stickkersz/greenhouse-iot-smart-farm/Hardware_Checklist.md

# 🔧 Hardware Checklist — BOM สมบูรณ์
**โปรเจกต์: IoT Smart Farm | อัปเดต: มิถุนายน 2569**

---

## สรุปสถานะ

| สถานะ | จำนวน |
|---|---|
| ✅ มีแล้ว / ซื้อมาแล้ว | 8 รายการ |
| 🛒 ต้องซื้อเพิ่ม | 11 รายการ |
| ⏳ รอของมาส่ง | 3 รายการ |

---

## ✅ มีแล้ว / ซื้อมาแล้ว

| # | อุปกรณ์ | จำนวน | สถานะ | หมายเหตุ |
|---|---|---|---|---|
| 1 | **ESP32 DevKit V1** | 1 | ✅ มีแล้ว | Dual-core, WiFi+BT, 30 pin |
| 2 | **Relay Module 4CH** (5V) | 1 | ✅ ซื้อแล้ว | ใน invoice QT0165876 |
| 3 | **DS18B20 Waterproof** | 1 | ✅ ซื้อแล้ว | วัดอุณหภูมิน้ำ |
| 4 | **XL4015 Step-Down 5A** | 1 | ✅ ซื้อแล้ว | 12V → 5V (ESP32 + Relay) |
| 5 | **Boost Converter 400W** | 1 | ✅ ซื้อแล้ว | 12V → 24V (ปั๊มน้ำ) |
| 6 | **ปั๊มน้ำ DC 24V Mini** | 1 | ⏳ รอส่ง | ทดสอบแรงดันก่อน — อาจต้องเปลี่ยน |
| 7 | **S-120-12 PSU** (12V 10A) | 1 | ✅ มีแล้ว | PSU หลัก (120W) |
| 8 | **Fan Module 5V** | 1 | ✅ ซื้อแล้ว | ระบายความร้อนในกล่อง IP65 — ต่อตรง XL4015 ไม่ผ่าน Relay |

---

## ⏳ รอของมาส่ง

| # | อุปกรณ์ | จำนวน | หมายเหตุ |
|---|---|---|---|
| 6 | **ปั๊มน้ำ DC 24V Mini** | 1 | ⚠️ ทดสอบแรงดันก่อน — ถ้าไม่ถึง 14 Bar ต้องเปลี่ยน |
| — | (รายการอื่นจาก invoice QT0165876) | — | รอส่ง |

---

## 🛒 ต้องซื้อเพิ่ม

### 🌡️ Sensor

| # | อุปกรณ์ | จำนวน | ราคาประมาณ | ซื้อที่ไหน | หมายเหตุ |
|---|---|---|---|---|---|
| 9 | **SHT40** (Temp + Humidity) | 1 | ~150–250฿ | Shopee / Lazada | แทน DHT22 — แม่นยำกว่า, I2C |
| 10 | **Capacitive Soil Moisture** | 1 | ~50–80฿ | Shopee | ไม่กัดกร่อน — ดีกว่าแบบ Resistive |

### 💧 ระบบน้ำ

| # | อุปกรณ์ | จำนวน | ราคาประมาณ | ซื้อที่ไหน | หมายเหตุ |
|---|---|---|---|---|---|
| 11 | **ถัง HDPE 100L** | 1 | ~300–500฿ | ร้านวัสดุภัณฑ์ / Lazada | เก็บน้ำ |
| 12 | **หัวฉีดหมอก** (รอยืนยันประเภท) | 18 | ~10–50฿/ชิ้น | Shopee | ⚠️ ขึ้นอยู่กับแรงดันปั๊ม |
| | — Option A: หัวฉีด 0.3mm (High Pressure) | 18 | ~30–50฿/ชิ้น | Shopee | ต้องการปั๊ม High Pressure ≥ 14 Bar |
| | — Option B: หัวฉีด Low Pressure | 18 | ~10–20฿/ชิ้น | Shopee | ใช้กับปั๊มมินิได้ (< 3 Bar) |
| 13 | **ท่อ PE 3/8"** | 20 เมตร | ~200–300฿ | ร้านวัสดุก่อสร้าง | ท่อหลักระบบน้ำ |
| 14 | **ข้อต่อท่อ PE** (T-joint, elbow, etc.) | ชุด | ~100–200฿ | ร้านวัสดุก่อสร้าง | ต่อสาขาหัวฉีด 3 แถว |
| 15 | **ปั๊มน้ำ High Pressure** (ถ้าเปลี่ยน) | 1 | ~1,000–3,000฿ | Shopee / Lazada | เฉพาะถ้าปั๊มมินิแรงดันไม่พอ |

### 💡 ไฟ LED

> ❌ **ยกเลิก** — ไม่ใช้ LED Grow Light ในโปรเจกต์นี้แล้ว

### 🌬️ พัดลม

| # | อุปกรณ์ | จำนวน | ราคาประมาณ | ซื้อที่ไหน | หมายเหตุ |
|---|---|---|---|---|---|
| 17 | **พัดลมชัตเตอร์แรงโน้มถ่วง 10"** AC 220V | 2 | ~500–800฿/ตัว | Shopee / ร้านไฟฟ้า | ระบายอากาศโรงเรือน — IN ขวา (Relay CH3), OUT ซ้าย (Relay CH2) |

### 🔌 ระบบไฟและกล่องควบคุม

| # | อุปกรณ์ | จำนวน | ราคาประมาณ | ซื้อที่ไหน | หมายเหตุ |
|---|---|---|---|---|---|
| 18 | **RCBO 16A** (กันดูดกันไฟกระชาก) | 1 | ~300–500฿ | ร้านไฟฟ้า | ป้องกัน PSU + พัดลม AC |
| 19 | **Control Box IP65** | 1 | ~200–400฿ | Shopee / ร้านไฟฟ้า | กล่องพลาสติกกันน้ำ ใส่ ESP32 + PSU |
| 20 | **PG16 Cable Gland** | 4 | ~20–40฿/ชิ้น | Shopee / ร้านไฟฟ้า | รูดายสายเข้ากล่อง IP65 |
| 21 | **ท่อ PVC 20mm** + ข้อต่อ | 5 เมตร | ~100฿ | ร้านวัสดุก่อสร้าง | เดินสายไฟ AC 220V นอกโรงเรือน |

---

## 💰 สรุปงบประมาณ

| หมวด | ราคาประมาณ |
|---|---|
| ซื้อแล้ว (invoice QT0165876) | 1,705฿ |
| S-120-12 PSU | ~600–800฿ |
| Sensor (SHT40 + Soil) | ~200–330฿ |
| ระบบน้ำ (ถัง + ท่อ + หัวฉีด + ข้อต่อ) | ~700–1,200฿ |
| LED 12V DC × 2 | ~600–1,200฿ |
| พัดลม × 2 | ~1,000–1,600฿ |
| ไฟและกล่องควบคุม | ~800–1,300฿ |
| ปั๊ม High Pressure (ถ้าต้องเปลี่ยน) | ~1,000–3,000฿ |
| **รวมทั้งหมด (ประมาณ)** | **~5,000–8,000฿** |

---

## ⚠️ จุดที่ต้องตัดสินใจก่อนซื้อ

### 1. ปั๊มน้ำ — ทดสอบแรงดันก่อน!
**เมื่อปั๊มมินิ 24V มาส่ง:**
- ต่อ Boost Converter → วัดแรงดันให้ได้ 24V → เปิดปั๊ม
- วัดแรงดันน้ำด้วย pressure gauge (ถ้ามี) หรือสังเกตการพ่นน้ำ
- ถ้าพ่นได้เป็นหมอกละเอียด → ใช้ได้ (Option B: Low Pressure nozzle)
- ถ้าพ่นเป็นสายน้ำ → แรงดันไม่พอ → ต้องซื้อปั๊ม High Pressure (Option A)

### 2. LED — ต้องยืนยันสเปกก่อนซื้อ
- ถามหัวหน้า/อาจารย์ว่าจะปลูกพืชอะไร
- พืชผักทั่วไป: Full Spectrum 3000K–6500K ก็พอ
- พืชดอก/ผล: ต้องการ Red:Blue = 3:1

### 3. หัวฉีด — ขึ้นอยู่กับปั๊ม
ซื้อหัวฉีดหลังจากทดสอบปั๊มแล้วเท่านั้น

---

## 📦 ของที่ต้องสั่งซื้อ (Priority Order)

```
ลำดับความสำคัญ:
1. SHT40               ← ทดสอบ firmware ได้เลย (ไม่ต้องรอปั๊ม)
2. Capacitive Soil      ← ทดสอบ ADC ได้เลย
3. ทดสอบปั๊มที่มี        ← วัดแรงดันก่อนตัดสินใจ
4. หัวฉีด + ท่อ PE       ← ซื้อหลังรู้แรงดันปั๊ม
5. LED 12V DC          ← ซื้อหลังยืนยันประเภทพืช
6. พัดลม 2 ตัว          ← ซื้อเมื่อพร้อมติดตั้ง
7. Control Box + RCBO  ← ซื้อพร้อมกับระยะติดตั้ง
```

---

*จัดทำโดย: Tonkla (IT Intern) | มิถุนายน 2569*
