stickkersz/greenhouse-iot-smart-farm/Greenhouse_Equipment_Layout_v2.md

# 🌿 Greenhouse Equipment Layout v2 (แก้ไขแล้ว)
**อัปเดต: June 2026 | หลังคาเอียง | 3-tier บันได | ปั๊ม 24V 14Bar | Grow Light | 2 พัดลม**

---

## 📐 โครงสร้างที่แก้ไขจาก Layout ที่ User วาด

| ส่วน | รายละเอียด (แก้ไขแล้ว) |
|---|---|
| หลังคา | **เอียง (Shed Roof)** ต่ำด้านหน้า → สูง 270cm ด้านหลัง |
| ประตู | ผนังหน้า (short wall 240cm, ด้านหลังคาต่ำ) |
| Bench | **3 tier ขวางความกว้าง 240cm** เรียงตามความยาว 460cm |
| Tier 1 | ต่ำสุด (~35cm) ใกล้ประตู |
| Tier 2 | กลาง (~65cm) |
| Tier 3 | สูงสุด (~100cm) ใกล้ผนังหลัง/หลังคาสูง |

---

## 💧 ระบบพ่นหมอก (ปรับปรุงแล้ว)

| พารามิเตอร์ | ค่าใหม่ |
|---|---|
| ปั๊ม | **24V DC Diaphragm, 14 Bar** |
| PSU ปั๊ม | Mean Well **S-100-24** (24V 4.5A = 108W) แยกออกจาก S-60-12 |
| หัวฉีด | **ทองเหลือง 0.3mm** (เปลี่ยนจาก 0.1mm) |
| จำนวนหัวฉีด | **6 หัว** (3 cross-bar × 2 หัวต่อ bar) |
| ท่อ cross-bar | 3 เส้นขวาง 240cm (เหนือ Tier 1, 2, 3 ตามลำดับ) |
| 2 หัวต่อ bar | ห่างผนัง 60cm และ 180cm (ครอบคลุม 240cm ด้วย radius ~90cm@14Bar) |
| ความสูงท่อ | ตามความลาดเอียงหลังคา: ~150cm (หน้า) → ~240cm (หลัง) |
| ท่อ PE ขนาด | 6mm OD |

### การเดินท่อ
- **Header pipe**: วิ่งตามผนังยาวด้านใดด้านหนึ่ง → T-connector → แยกเป็น 3 cross-bar
- **จุดเข้าท่อน้ำ**: ผนังหลัง (ด้านหลังคาสูง) มุมบน ระดับ 200cm → Grommet กันน้ำ
- **ถัง 100L**: วางนอกโรงเรือน ด้านหลัง-ตึก **ยกสูง 70cm** (platform คอนกรีต) → ลดแรงดันที่ปั๊มต้องสูบ

---

## 💡 Grow Light ระบบปลูกกลางคืน

| รายการ | รายละเอียด |
|---|---|
| LED Bar | 3 bar (1 bar ต่อ 1 tier) |
| ความยาวแต่ละ bar | **240cm** เต็มความกว้าง |
| ชนิด LED | **Full Spectrum 12V DC** (แนะนำ) หรือ 220V AC LED |
| กำลัง | ~30-50W ต่อ bar |
| ระยะจาก canopy | 30-50cm เหนือยอดต้นไม้ |
| ตำแหน่งยึด | Frame เหล็กระหว่าง tier + hook/สาย |
| ควบคุม | Relay CH4 + Timer module (เปิดอัตโนมัติตามเวลา) |
| ชั่วโมงแสง | 14-18 ชั่วโมง/วัน (ตั้งเวลาตามพืช) |

> ✅ **แนะนำ 12V DC LED**: ปลอดภัยกว่าในสภาพแวดล้อมชื้น ไม่มีไฟ AC ในโรงเรือน

---

## 🌀 พัดลม 2 ตัว

| | FAN 1 (Intake) | FAN 2 (Exhaust) |
|--|---|---|
| ตำแหน่ง | **ผนังหน้า** (กึ่งกลาง short wall) | **ผนังหลัง** (กึ่งกลาง short wall) |
| ระดับ | ~150cm (จำกัดด้วยหลังคาต่ำ) | ~220cm (หลังคาสูง 270cm) |
| ทิศทาง | **ดูดอากาศเข้า** | **ระบายอากาศออก** |
| ประเภท | Gravity Shutter AC 220V 10" | Gravity Shutter AC 220V 10" |
| Relay | CH3 | CH2 |

> อากาศไหล: เย็น/สดเข้าหน้า → ผ่าน tier 1→2→3 → ร้อน/ชื้นออกหลัง ✅

---

## ⚡ ระบบไฟฟ้า

### จุดเดินสายเข้า
- **Entry point**: ผนังหลัง (short wall ด้านหลังคาสูง) ระดับ 200-220cm
- เลือกตรงช่อง **frame เหล็ก** ที่มี **มุ้งกันแดด** (ไม่ใช่แผ่นพลาสติก)
- ใส่ **PG16 Cable Gland** หรือ **Liquid-Tight Connector** กันน้ำ

### เส้นทางสายจาก Control Box
```
ตึก → [ท่อ PVC 20mm] → RCBO 16A 30mA → Control Box IP65 (ผนังนอก-ตึก ระดับ 150cm)
                                                    │
                          ┌─────────────────────────┤
                          │                         │
                    S-60-12 (12V 5A)          S-100-24 (24V 4.5A)
                          │                         │
                   LM2596 (→5V)              Relay CH1 → ปั๊ม 24V (นอกโรง)
                          │
                    ESP32 + 4-Relay
                          │
              ┌───────────┼──────────────┐
              │           │              │
       CH2: FAN OUT  CH3: FAN IN   CH4: LED + DC 12V → เข้าโรงเรือน
       (220V conduit) (220V conduit) (DC 12V safe)
```

### สายภายในโรงเรือน
| สาย | ชนิด | วิ่งตาม |
|-----|---|---|
| DC 12V สำหรับ LED | 2 เส้น (2.5mm²) | rail เหล็กหลังคา → branch ลงแต่ละ tier |
| Signal SHT40 (I2C) | 4 เส้น (28AWG) | ยึดกับ frame ด้วย cable tie |
| Signal Soil Moisture | 3 เส้น | |
| DC 12V → Relay ESP32 | รวมในท่อ PVC 16mm | |

> ⚠️ **ไม่มี 220V AC ในโรงเรือนเลย** ถ้าใช้ LED 12V DC (แนะนำ)
> ⚠️ ถ้าต้องใช้ LED 220V → ให้ร้อยในท่อ rigid PVC ปิดสนิท ไม่สัมผัสน้ำ

---

## 📦 Control Box Contents (อัปเดต)

| อุปกรณ์ | สเปก | หน้าที่ |
|---|---|---|
| RCBO | 16A 30mA Panasonic | ตัดวงจรกรณีไฟรั่ว |
| S-60-12 | 12V 5A (60W) | ESP32, Relay, Sensor, LED(ถ้า 12V) |
| **S-100-24** | **24V 4.5A (100W)** | **ปั๊ม 24V 14Bar เท่านั้น** |
| LM2596 Buck | 12V→5V | จ่ายไฟ ESP32 |
| ESP32 | DevKit 38-pin | Main controller |
| 4-Relay Module | 5V trigger, 220V/10A | ควบคุมทั้งระบบ |
| Copper Ground Rod | ฝังดินด้านข้าง | กราวด์ระบบ |

---

## 🔌 Relay Mapping (อัปเดต)

| CH | ควบคุม | แรงดัน | เงื่อนไข Auto |
|----|---|---|---|
| CH1 | ปั๊ม 24V + Misting | 24V DC | T > 35°C หรือ RH < 60% |
| CH2 | FAN Exhaust (หลัง) | 220V AC | เปิดพร้อม CH1 |
| CH3 | FAN Intake (หน้า) | 220V AC | เปิดพร้อม CH1 หรือแยก |
| CH4 | LED Grow Lights × 3 | 12V DC | Timer (ตั้งเวลา) |

---

## 🏗️ เรื่องวัสดุโรงเรือน (มุ้ง + พลาสติก)

| ส่วน | วัสดุ | วิธีเดินสาย |
|---|---|---|
| ผนังล่าง | มุ้งกันแดด | ผ่านช่อง frame เหล็ก + PG Gland |
| ผนังบน | พลาสติกใส | ห้ามเจาะ → ผ่าน frame เหล็กรอยต่อ |
| หลังคา | พลาสติก + ตาข่าย | ยึดท่อ PE และสายกับ purlin ด้วย clamp |
| จุด entry | ผนังหลัง ระดับ 200cm | เลือก panel มุ้ง → ใส่ Liquid-Tight Connector |

---

## 📋 BOM เพิ่มเติม (อัปเดตจาก v1)

| รายการ | จำนวน | เปลี่ยนแปลง |
|---|---|---|
| **ปั๊ม 24V DC 14Bar** | 1 | ✅ เปลี่ยนจาก 12V |
| **Mean Well S-100-24** | 1 | ✅ เพิ่มใหม่ (24V PSU) |
| **หัวฉีด 0.3mm** | 6+2 สำรอง | ✅ เปลี่ยนจาก 0.1mm |
| **LED Grow Bar 240cm 12V** | 3 | ✅ เพิ่มใหม่ |
| **Timer Module** | 1 | ✅ เพิ่มใหม่ (สำหรับ LED) |
| **FAN 10" Gravity Shutter** | 2 | ✅ เพิ่มเป็น 2 ตัว |
| PG16 Cable Gland | 3 | สำหรับเดินสายผ่าน frame |
| Liquid-Tight Connector 3/4" | 2 | Entry point หลัก |
| ท่อ PE cross-bar 6mm | 3 × 240cm = 7.2m | ใหม่ (cross-bar) |
| ถัง 100L + platform | 1 set | ลดจาก 200L |

---

*อัปเดตโดย: Tonkla (IT Intern) | June 2026 | ข้อมูลจาก Layout ที่ User วาด + รูปถ่ายใหม่*
