stickkersz/greenhouse-iot-smart-farm/docs/Greenhouse_Equipment_Layout_v3.md

# 🌿 Greenhouse Equipment Layout v3 (Final)
**อัปเดต: June 2026 | ทิศทาง Tier และประตูถูกต้องแล้ว | Fan ผนัง 240cm | LED 12 ดวง | 18 หัวฉีด**

---

## 📐 โครงสร้างโรงเรือน

| ส่วน | รายละเอียด |
|---|---|
| ขนาด | **240cm (กว้าง/ลึก) × 460cm (ยาว) × 270cm (สูงสุด)** |
| หลังคา | **เอียง (Shed Roof)** — ต่ำด้านผนัง 240cm ฝั่งหนึ่ง (~170cm) → สูง 270cm อีกฝั่ง |
| ประตู | **ผนังยาว 460cm ตรงกึ่งกลาง** (กลาง 460cm = ห่างผนังสั้นแต่ละด้าน ~230cm) |
| Tier | **3 ชั้นบันได วิ่งตามแนว 460cm** เรียงซ้อนกันในทิศทาง 240cm |
| Tier 1 | ต่ำสุด (~35cm) — ใกล้ผนัง 460cm ด้านหน้า |
| Tier 2 | กลาง (~65cm) |
| Tier 3 | สูงสุด (~95cm) — ใกล้ผนัง 460cm ด้านหลัง (หลังคาสูง) |
| วัสดุปิด | มุ้งกันแดด + แผ่นพลาสติกใส (ห้ามเจาะพลาสติก) |

---

## 📊 Top View แผนผัง (ทิศทางถูกต้อง)

```
            ←————————— 460 cm (แนวยาว) —————————→

 ┌──────────────────────────────────────────────────────┐  ↑
 │ 💡💡💡💡 LED T3 (4×120cm) ╔══════════════════════╗ │  │
 │ [Tier 3 — สูง 95cm — วิ่งตลอด 460cm ============] │  │
 │                             ╚══════════════════════╝ │ 240
 │ 💡💡💡💡 LED T2 (4×120cm) ╔══════════════════════╗ │  cm
 │ [Tier 2 — กลาง 65cm — วิ่งตลอด 460cm ===========] │  │
 │                             ╚══════════════════════╝ │  │
 │ 💡💡💡💡 LED T1 (4×120cm) ╔══════════════════════╗ │  │
 │ [Tier 1 — ต่ำ 35cm — วิ่งตลอด 460cm ============] │  │
 │                [🚪 ประตูกลาง 460cm]                │  ↓
 └──────────────────────────────────────────────────────┘
 │                                                      │
FAN OUT                                              FAN IN
(ผนัง 240cm ซ้าย)               ลมไหล → → →    (ผนัง 240cm ขวา)
```

**ลมไหลตามแนว 460cm**: เข้าผนังสั้นขวา (Fan IN) → ผ่านทุก Tier → ออกผนังสั้นซ้าย (Fan OUT)

---

## 💧 ระบบพ่นหมอก (Misting System)

### การคำนวณหัวฉีด

| พารามิเตอร์ | ค่า |
|---|-----|
| หัวฉีด | ทองเหลือง **0.3mm** |
| ความดัน | **14 Bar** (จากปั๊ม 24V Diaphragm) |
| ระยะ spray radius จริง (รวม drift) | ~**60-80cm** |
| ระยะห่างหัวฉีดที่เหมาะสม | **65cm** (overlap ดี) |
| จำนวนหัวต่อ tier (460cm ÷ 65cm) | **≈ 6 หัว** |
| จำนวน tier | 3 |
| **รวมหัวฉีด** | **18 หัว** (+ 4 สำรอง = สั่งซื้อ 22 หัว) |

### การวางท่อ

| รายการ | รายละเอียด |
|---|---|
| **เส้นท่อหลัก (Header)** | วิ่งตามผนัง 240cm ฝั่งใดฝั่งหนึ่ง → T-connector แยก 3 เส้น |
| **ท่อมิสติ้ง** | 3 เส้น วิ่งตาม **แนว 460cm** เหนือแต่ละ Tier |
| **ท่อ Tier 1** | สูง ~100cm เหนือระดับ Tier (หลังคาต่ำ) |
| **ท่อ Tier 2** | สูง ~100cm เหนือระดับ Tier |
| **ท่อ Tier 3** | สูง ~100cm เหนือระดับ Tier (ใกล้หลังคาสูง) |
| ท่อ PE | 6mm OD |
| ระยะห่างหัวฉีด | ~65cm (6 หัวต่อเส้น ×3 เส้น = **18 หัว**) |
| จุดเชื่อมต่อ | Header → ผนัง 240cm → PG16 Gland → ท่อ PE จากปั๊ม |

```
ปั๊ม 24V → [ท่อ PE 6mm] → Grommet PG16 → Header วิ่งตาม 240cm
                                                    │
                               ┌────────────────────┤
                               │                    │
                    T1: ①②③④⑤⑥        T2: ①②③④⑤⑥
                    (460cm, 6 หัว)      (460cm, 6 หัว)
                               │
                    T3: ①②③④⑤⑥
                    (460cm, 6 หัว)
```

---

## 💡 Grow Light ระบบปลูกกลางคืน

### การคำนวณ LED

| พารามิเตอร์ | ค่า |
|---|-----|
| ความยาวสูงสุดต่อดวง | **120cm** |
| ความยาว Tier | 460cm |
| จำนวนดวงต่อ Tier | 460 ÷ 120 ≈ 3.8 → **4 ดวง** |
| 3 Tiers × 4 ดวง | **= 12 ดวงรวม** (+ 1 สำรอง = สั่งซื้อ 13 ดวง) |
| การวาง | 4 ดวง × 120cm = 480cm → เหลื่อมเล็กน้อย หรือเว้นช่องปลาย ~10cm |

| รายการ | รายละเอียด |
|---|---|
| LED Bar | **Full Spectrum 12V DC, 120cm** |
| กำลัง | ~30W/ดวง × 12 = **360W รวม** |
| PSU สำหรับ LED | **Mean Well LRS-350-12** (12V 29A = 350W) — แยกออกจาก S-60-12 |
| ระยะจาก canopy | 30-50cm เหนือยอดต้น |
| ยึด | Hook + สาย สเตนเลส แขวนกับ purlin หลังคา |
| ควบคุม | Relay CH4 + Timer Module (DC 12V) |
| เวลาเปิด | 14-18 ชั่วโมง/วัน |

> ✅ **12V DC ในโรงเรือน** = ปลอดภัยสูงสุด ไม่มี 220V AC ในโรงเรือน

---

## 🌀 พัดลม (Fan)

| | FAN IN (ดูดอากาศเข้า) | FAN OUT (ระบายออก) |
|--|---|---|
| **ตำแหน่ง** | **ผนังสั้น 240cm ด้านขวา** | **ผนังสั้น 240cm ด้านซ้าย** |
| ระดับติดตั้ง | กึ่งกลาง ~150cm | กึ่งกลาง ~150cm |
| ทิศทาง | ดูดอากาศสด/เย็นเข้า | ระบายอากาศร้อน/ชื้นออก |
| ประเภท | **Gravity Shutter 10" AC 220V** | **Gravity Shutter 10" AC 220V** |
| Relay | CH3 | CH2 |
| Conduit | ท่อ PVC ด้านนอกผนัง | ท่อ PVC ด้านนอกผนัง |

> อากาศไหล: เข้าผนังสั้นขวา → ผ่าน Tier 1→2→3 ตามแนว 460cm → ออกผนังสั้นซ้าย ✅

---

## ⚡ ระบบไฟฟ้า

### แผนผังรวม

```
220V จากตึก
     │
     ▼
[ท่อ PVC 20mm ติดผนังตึก]
     │
     ▼
RCBO 16A 30mA (Panasonic)
     │
     ▼
Control Box IP65 (ผนังนอกโรงเรือน ด้าน 460cm ระดับ 150cm)
     │
     ├── S-60-12 (12V 5A) → LM2596 (→5V) → ESP32 + 4-Relay Module
     │                                │
     │                    ┌───────────┼──────────────┐
     │                    │           │              │
     │              CH2: FAN OUT  CH3: FAN IN   CH4: Timer → LED 12V
     │              (220V/AC)     (220V/AC)     (12V DC → PG16 → โรงเรือน)
     │
     └── LRS-350-12 (12V 29A) → CH4 Relay → LED 12 ดวง (360W)
     │
     └── S-100-24 (24V 4.5A) → CH1 Relay → ปั๊ม 24V 14 Bar (นอกโรงเรือน)
     │
     └── กราวด์ → แท่งทองแดง 60cm ฝังดิน
```

### จุดผ่านผนัง (PG16 Liquid-Tight Gland)

| จุด | สาย | ผ่านผนังใด |
|-----|-----|---|
| จุด 1 | DC 12V → LED, Sensor | ผนัง 460cm (เลือกช่อง frame มุ้งกันแดด) |
| จุด 2 | ท่อน้ำ PE จากปั๊ม | ผนัง 460cm หรือ 240cm (ใกล้ header) |
| จุด 3 | 220V → FAN IN | ผนัง 240cm ด้านขวา (จากด้านนอก) |
| จุด 4 | 220V → FAN OUT | ผนัง 240cm ด้านซ้าย (จากด้านนอก) |

> ⚠️ **ห้ามเจาะแผ่นพลาสติกใส** — เลือกจุดที่เป็นมุ้งกันแดด หรือผ่านรอยต่อ frame เหล็กเสมอ

### สายภายในโรงเรือน

| สาย | ชนิด | เส้นทาง |
|-----|---|---|
| DC 12V → LED | 2.5mm² | จาก PG16 Gland → Rail เหล็กหลังคา → branch แต่ละ Tier |
| SHT35 (I2C) | 28AWG 4 เส้น | ยึดกับ frame ด้วย cable tie |
| DS18B20 (1-Wire) | 22AWG | จากกล่องควบคุม → ถังน้ำด้านนอก |
| Soil Moisture (Analog) | 3 เส้น | ปักใน Tier ที่เลือก |

---

## 🔌 Relay Mapping

| CH | ควบคุม | แรงดัน | เงื่อนไข Auto |
|----|---|---|---|
| CH1 | ปั๊ม 24V + มิสติ้ง 18 หัว | 24V DC | T > 35°C หรือ RH < 60% |
| CH2 | FAN OUT (ผนัง 240cm ซ้าย) | 220V AC | เปิดพร้อม CH1 |
| CH3 | FAN IN (ผนัง 240cm ขวา) | 220V AC | เปิดพร้อม CH1 หรือแยกควบคุม |
| CH4 | LED Grow Lights 12 ดวง | 12V DC | Timer (ตั้งเวลา 14-18hr) |

---

## 🪣 ถัง + ปั๊ม (ด้านนอกโรงเรือน)

| รายการ | รายละเอียด |
|---|---|
| ถัง | **100L** วางนอกโรงเรือน มุมด้านหลัง ใกล้ผนัง 460cm |
| ยกสูง | **70cm** (platform คอนกรีต/เหล็ก) |
| ลูกลอย | 1/2" — เติมน้ำอัตโนมัติ |
| Filter | Suction Filter สแตนเลส ด้านดูดปั๊ม |
| ปั๊ม | **24V DC Diaphragm 14 Bar** — วางใกล้ถัง ด้านนอก |
| PSU ปั๊ม | **Mean Well S-100-24** (24V 4.5A) |
| ท่อจ่าย | PE 6mm จากปั๊ม → PG16 Gland → Header ในโรงเรือน |

---

## 📦 Control Box Contents

| อุปกรณ์ | สเปก | หน้าที่ |
|---|---|---|
| RCBO | 16A 30mA Panasonic | ตัดวงจรกรณีไฟรั่ว |
| S-60-12 | 12V 5A (60W) | ESP32, Relay, Sensor |
| **S-100-24** | **24V 4.5A (100W)** | ปั๊ม 24V 14Bar โดยเฉพาะ |
| **LRS-350-12** | **12V 29A (350W)** | LED Grow Light 12 ดวง |
| LM2596 Buck | 12V → 5V | จ่ายไฟ ESP32 |
| ESP32 | DevKit 38-pin | Main controller |
| 4-Relay Module | 5V trigger, 10A | CH1-4 |
| Timer Module | DC 12V | ตั้งเวลา LED แยกจาก relay |
| Copper Ground Rod | 60cm | กราวด์ระบบ |

---

## 📋 BOM รวม (v3 Final)

| # | รายการ | สเปก | จำนวน | สถานะ |
|---|---|---|---|---|
| 1 | ESP32 | DevKit 38-pin | 1 | มีแล้ว |
| 2 | 4-Relay Module | 5V trigger | 1 | มีแล้ว |
| 3 | S-60-12 PSU | 12V 5A | 1 | มีแล้ว |
| 4 | **S-100-24 PSU** | 24V 4.5A | 1 | ซื้อใหม่ |
| 5 | **LRS-350-12 PSU** | 12V 29A 350W | 1 | ซื้อใหม่ (LED) |
| 6 | LM2596 Buck | 12V→5V | 1 | ซื้อใหม่ |
| 7 | RCBO | 16A 30mA Panasonic | 1 | ซื้อใหม่ |
| 8 | **ปั๊ม 24V DC Diaphragm** | 14 Bar | 1 | ซื้อใหม่ |
| 9 | **หัวฉีด 0.3mm ทองเหลือง** | — | 22 (18+4 สำรอง) | ซื้อใหม่ |
| 10 | ท่อ PE | 6mm OD | 20m | ซื้อใหม่ |
| 11 | T-connector PE 6mm | — | 8 | ซื้อใหม่ |
| 12 | End cap PE 6mm | — | 4 | ซื้อใหม่ |
| 13 | ถัง 100L | + ลูกลอย 1/2" | 1 | มีแล้ว (บริษัท) |
| 14 | Filter สแตนเลส | ด้านดูด | 1 | ซื้อใหม่ |
| 15 | **LED Grow Bar 120cm 12V DC** | Full Spectrum | 13 (12+1 สำรอง) | ซื้อใหม่ |
| 16 | Timer Module | DC 12V | 1 | ซื้อใหม่ |
| 17 | **Fan 10" Gravity Shutter** | AC 220V | 2 | ซื้อใหม่ |
| 18 | SHT35 | I2C | 1 | ซื้อใหม่ |
| 19 | DS18B20 | Waterproof IP68 | 1 | ซื้อใหม่ |
| 20 | Capacitive Soil Moisture | 3.3V/5V | 1 | มีแล้ว |
| 21 | กล่อง IP65 | ≥250×300mm | 1 | ซื้อใหม่ |
| 22 | PG16 Liquid-Tight Gland | — | 4 | ซื้อใหม่ |
| 23 | แท่งกราวด์ทองแดง | 60cm | 1 | ซื้อใหม่ |
| 24 | ท่อ PVC 20mm + fitting | — | 3m | ซื้อใหม่ |
| 25 | Terminal Block + สาย | — | 1 set | ซื้อใหม่ |
| 26 | Hook + สาย สเตนเลส | — | 15 set | ซื้อใหม่ (แขวน LED) |

---

## ⚠️ สิ่งที่ยังต้องยืนยัน

1. **ขนาดประตูจริง** — ยังไม่ทราบ ให้วัดก่อนสั่ง Frame
2. **สเปกปั๊ม 24V 14 Bar** — ตรวจ Flow Rate ≥3 LPM (รองรับ 18 หัวพร้อมกัน)
3. **ระยะ 220V จากตึก** → Control Box — วัดก่อนสั่งท่อ PVC
4. **ผนัง 240cm ด้านไหนชิดตึง** → ให้ Fan OUT อยู่ด้านที่มีช่องระบายลมได้ดีกว่า
5. **LED กำลังไฟ** — ถ้าใช้ดวงละ 30W × 12 = 360W → LRS-350-12 พอดี ถ้าเกิน 30W/ดวง → อัปเป็น LRS-500-12

---

## ✅ ลำดับการติดตั้ง

1. **วาง Control Box** ผนังนอก 460cm → ต่อท่อ PVC 20mm จากตู้ไฟตึก
2. **ติด RCBO + PSU 3 ตัว** ในกล่อง → ทดสอบแรงดัน
3. **ร้อยสาย DC 12V** ผ่าน PG16 Gland → เข้าโรงเรือน → ไปตาม rail หลังคา
4. **ติด LED Bar** ทั้ง 12 ดวง แขวนเหนือแต่ละ Tier → ต่อสาย 12V
5. **เดินท่อ PE** Header ตาม 240cm → T แยก 3 เส้น × 460cm → ใส่หัวฉีด 6 หัว/เส้น
6. **วางถัง + ปั๊ม** นอกโรงเรือน มุมหลัง → ต่อท่อ PE ผ่าน PG16
7. **ติด Fan** ผนัง 240cm ซ้าย-ขวา → เดินท่อ PVC 220V ด้านนอก
8. **ติดเซนเซอร์** SHT35 (ระดับ 120cm กลางโรง), DS18B20 (ในถัง), Soil Moisture
9. **Wiring ESP32 + Relay** ใน Control Box → Upload Firmware
10. **ทดสอบ** ทีละ Channel → ตรวจหัวฉีด, LED, Fan, เซนเซอร์

---

*อัปเดตโดย: Nattakit Prasertsak (IT Intern) | June 2026 | v3 Final — แก้ไขทิศทาง Tier, Fan ผนัง 240cm, LED 12 ดวง, 18 หัวฉีด*
