stickkersz/greenhouse-iot-smart-farm/pinout.docx

# สรุป Pinout การต่อสายทั้งหมด

Firmware v1.4.0 | ESP32 DevKit V1 30-pin + Expansion Board HW-777 | 1 กรกฎาคม 2569

## 1. ESP32 GPIO → Sensor / Component Connections

GPIO Pin | อุปกรณ์ (Component) | Pin ที่ต่อ | หมายเหตุ
GPIO 4 | DS18B20 Waterproof | DATA | ต้องมี External Pull-up 5.1kΩ ระหว่าง VCC–DATA ที่ฝั่ง ESP32 (ไม่ใช่ฝั่ง sensor)
GPIO 32 | DHT22 | DATA (Pin 2) | Pin 1=VCC, Pin 2=DATA, Pin 3=NC (ไม่ต่อ), Pin 4=GND — ใช้จริง 3 สาย
GPIO 33 | Buzzer Module (Active) | I/O | ลำดับ Pin ซ้าย→ขวา: GND – I/O – VCC
GPIO 34 | Capacitive Soil Moisture | Signal (S) | ADC1 Input-Only — ห้ามต่อ Output หรือ Pull-up ภายใน
GPIO 21 | LCD I2C 16x2 | SDA | I2C Default ESP32 — Address 0x27 — ต้องการไฟ 5V (ไม่ใช่ 3.3V)
GPIO 22 | LCD I2C 16x2 | SCL | I2C Default ESP32 — ต่อร่วมกับ SDA (รวม 4 สาย: VCC, GND, SDA, SCL)
GPIO 26 | Relay Module CH1 | IN1 | CH1 = ช่องสำรอง — manual/schedule เท่านั้น (ไม่มี auto mode)
GPIO 27 | Relay Module CH2 | IN2 | CH2 = ไม่ได้ใช้ — ซ่อนใน Dashboard ค้าง OFF ตลอดเวลา
GPIO 14 | Relay Module CH3 | IN3 | CH3 = พัดลม 220V AC — auto: เปิดเมื่ออุณหภูมิ ≥ 35°C
GPIO 25 | Relay Module CH4 | IN4 | CH4 = ปั๊มน้ำ 24V DC — auto: เปิดเมื่อ Humidity < 60% (max 5 นาที/ครั้ง)

⚠️ GPIO12 ห้ามใช้กับ Relay เพราะเป็น Strapping Pin (ทำให้ boot fail) | GPIO34 เป็น ADC1 Input-Only

## 2. Relay Module 4CH — Output Wiring

Relay Channel | โหลด (Load) | Terminal ที่ต่อ | เงื่อนไข / หมายเหตุ | Mode
CH1 GPIO 26 | สำรอง (ยังไม่กำหนด) | NO → COM | สั่งงานผ่าน Dashboard (manual/schedule) เท่านั้น ยังไม่มีโหลดต่ออยู่ | manual
CH2 GPIO 27 | — | — | ซ่อนใน Dashboard — ค้าง OFF เสมอ ไม่มีโหลดต่ออยู่ | —
CH3 GPIO 14 | พัดลม 220V AC ×2 | NO → COM → L | ช่างไฟเดินสาย AC — Neutral ต่อตรงโดยไม่ผ่าน Relay | auto
CH4 GPIO 25 | ปั๊มน้ำ 24V DC | NO → COM | Boost Converter OUT− ต่อตรงขั้ว − ปั๊ม (Common GND — ไม่ผ่าน Relay) | auto

⚠️ Active-LOW: ส่ง LOW=เปิด(ON), ส่ง HIGH=ปิด(OFF) | ใช้ขา NO (Normally Open) เสมอ, ห้ามใช้ NC

## 3. Power Distribution

จาก (From) | ไป (To) | Terminal / สาย | ขนาดสาย | หมายเหตุ
220V AC Line | S-120-12 PSU (12V/10A) | L, N, PE | 1.5 mm² | L=Phase สีน้ำตาล, N=Neutral สีน้ำเงิน, PE=Earth สีเหลือง-เขียว
S-120-12 (+V=12V, −V) | XL4015 Step-Down (IN+, IN−) | IN+, IN− | 1.0 mm² | Input 12V → Output 5V ปรับ Trimpot ให้ได้ 5.0V ก่อนต่อ ESP32
XL4015 Step-Down (OUT+=5V) | ESP32 Expansion Board HW-777 | OUT+→5V, OUT−→GND | 0.5–1.0 mm² | จ่ายไฟ ESP32, Relay IN, Buzzer, Fan 5V, LCD VCC (ทุก logic)
S-120-12 (+V=12V, −V) | Boost Converter (IN+, IN−) | IN+, IN− | 1.5 mm² | Input 12V → Output 24V สำหรับปั๊มน้ำ
Boost Converter (OUT+, OUT−) | Relay CH4 (COM) | OUT+ → COM | 1.5 mm² | ปรับ Trimpot Boost ให้ได้ 24V ก่อนต่อ Relay
Relay CH4 (NO) | ปั๊มน้ำ DC 24V (ขั้ว +) | สายแดง | 1.5 mm² | ไฟ 24V ผ่าน Relay → ขั้ว + ปั๊ม
Boost Converter (OUT−) | ปั๊มน้ำ DC 24V (ขั้ว −) | สายดำ | 1.5 mm² | GND ต่อตรง ไม่ผ่าน Relay — Common GND ทั้งระบบ

⚠️ Common GND — ทุก component ต้องต่อ GND ร่วมกัน | ปิดไฟก่อนต่อ/ถอดสาย Boost Converter และปั๊มน้ำเสมอ

## 4. Pinout อุปกรณ์แต่ละตัว

4a. DHT22 — วัดอุณหภูมิ + ความชื้นอากาศ (GPIO 32)

Pin (ซ้ายไปขวา) | ชื่อสัญญาณ | ต่อกับ
Pin 1 | VCC | 3.3V หรือ 5V (Expansion Board 5V rail)
Pin 2 | DATA | GPIO 32
Pin 3 | NC | ไม่ต่อ (No Connect) — ข้ามไป
Pin 4 | GND | GND (Common Ground)

4b. DS18B20 Waterproof — วัดอุณหภูมิน้ำ (GPIO 4) — จับ Flat Side หันหาตัวเอง

ตำแหน่ง (Flat Side หันหาตัวเอง) | ชื่อสัญญาณ | ต่อกับ
ซ้าย (Left) | GND | GND (Common Ground)
กลาง (Middle) | DATA | GPIO 4 + Pull-up 5.1kΩ ต่อ VCC ที่ฝั่ง ESP32
ขวา (Right) | VCC | 3.3V หรือ 5V

⚠️ ใส่ผิดด้านจะอ่านค่า -127°C | Pull-up 5.1kΩ ต้องอยู่ฝั่ง ESP32 | สายยาว 5m ใช้ PVC Conduit กันน้ำ

Active-LOW Relay: LOW=เปิด HIGH=ปิด | ห้ามใช้ GPIO12 กับ Relay (Strapping Pin) | LCD I2C ต้องการไฟ 5V ไม่ใช่ 3.3V หน้า

Greenhouse IoT Smart Farm — Pinout & Wiring Summary บริษัทประวิทย์กรุ๊ป ปุ๋ยไวกิ้ง จำกัด | ESP32 Firmware v1.4.0 | Tonkla (KMUTT)
