stickkersz/greenhouse-iot-smart-farm/docs/reports/รายงานฉบับสมบูรณ์ - Greenhouse IoT Smart Farm.docx

🌿

รายงานฉบับสมบูรณ์

(Final Project Report)

โครงการพัฒนาระบบควบคุมสภาพแวดล้อมโรงเรือนอัตโนมัติ

Greenhouse IoT Smart Farm

ระบบควบคุมพัดลม + ปั๊มพ่นหมอกอัตโนมัติด้วย ESP32 + Firebase พร้อม Web Dashboard

จัดทำโดย

นายณัฐกิตติ์ (Tonkla)

นักศึกษาฝึกงานแผนก IT · ชั้นปีที่ 2 สาขาวิทยาการคอมพิวเตอร์ (Computer Science)

มหาวิทยาลัยเทคโนโลยีพระจอมเกล้าธนบุรี (KMUTT)

สถานประกอบการฝึกงาน: บริษัท ปุ๋ยไวกิ้ง จำกัด

ระยะเวลาฝึกงาน: มิถุนายน – กรกฎาคม 2569

วันที่จัดทำรายงาน: สิงหาคม 2569

# สารบัญ

1. บทสรุปผู้บริหาร

2. ที่มาและความสำคัญของโครงการ

3. วัตถุประสงค์และขอบเขตการดำเนินงาน

4. ภาพรวมระบบที่พัฒนา

5. สถาปัตยกรรมระบบ

6. ฮาร์ดแวร์ที่ติดตั้งจริง

7. ซอฟต์แวร์ที่พัฒนา

8. ระยะเวลาดำเนินงานและเหตุการณ์สำคัญ

9. ผลการทดสอบระบบ

10. ปัญหาที่พบระหว่างดำเนินงานและแนวทางแก้ไข

11. งบประมาณ

12. สิ่งที่ส่งมอบ (Deliverables)

13. ข้อจำกัดและงานที่ยังไม่แล้วเสร็จ

14. ข้อเสนอแนะสำหรับการพัฒนาต่อ

15. บทสรุป

16. ภาคผนวก

# 1. บทสรุปผู้บริหาร

บริษัท ปุ๋ยไวกิ้ง จำกัด มอบหมายให้นักศึกษาฝึกงานแผนก IT พัฒนาระบบควบคุมสภาพแวดล้อมอัตโนมัติสำหรับโรงเรือนปลูกผัก ขนาด 240×460×270 ซม. เพื่อรักษาอุณหภูมิและความชื้นให้อยู่ในช่วงที่เหมาะสม รองรับงานวิจัยด้านการเกษตรที่ต้องควบคุมสภาพแวดล้อมย่อย (Microclimate) ให้แม่นยำ

ขอบเขตงานเดิมที่วางแผนไว้คือระบบควบคุมแบบออฟไลน์ (ตู้คอนโทรลอุณหภูมิ + USB Data Logger) แต่ระหว่างดำเนินงานทีมได้ปรับแนวทางมาใช้บอร์ด ESP32 ร่วมกับ Firebase Realtime Database และพัฒนา Web Dashboard ขึ้นเอง เพื่อให้พนักงานหลายคนสามารถติดตามและสั่งงานระบบได้พร้อมกันแบบเรียลไทม์ผ่านเบราว์เซอร์ ทั้งบนคอมพิวเตอร์และมือถือ ซึ่งเป็นการขยายขอบเขตจากแผนเดิมอย่างมีนัยสำคัญ

ผลการดำเนินงาน ณ สิ้นสุดการฝึกงาน ระบบสามารถควบคุมพัดลมและปั๊มพ่นหมอกให้ทำงานอัตโนมัติตามอุณหภูมิ/ความชื้นได้จริง ทำงานได้แม้ไม่มีอินเทอร์เน็ต (offline-first control) มีระบบความปลอดภัยป้องกันปั๊มทำงานต่อเนื่องเกินกำหนด มี Dashboard ที่ใช้งานได้จริงสำหรับพนักงานทั่วไป พร้อมชุดทดสอบอัตโนมัติ (unit test) สำหรับ logic การควบคุมและกฎความปลอดภัยของฐานข้อมูล และมีเอกสารประกอบครบชุด (คู่มือการใช้งาน, ผังพิน, บันทึกปัญหา-วิธีแก้)

ไฮไลต์สำคัญ

ระบบควบคุมทำงานอัตโนมัติได้จริงในสภาพแวดล้อมโรงเรือนจริง ไม่ใช่แค่ต้นแบบทดลอง

ผ่านการทดสอบเชิงวิศวกรรม (A/B test) เพื่อพิสูจน์ต้นตอปัญหาความไม่เสถียรว่าเป็น hardware ไม่ใช่ firmware

มีชุด automated test 3 ชุด (logic / rules / cross-layer sync) ซึ่งเกินมาตรฐานทั่วไปของโปรเจกต์ระดับนักศึกษาฝึกงาน

เอกสารประกอบครบถ้วน พร้อมส่งต่อให้ทีมงานที่ไม่มีพื้นฐาน IT ใช้งานต่อได้

# 2. ที่มาและความสำคัญของโครงการ

บริษัท ปุ๋ยไวกิ้ง จำกัด มีโรงเรือนปลูกผักสลัดขนาดเล็ก (~11 ตร.ม.) ที่ใช้สนับสนุนงานวิจัยด้านปุ๋ย ซึ่งจำเป็นต้องควบคุมอุณหภูมิและความชื้นภายในโรงเรือนให้อยู่ในช่วงที่เหมาะสม เพื่อลดความเครียดจากความร้อน (Heat Stress) ของพืช และป้องกันภาวะผิดปกติทางสรีรวิทยา เช่น อาการใบไหม้ (Tip burn) ที่จะทำให้ผลการวิจัยคลาดเคลื่อน

แนวคิดเริ่มต้นของโครงการคือการติดตั้งระบบพ่นหมอกอัตโนมัติ (Automated Misting System) ที่สั่งงานด้วยเซนเซอร์วัดอุณหภูมิ/ความชื้น ทำงานคู่กับพัดลมระบายอากาศ เพื่อรักษาอุณหภูมิไม่ให้เกิน 35°C โดยไม่ให้ความชื้นสัมพัทธ์สูงจนขัดขวางกลไกการคายน้ำของพืช แผนเดิมเสนอให้ใช้ตู้คอนโทรลอุณหภูมิแบบดิจิทัล (เช่น STC-3028) ร่วมกับ USB Data Logger แบบออฟไลน์ล้วน เพื่อความเสถียรสูงสุดโดยไม่พึ่งพา WiFi

ขอบเขตงานที่มอบหมายให้นักศึกษาฝึกงานแผนก IT แบ่งเป็น 3 ระยะตามแผนเดิม ได้แก่ (1) Hardware Engineering & Safety — ประกอบตู้คอนโทรลและวางระบบไฟฟ้าปลอดภัย (2) Offline Data Logging System — บันทึกข้อมูลสภาพแวดล้อม และ (3) Data Pipeline & Cleansing — จัดการข้อมูลดิบให้พร้อมวิเคราะห์ทางสถิติ โดยมีเป้าหมายให้ทีมวิจัยด้านการเกษตรนำข้อมูลไปใช้ต่อได้ทันที

# 3. วัตถุประสงค์และขอบเขตการดำเนินงาน

## วัตถุประสงค์

- ออกแบบและติดตั้งระบบควบคุมอุณหภูมิ/ความชื้นในโรงเรือนแบบอัตโนมัติ ที่มีความปลอดภัยทางไฟฟ้าสูง
- พัฒนาระบบบันทึกและแสดงผลข้อมูลสภาพแวดล้อม (Microclimate) แบบต่อเนื่อง เพื่อสนับสนุนงานวิจัย
- สร้างช่องทางให้ทีมงานที่ไม่มีพื้นฐาน IT สามารถติดตามและปรับตั้งค่าระบบได้ด้วยตนเอง
- จัดทำเอกสารประกอบให้ครบถ้วน เพื่อให้ทีมงานดูแลต่อได้ในระยะยาว

## ขอบเขตงานจริงเทียบกับแผนเดิม

หัวข้อ | แผนเดิม (ข้อเสนอเริ่มต้น) | สิ่งที่พัฒนาจริง
ตัวควบคุม | ตู้คอนโทรลอุณหภูมิดิจิทัล (STC-3028) แบบ standalone | ESP32 + Firebware — ควบคุมอัตโนมัติในตัวบอร์ด (offline-first) พร้อมเชื่อม Firebase เมื่อมีเน็ต
การบันทึกข้อมูล | USB Data Logger แบบออฟไลน์ล้วน ดึงข้อมูลด้วยมือ | บันทึกขึ้น Firebase อัตโนมัติทุก 30 วิ + สรุปรายชั่วโมง ดูย้อนหลังผ่านกราฟบนเว็บได้ทันที
การสั่งงาน/ติดตาม | อ่านค่าที่หน้าจอตู้คอนโทรลเท่านั้น | Web Dashboard หลายผู้ใช้พร้อมกัน, สลับ Auto/Manual/Schedule, ตั้งค่าจากเว็บ
การแจ้งเตือน | ไม่มีในแผนเดิม | Buzzer หน้างาน + แจ้งเตือนบน Dashboard + ประวัติการแจ้งเตือน
การทดสอบซอฟต์แวร์ | ไม่ได้ระบุ | ชุด unit test อัตโนมัติ 3 ชุด (logic / Firebase rules / cross-layer constant sync)

เหตุผลของการปรับแนวทาง

ระหว่างดำเนินงานทีมเห็นว่าการมี Dashboard แบบเรียลไทม์ที่พนักงานหลายคนเข้าถึงพร้อมกันได้ ตอบโจทย์การใช้งานจริงของทีมงานมากกว่าตู้คอนโทรลแบบอ่านค่าหน้าจอเดียว โดยยังคงหลักการ offline-first ไว้ — ระบบควบคุมหลักทำงานอยู่ในตัว ESP32 เอง ไม่พึ่งพา WiFi/Firebase ในการตัดสินใจ จึงได้ทั้งความเสถียรของแผนเดิมและความสะดวกของระบบออนไลน์

# 4. ภาพรวมระบบที่พัฒนา

รายการ | รายละเอียด
ขนาดโรงเรือน | 240 (กว้าง) × 460 (ยาว) × 270 (สูงสุด) ซม. หลังคาเอียง พื้นที่ ~11 ตร.ม.
โครงสร้างปลูก | 3 ชั้น (Tier) วิ่งตามแนวยาว พร้อมไฟ LED ปลูกพืชประจำแต่ละชั้น
ระบบพ่นหมอก | หัวฉีดทองเหลือง 0.3 มม. รวม 18 หัว (6 หัว × 3 ชั้น) ระยะห่าง ~65 ซม./หัว
อุปกรณ์ควบคุมหลัก | พัดลมดูดอากาศ 220V AC (evaporative cooling) และปั๊มน้ำพ่นหมอก 24V DC
สมองกลควบคุม | ESP32 DevKit V1 บน Expansion Board HW-777
ช่องทางสั่งงาน/ติดตาม | Web Dashboard (Firebase Hosting) — เข้าได้ทุกที่ที่มีอินเทอร์เน็ต

# 5. สถาปัตยกรรมระบบ

ระบบแบ่งเป็น 3 ชั้น (layer) ที่ deploy แยกจากกันได้อิสระ ทำให้แก้ไข/อัปเดตแต่ละส่วนโดยไม่กระทบส่วนอื่นทั้งหมด:

ชั้น (Layer) | แหล่งโค้ด | วิธี deploy | ทำงานบน
Firmware | smartfarm_firmware/ | arduino-cli upload (flash เข้าบอร์ด) | ESP32
Rules (ความปลอดภัยข้อมูล) | database.rules.json | firebase deploy --only database | Firebase Cloud
Dashboard | dashboard/ | firebase deploy --only hosting | เบราว์เซอร์ ผ่าน Firebase Hosting

หลักการออกแบบ: Offline-first

บอร์ด ESP32 อ่านค่าเซนเซอร์และตัดสินใจเปิด/ปิดพัดลม-ปั๊มด้วยตัวเองจากค่าที่เก็บใน RAM/NVS ของบอร์ด — WiFi/Firebase ดับไปก็ไม่กระทบการควบคุมสภาพแวดล้อมในโรงเรือน

อินเทอร์เน็ต/Firebase ใช้สำหรับ ส่งข้อมูลให้ดูผ่านเว็บ (ทุก 30 วิ) และ รับคำสั่ง/ค่าที่ตั้งใหม่จากพนักงาน (polling ทุก 1.5 วิ) เท่านั้น

การสื่อสารระหว่าง ESP32 กับ Firebase ใช้วิธี polling ด้วย getJSON() แทนการเปิด Stream ค้างไว้ เพราะเสถียรกว่าในสภาพแวดล้อมที่ WiFi สัญญาณไม่แรง (สัญญาณจากโครงเหล็กของโรงเรือนช่วยลดทอนสัญญาณ WiFi ได้พอสมควร)

# 6. ฮาร์ดแวร์ที่ติดตั้งจริง

## อุปกรณ์หลัก

อุปกรณ์ | สถานะ | หมายเหตุ
ESP32 DevKit V1 (30-pin) + Expansion Board HW-777 | ✅ ใช้งาน | WiFi 2.4GHz เท่านั้น
เซนเซอร์อุณหภูมิ/ความชื้นอากาศ (I2C) | ✅ ใช้งาน | อ่านค่าทุก 30 วิ ใช้ขับการควบคุมอัตโนมัติทั้งหมด
DS18B20 (วัดอุณหภูมิน้ำ, waterproof) | ✅ ใช้งาน | ใช้เพื่อแจ้งเตือนเท่านั้น ไม่ควบคุมรีเลย์โดยตรง
LCD I2C 16×2 | ✅ ใช้งาน | แสดงผล 3 หน้าจอสลับทุก 5 วิ ต้องใช้ไฟ 5V
Buzzer Module (Active) | ✅ ใช้งาน | Active-LOW แจ้งเตือนหน้างาน
Relay 4 ช่อง (5V) | ✅ ใช้งาน | Active-LOW ใช้งานจริง 2 ช่อง (พัดลม/ปั๊ม) + สำรอง 1 ช่อง
พัดลมดูดอากาศ 220V AC | ✅ ต่อจริงแล้ว | ควบคุมอัตโนมัติตามอุณหภูมิ/ความชื้น
ปั๊มน้ำไดอะแฟรม 24V DC | ✅ ต่อจริงแล้ว | ควบคุมอัตโนมัติตามความชื้น มีระบบตัดความปลอดภัย
ชุดจ่ายไฟ (PSU 12V + Step-down 5V + Boost 24V) | ✅ ใช้งาน | แยกวงจร AC/DC ชัดเจน

## ระบบจ่ายไฟ

220V AC → S-120-12 PSU (12V/10A) แยกจ่ายไฟ 2 ทาง: (1) ผ่าน XL4015 Step-down เป็น 5V เลี้ยง ESP32 + Relay + LCD + Buzzer และ (2) ผ่าน Boost Converter เป็น 24V เลี้ยงปั๊มน้ำโดยเฉพาะ — แยกวงจรไฟกำลัง (ปั๊ม/พัดลม) ออกจากวงจรสัญญาณ (เซนเซอร์) อย่างชัดเจนตามหลักความปลอดภัย

## กฎความปลอดภัยฮาร์ดแวร์ที่ยึดถือตลอดโครงการ

- ห้ามใช้ GPIO12 กับ Relay (strapping pin ทำให้ ESP32 boot fail)
- LCD I2C ต้องใช้ไฟ 5V ไม่ใช่ 3.3V
- Relay เป็น Active-LOW เสมอ (LOW = เปิด, HIGH = ปิด) ใช้ขา NO เท่านั้น
- ปิดไฟก่อนต่อ/ถอดสาย Boost Converter และปั๊มน้ำทุกครั้ง (เคย short จนอุปกรณ์พังมาแล้ว)

# 7. ซอฟต์แวร์ที่พัฒนา

## 7.1 Firmware (ESP32)

แกนการตัดสินใจ (auto control logic) แยกออกมาเป็นฟังก์ชันล้วน (pure function) ต่างหากจากส่วนที่คุย I/O กับฮาร์ดแวร์ เพื่อให้เขียนชุดทดสอบอัตโนมัติได้โดยไม่ต้องใช้บอร์ดจริง ใช้หลักการ hysteresis latch 4 ตัว (ร้อน / แห้ง / ปั๊มช่วยร้อน / ระบายความชื้น) แทนการเทียบค่าตรงๆ เพื่อป้องกันรีเลย์กระพริบถี่บริเวณค่าขอบเกณฑ์

- Auto control: เปิด/ปิดพัดลม-ปั๊มตามอุณหภูมิและความชื้น พร้อม hysteresis กันกระพริบ
- Pump/Fan safety timer: จำกัดเวลาทำงานต่อเนื่องสูงสุด + บังคับพักหลังตัด ป้องกันปั๊มไหม้/น้ำท่วม
- Self-heal เซนเซอร์: หากอ่านค่าผิดพลาดต่อเนื่อง จะลองเริ่มต้นเซนเซอร์ใหม่โดยไม่ restart บอร์ด
- Failsafe: หากเซนเซอร์อากาศอ่านค่าไม่ได้ ระบบปิดการทำงานอัตโนมัติทั้งหมดเพื่อความปลอดภัย แทนที่จะเดาค่าเก่า
- บันทึกข้อมูลขึ้น Firebase ทุก 30 วิ + สรุปค่าเฉลี่ย/สูงสุด/ต่ำสุดรายชั่วโมง
- รองรับหลายเครือข่าย WiFi พร้อมระบบ reconnect และวินิจฉัยสาเหตุการหลุด/รีสตาร์ท

## 7.2 Firebase (ฐานข้อมูล + สิทธิ์การเข้าถึง)

ใช้ Firebase Realtime Database (ภูมิภาค asia-southeast1) แบ่งสิทธิ์อ่าน/เขียนชัดเจนระหว่าง ESP32 (auth แบบ anonymous — เขียนได้เฉพาะค่าที่วัดได้) และผู้ใช้ dashboard (auth แบบ email — เขียนค่าตั้งค่า/สั่งงานได้) พร้อมกฎ validation ที่ปฏิเสธ field ที่ไม่รู้จักอัตโนมัติ ป้องกันข้อมูลผิดรูปแบบหลุดเข้าระบบ

## 7.3 Web Dashboard

หน้าเว็บเดี่ยว (single-file) ใช้งานได้ทั้งคอมพิวเตอร์และมือถือ (PWA) แบ่งเป็น 4 แท็บ:

แท็บ | ฟีเจอร์หลัก
📊 Sensors | ค่าปัจจุบัน, สถานะระบบ, WiFi/Buzzer/เวลาอัปเดตล่าสุด, สาเหตุรีสตาร์ทล่าสุด
🔌 Control | โหมด Auto/Manual รวม+รายช่อง, ตั้งเวลาเปิด-ปิดล่วงหน้า (Schedule)
📈 Chart | กราฟย้อนหลัง 24 ชม./7 วัน/30 วัน + Export CSV
⚙️ Settings | Quick Preset ตามฤดูกาล, ตั้งเกณฑ์อุณหภูมิ/ความชื้นละเอียด, ประวัติการสั่งงาน (Action Log)

- ระบบแจ้งเตือน (กระดิ่ง) พร้อม Push Notification และประวัติย้อนหลัง
- Action Log บันทึกทุกคำสั่งพร้อมชื่อผู้ใช้และเวลา — ตรวจสอบย้อนหลังได้
- รองรับหลายบัญชีผู้ใช้พร้อมกันแบบเรียลไทม์ (ทุกคนเห็นการเปลี่ยนแปลงพร้อมกัน)

## 7.4 คุณภาพซอฟต์แวร์และการทดสอบอัตโนมัติ

นอกเหนือจากการทดสอบบนฮาร์ดแวร์จริง โปรเจกต์นี้มีชุดทดสอบอัตโนมัติ (automated test) 3 ชุด ที่รันได้โดยไม่ต้องมีบอร์ดจริงหรือ Firebase Console เปิดอยู่:

ชุดทดสอบ | ตรวจสอบอะไร
test:logic | ทดสอบ auto control logic ด้วย g++ — ครอบคลุมเงื่อนไข crossing/hysteresis, กรณีเซนเซอร์เสีย, ตัวจับเวลาความปลอดภัยของปั๊ม/พัดลม
test:rules | ทดสอบกฎความปลอดภัยของฐานข้อมูล Firebase ผ่าน emulator — ทุกเส้นทาง accept/reject
test:sync | ตรวจว่าค่าคงที่สำคัญ (เช่น ค่าป้องกันพัดลม-ปั๊มขัดแย้งกัน) ตรงกันทั้ง 3 ชั้นของระบบ กันไม่ให้ปรับค่าที่หนึ่งแล้วอีกที่ลืมปรับตาม

# 8. ระยะเวลาดำเนินงานและเหตุการณ์สำคัญ

ช่วงเวลา | เหตุการณ์สำคัญ
มิ.ย. 2569 | เริ่มฝึกงาน วางแผนโครงการ ออกแบบระบบเบื้องต้น เริ่มพัฒนา Firmware และ Dashboard เวอร์ชันแรก
19 มิ.ย. 2569 | Deploy Dashboard ขึ้น Firebase Hosting ครั้งแรก
23 มิ.ย. 2569 | ปรับปรุง UX บนมือถือ, เพิ่ม Dynamic Alert Threshold, ปรับปรุงหน้า Settings
1 ก.ค. 2569 | ต่อปั๊มน้ำ (CH4) และพัดลม 220V (CH3) เข้าระบบจริง ทำงานได้ตามที่ออกแบบ
2–3 ก.ค. 2569 | เพิ่ม Auto Control v2 (hysteresis คู่กับน้ำ) พบปัญหาระบบไม่เสถียร ทำ A/B test เปรียบเทียบเวอร์ชันที่มี/ไม่มี recovery layer — สรุปว่าต้นเหตุเป็น hardware noise ไม่ใช่โค้ด
7 ก.ค. 2569 | ตัดสินใจค่าความปลอดภัยปั๊มสุดท้าย (10 นาทีทำงานต่อเนื่อง/พัก 5 นาที) เพิ่มเอกสาร TEAM_ONBOARDING และ DAILY_OPERATIONS_CHECKLIST สำหรับทีมงานทั่วไป
8 ก.ค. 2569 | แก้ปัญหาจอ LCD ไม่ติด (จอเสีย เปลี่ยนจอใหม่) และพิสูจน์ด้วยการทดลองเทียบสดว่าระยะห่างจากกลุ่ม Relay คือปัจจัยหลักที่ทำให้เซนเซอร์อ่านค่าผิดพลาด
11 ก.ค. 2569 | เปลี่ยนเซนเซอร์วัดอุณหภูมิ/ความชื้นอากาศเป็นแบบ I2C ที่มีการตรวจสอบข้อมูลในตัว เพื่อทนทานต่อสัญญาณรบกวนจากมอเตอร์ปั๊มมากขึ้น
24 ก.ค. 2569 | ปิดช่องโหว่ที่พัดลมไล่ความชื้นทำงานขัดกับปั๊มพ่นหมอกในบางช่วงความชื้น ปรับพัดลมให้พักคู่กับปั๊มเพื่อความปลอดภัยของอุปกรณ์
30–31 ก.ค. 2569 | แก้ปัญหา WiFi หลุดไม่กลับคืน และปัญหาบอร์ดรีสตาร์ทซ้ำที่แฝงมากับการรอซิงค์เวลา — เวอร์ชันล่าสุด v2.9.2 เสถียร
1–2 ส.ค. 2569 | จัดทำเอกสารส่งมอบ: คู่มือการใช้งานสำหรับพนักงานทั่วไป และรายงานฉบับสมบูรณ์นี้

# 9. ผลการทดสอบระบบ

สรุปผลการทดสอบใช้งานจริงหน้างานที่บริษัท (ครอบคลุมทั้งฟังก์ชันหลักของ Dashboard และการเชื่อมต่อกับฮาร์ดแวร์):

รายการทดสอบ | ผล | หมายเหตุ
ESP32 เชื่อมต่อ WiFi | ✅ ผ่าน | เชื่อมต่ออัตโนมัติได้หลายเครือข่าย (WiFiMulti)
ข้อมูลเซนเซอร์อัปเดตเรียลไทม์ | ✅ ผ่าน | อุณหภูมิ/ความชื้นอากาศ, อุณหภูมิน้ำ ทุก 30 วิ
สั่งเปิด/ปิดรีเลย์โหมด Manual | ✅ ผ่าน | ทดสอบครบทุกช่อง ได้ยินเสียง relay สลับสถานะ
บันทึกประวัติการสั่งงาน | ✅ ผ่าน | บันทึกชื่อผู้ใช้และเวลาทุกครั้ง
กราฟย้อนหลัง 24 ชม. | ✅ ผ่าน | แสดงข้อมูลครบทุกชั่วโมง
ระบบแจ้งเตือนและ threshold ปรับได้ | ✅ ผ่าน | ปรับค่าแล้วแจ้งเตือนขึ้นทันที
Preset ตามฤดูกาล | ✅ ผ่าน | ฤดูร้อน/ปกติ/ฝน/กำหนดเอง
Export CSV | ✅ ผ่าน | เปิดใน Excel encoding ถูกต้อง
ใช้งานบนมือถือ | ✅ ผ่าน | ทดสอบบนหน้าจอขนาดเล็ก แสดงผลถูกต้อง
พัดลม/ปั๊มทำงานจริงตามเงื่อนไขอัตโนมัติ | ✅ ผ่าน | ยืนยันหน้างานว่าเปิด-ปิดตรงตามเกณฑ์ที่ตั้ง

# 10. ปัญหาที่พบระหว่างดำเนินงานและแนวทางแก้ไข

โครงการนี้ผ่านการแก้ปัญหาเชิงวิศวกรรมจำนวนมาก ทั้งด้านฮาร์ดแวร์ ไฟฟ้า และซอฟต์แวร์ ตารางด้านล่างสรุปปัญหาหลักที่มีนัยสำคัญต่อการเรียนรู้ของโครงการ:

ปัญหา | สาเหตุที่แท้จริง | วิธีแก้ไข
DS18B20 อ่านค่า -127°C | ต่อสายผิดด้าน | ยึดตามมาตรฐาน flat side หันหาตัวเอง: ซ้าย=GND กลาง=DATA ขวา=VCC
บอร์ด boot fail “invalid header” | ใช้ GPIO12 ซึ่งเป็น strapping pin กับ Relay | ย้าย Relay ปั๊มน้ำจาก GPIO12 → GPIO25
จอ LCD ไม่ติดเลย แม้สแกน I2C ไม่เจออุปกรณ์ | จอ LCD ตัวเดิมเสีย (hardware defect) ไม่ใช่ปัญหาสาย/โค้ดตามที่สงสัยแต่แรก | เปลี่ยนจอใหม่ ต่อสายเดิมทุกเส้น ทำงานได้ทันที
เซนเซอร์อากาศอ่านค่าไม่ได้เป็นระยะ ตอนปั๊ม/พัดลมสวิตช์ทำงาน | สัญญาณรบกวน (noise) จากมอเตอร์ปั๊มรบกวนสาย/ชิปเซนเซอร์ที่อยู่ใกล้กลุ่ม Relay — ยืนยันด้วยการทดลองเทียบสด DS18B20 (ไกล relay) กับเซนเซอร์อากาศ (ใกล้ relay) | เปลี่ยนเซนเซอร์เป็นแบบ I2C ที่มีการตรวจสอบข้อมูล (CRC) ในตัว และวางแผนย้ายตำแหน่งให้ไกลกลุ่ม Relay เหมือน DS18B20
ระบบไม่เสถียร ค้าง/รีสตาร์ทบ่อยหลังเพิ่มระบบ auto-recovery | สมมติฐานเบื้องต้นคือบั๊กซอฟต์แวร์ แต่ A/B test เปรียบเทียบเวอร์ชันซับซ้อน (มี recovery) กับเวอร์ชันเรียบง่าย (ไม่มี) ได้ผลลัพธ์เหมือนกันทุกประการ | สรุปว่าเป็นปัญหาไฟฟ้า/hardware ไม่ใช่โค้ด — ถอดระบบ recovery layer ที่ไม่จำเป็นออก ลดความซับซ้อน และวางแผนแก้ที่ต้นตอ (คาปาซิเตอร์ + RC snubber ที่ปั๊ม)
WiFi หลุดบ่อยและไม่กลับมาเชื่อมต่อเอง | พบบั๊กที่ทับซ้อนกัน 4 จุดในเส้นทาง reconnect (modem sleep, ตัวจัดการ WiFi 2 ตัวแย่งกันทำงาน, timeout สั้นเกินไป, การไล่ AP ข้ามรอบเปล่า) | แก้ทีละจุดจนครบ พร้อมเพิ่ม diagnostic (จำนวนครั้ง/สาเหตุที่หลุด) ให้เห็นบน Dashboard
บอร์ดรีสตาร์ทซ้ำเป็นระยะ เข้าใจผิดว่าเป็นปัญหา WiFi | โค้ดรอซิงค์เวลา (NTP) ใช้ค่า timeout แบบบล็อกนานเกินไป ทำให้ watchdog ของระบบสั่งรีเซ็ตบอร์ด | เปลี่ยนไปใช้ฟังก์ชันอ่านเวลาที่ไม่บล็อก จำกัดเวลารอสูงสุดชัดเจน
Dashboard แสดงข้อมูลค้างแม้บอร์ดทำงานปกติ | การส่งข้อมูลขึ้น Firebase ยิงคำสั่งเขียนทีละฟิลด์ (สูงสุด 24 ครั้งต่อรอบ) ทำให้รอบการส่งใช้เวลานานกว่าที่กำหนด | รวมการเขียนข้อมูลเป็นคำสั่งเดียวต่อรอบ ลดจำนวนการเชื่อมต่อเครือข่ายที่ไม่จำเป็น
พัดลม 5V ระบายความร้อนกล่องไม่หมุน | ตำแหน่ง jumper บน Expansion Board ไม่ถูกต้อง | ปรับ jumper ให้ถูกตำแหน่ง

บทเรียนสำคัญจากโครงการ

ปัญหา “นิ่มๆ” ที่ดูเหมือนบั๊กซอฟต์แวร์ (ค้าง, รีสตาร์ท, เซนเซอร์อ่านผิด) จำนวนมากมีต้นตอเป็นปัญหาไฟฟ้า/hardware — การพิสูจน์ด้วย A/B test เปรียบเทียบเวอร์ชันโค้ดต่างกันเป็นวิธีที่ตัดตัวแปรซอฟต์แวร์ออกได้ชัดเจนกว่าการเดา

ระยะห่างระหว่างสายสัญญาณ (เซนเซอร์) กับสายไฟกำลัง (ปั๊ม/มอเตอร์) มีผลต่อความเสถียรมากกว่าคุณภาพจุดต่อหรือโปรโตคอลสื่อสารที่ใช้

การเพิ่มความซับซ้อน (เช่น auto-recovery layer) เพื่อแก้ปัญหาความไม่เสถียร ไม่ได้ช่วยเสมอไปหากไม่ได้แก้ที่ต้นตอจริง — บางครั้งการลดความซับซ้อนกลับช่วยวินิจฉัยปัญหาได้ง่ายกว่า

# 11. งบประมาณ

งบประมาณเบื้องต้นตามแผนเดิม (ระบบ standalone แบบไม่ใช้ WiFi) ประเมินไว้ที่ประมาณ 4,450 บาท ครอบคลุมระบบน้ำ/พ่นหมอก ระบบควบคุมอุณหภูมิ ระบบระบายอากาศ และระบบไฟฟ้า/ความปลอดภัย อย่างไรก็ตาม เมื่อเปลี่ยนมาใช้แนวทาง ESP32 + Firebase รายการอุปกรณ์จริงที่จัดซื้อจึงแตกต่างจากแผนเดิม โดยมีใบเสนอราคาที่บันทึกไว้ในเอกสารโครงการดังนี้:

รายการ | จำนวน | ราคาต่อหน่วย (บาท) | รวม (บาท)
บอร์ด Relay 4 ช่อง 5V (isolation, 250V/10A) | 1 | 85.00 | 85.00
Boost Converter DC-DC 400W (8.5-50V → 10-60V) | 1 | 290.00 | 290.00
XL4015 Step-down 5A พร้อมโวลต์มิเตอร์ | 1 | 135.00 | 135.00
DS18B20 Waterproof Temperature Sensor | 1 | 85.00 | 85.00
ปั๊มน้ำมินิ 24V DC | 1 | 1,500.00 | 1,500.00
Fan Module 5V (ระบายความร้อนกล่อง) | 2 | 65.00 | 130.00
ESP32 DevKit V1 | 1 | 200.00 | 200.00
SHT35 | 1 | 350.00 | 350.00
LCD I2C 16×2 | 1 | 120.50 | 120.50
Expansion Board HW-777 | 1 | 50.00 | 50.00
Buzzer Module | 1 | 10.00 | 10.00
PSU S-120-12 (12V 10A) | 1 | 440.00 | 440.00
หัวพ่นหมอก + สายยาง | 1 | 1,000.00 | 1,000.00
กล่องกันน้ำ IP65 | 3 | 350.00 | 1,050.00
พัดลมระบายอากาศ 220V AC (CH3) | 2 | 2,250.00 | 4,500.00
Boost Converter DC-DC 150W (10-32V→12-35V, 6A) | 1 | 75.00 | 75.00
XL4005 Step Up/Down DC-DC (5-36V→1.2-32V, 5A) | 1 | 180.00 | 180.00
สาย Jumper | 1 | 300.00 | 300.00

รวมค่าใช้จ่ายอุปกรณ์ทั้งหมด (อ้างอิงใบเสนอราคาเลขที่ QT0165876 ลงวันที่ 15 มิถุนายน 2569 สำหรับบางรายการ ร่วมกับรายการที่จัดซื้อเพิ่มระหว่างดำเนินงาน): 10,500.50 บาท

หมายเหตุเรื่องงบประมาณ

ตัวเลขนี้ครอบคลุมอุปกรณ์หลักที่ใช้งานจริงทั้งหมด รวมรายการที่ไม่มีใบเสนอราคาเป็นทางการ (ประเมินจากราคาตลาดทั่วไป ณ ช่วงเวลาที่จัดซื้อ) ยังไม่รวมค่าแรงเดินสายไฟซึ่งไม่มีการบันทึกราคาแยกไว้

แผนงบประมาณเบื้องต้น (แนวทาง standalone) ที่เคยประเมินไว้ประมาณ 4,450 บาท ไม่ได้ถูกใช้ตามแผนทั้งหมด เนื่องจากเปลี่ยนแนวทางมาใช้ ESP32 + Firebase ระหว่างดำเนินงาน

# 12. สิ่งที่ส่งมอบ (Deliverables)

สิ่งที่ส่งมอบ | รายละเอียด
Firmware (v2.9.2) | smartfarm_firmware.ino + auto_control_logic.h + config.h.example — พร้อม changelog เต็มรูปแบบในไฟล์
Web Dashboard | dashboard/index.html — deploy ผ่าน Firebase Hosting เข้าถึงได้จาก URL สาธารณะ
ฐานข้อมูลและกฎความปลอดภัย | database.rules.json พร้อมชุดทดสอบ (tests/database.rules.test.js)
ชุดทดสอบอัตโนมัติ | tests/auto_control_logic.test.cpp และสคริปต์ตรวจ cross-layer sync
คู่มือการใช้งานระบบ (สำหรับพนักงานทั่วไป) | เอกสาร Word แยกต่างหาก ครอบคลุมการใช้ Dashboard ทุกฟังก์ชัน
เอกสารเทคนิคประกอบ | PROJECT_MEMORY.md, pinout_v2.md, Firebase_Database_Structure.md, DAILY_OPERATIONS_CHECKLIST.md, TEAM_ONBOARDING.md
รายงานฉบับสมบูรณ์นี้ | สรุปภาพรวมโครงการทั้งหมดสำหรับส่งมอบบริษัท

# 13. ข้อจำกัดและงานที่ยังไม่แล้วเสร็จ

- การแก้ปัญหาสัญญาณรบกวนจากมอเตอร์ปั๊มที่ต้นตอ (ติดตั้งคาปาซิเตอร์คร่อมขั้วมอเตอร์ + RC snubber ที่ Relay ปั๊ม) ยังไม่ได้ดำเนินการ — ปัจจุบันแก้ไขด้วยการเปลี่ยนเซนเซอร์เป็นแบบทนสัญญาณรบกวนได้ดีขึ้นเป็นมาตรการชั่วคราว
- ระบบยังไม่มีเซนเซอร์วัดระดับน้ำในถังพักอัตโนมัติ ต้องตรวจด้วยตาเป็นประจำ
- ยังไม่รองรับการควบคุมหลายโซน (multiple zones) ในกรณีขยายโรงเรือนเพิ่ม
- ยังไม่มีระบบสรุปรายงานอัตโนมัติแบบรายสัปดาห์/รายเดือน (PDF)
- ระบบบัญชีผู้ใช้ยังไม่มีการแบ่งระดับสิทธิ์ (role) — ทุกบัญชีมีสิทธิ์เท่ากันหมด ซึ่งเหมาะกับทีมงานขนาดเล็กปัจจุบัน แต่ควรทบทวนหากทีมขยายใหญ่ขึ้น
- ระบบตั้งใจไม่มี auto-restart/failsafe อัตโนมัติเมื่อเซ็นเซอร์ค้างนานผิดปกติ (พิสูจน์แล้วว่าการเพิ่มระบบดังกล่าวไม่ช่วยแก้ปัญหาที่ต้นตอเป็น hardware) — ผู้ใช้ต้อง power cycle ตู้คอนโทรลเองหากพบระบบค้างนานผิดปกติ

# 14. ข้อเสนอแนะสำหรับการพัฒนาต่อ

1. ดำเนินการแก้ไข noise ของมอเตอร์ปั๊มที่ต้นตอ (คาปาซิเตอร์ + RC snubber + แยกสายไฟกำลัง/สัญญาณให้ห่างที่สุด) เพื่อลดความเสี่ยงเซนเซอร์อ่านค่าผิดพลาดในระยะยาว
2. พิจารณาเพิ่มเซนเซอร์วัดระดับน้ำอัตโนมัติในถังพัก เพื่อลดภาระการตรวจด้วยตา และป้องกันปั๊มทำงานตอนไม่มีน้ำ
3. หากขยายโรงเรือนหรือเพิ่มจุดปลูกใหม่ ควรออกแบบให้ระบบรองรับหลายโซนควบคุมอิสระจากกัน
4. เพิ่มระบบสรุปรายงานอัตโนมัติ (รายสัปดาห์/รายเดือน) ส่งเป็น PDF หรือสรุปทาง Dashboard เพื่อลดภาระการดึงข้อมูลด้วยมือ
5. ทบทวนระบบสิทธิ์ผู้ใช้หากจำนวนพนักงานที่เข้าถึง Dashboard เพิ่มขึ้นในอนาคต
6. สำรองข้อมูล git repository และตรวจสอบปริมาณการใช้งาน Firebase free tier เป็นระยะ เพื่อป้องกันระบบหยุดทำงานเมื่อเกินโควตา

# 15. บทสรุป

โครงการ Greenhouse IoT Smart Farm เริ่มต้นจากโจทย์การควบคุมสภาพแวดล้อมโรงเรือนแบบง่ายเพื่อสนับสนุนงานวิจัยด้านปุ๋ย และพัฒนาต่อยอดกลายเป็นระบบ IoT ที่สมบูรณ์ ครอบคลุมทั้งฮาร์ดแวร์ควบคุม, ระบบคลาวด์, และเว็บแอปพลิเคชันที่ใช้งานได้จริงโดยทีมงานที่ไม่มีพื้นฐานด้าน IT ตลอดระยะเวลาฝึกงาน ผู้จัดทำได้ฝึกฝนทักษะครบวงจรตั้งแต่การออกแบบวงจรไฟฟ้า การเขียนโปรแกรมฝังตัว (embedded programming) การออกแบบฐานข้อมูลและกฎความปลอดภัย การพัฒนาเว็บแอปพลิเคชัน ไปจนถึงการวินิจฉัยปัญหาเชิงวิศวกรรมด้วยกระบวนการทดสอบอย่างเป็นระบบ (A/B testing)

ระบบที่ส่งมอบสามารถทำงานได้จริงในสภาพแวดล้อมโรงเรือนจริง ผ่านการทดสอบใช้งานหน้างานครบทุกฟังก์ชันหลัก และมีเอกสารประกอบพร้อมส่งต่อให้ทีมงานดูแลต่อในระยะยาว แม้จะยังมีงานบางส่วนที่ค้างอยู่ (โดยเฉพาะการแก้ปัญหาสัญญาณรบกวนที่ต้นตอทางฮาร์ดแวร์) แต่ระบบในสถานะปัจจุบันสามารถใช้งานได้อย่างปลอดภัยและมีมาตรการรองรับความผิดพลาดที่เหมาะสมกับขนาดของโรงเรือนและทีมงาน

# 16. ภาคผนวก

## ก. ผังพิน GPIO (ESP32 DevKit V1)

GPIO | อุปกรณ์ | หน้าที่
GPIO2 | Status LED (บนบอร์ด) | ไฟแสดงสถานะ
GPIO4 | DS18B20 | วัดอุณหภูมิน้ำ (ต้องมี pull-up 4.7kΩ)
GPIO14 | Relay CH3 | พัดลม 220V AC — auto ตามอุณหภูมิ/ความชื้น
GPIO21 / GPIO22 | I2C (SDA/SCL) ร่วม LCD + เซนเซอร์อากาศ | จอแสดงผล + วัดอุณหภูมิ/ความชื้นอากาศ
GPIO25 | Relay CH4 | ปั๊มน้ำ 24V DC — auto ตามความชื้น (ย้ายจาก GPIO12 เดิม)
GPIO26 | Relay CH1 | สำรอง — สั่งเอง/ตั้งเวลาเท่านั้น
GPIO27 | Relay CH2 | ไม่ได้ใช้งาน
GPIO33 | Buzzer | แจ้งเตือนหน้างาน (active-LOW)
GPIO12 | ห้ามใช้ | Strapping pin — ทำให้ boot fail หากต่อ Relay

## ข. โครงสร้างฐานข้อมูล Firebase (สรุปย่อ)

smartfarm/sensors — ค่าที่วัดได้ (ESP32 → Dashboard) · smartfarm/control — โหมด/threshold/ตารางเวลา (Dashboard → ESP32) · smartfarm/status — สถานะระบบและ boot diagnostics · smartfarm/alerts, alert_history — การแจ้งเตือน · smartfarm/action_log — ประวัติการสั่งงาน · logs/YYYY-MM-DD/HH — ข้อมูลสรุปรายชั่วโมง (อยู่นอก smartfarm/)

## ค. เอกสารอ้างอิงในโปรเจกต์

- PROJECT_MEMORY.md — บันทึกเทคนิคละเอียด (source of truth สถานะปัจจุบัน)
- pinout_v2.md — ผังการต่อสายทั้งหมด
- Firebase_Database_Structure.md — สัญญาข้อมูลเต็มรูปแบบ
- DAILY_OPERATIONS_CHECKLIST.md / TEAM_ONBOARDING.md — คู่มือสำหรับทีมงานที่ไม่มีพื้นฐาน IT
- README.md — ภาพรวมทางเทคนิคและ changelog แบบเต็ม

## ง. การเข้าถึงระบบ

รายการ | ที่อยู่
Web Dashboard | https://greenhouse-iot-smart-farm.web.app
Source code (private repository) | จัดเก็บบน GitHub — ติดต่อ Tonkla สำหรับสิทธิ์เข้าถึง

รายงานฉบับนี้จัดทำโดย Tonkla (นักศึกษาฝึกงานแผนก IT) · บริษัท ปุ๋ยไวกิ้ง จำกัด · สิงหาคม 2569
