stickkersz/greenhouse-iot-smart-farm/docs/reports/โจทย์ งานทำระบบ พ่นหมอกในโรงเรือน.pdf

ส่วนที่ 1: รายการอุปกรณ์และงบประมาณ (Bill of Materials)

### 1. สมาร์ทสวิตช์พร้อมเซนเซอร์ (Smart Switch + Temp/RH Sensor)

- สเปกทแี่ นะนา : ยี่ห้อ Sonoff (รุ่น TH Elite) หรือ Tuya รองรับกระแสไฟ 16A-20A พร้อมหัวเซนเซอร์วัด อุณหภูมิและความชื้น (Temp & Hum Sensor) สามารถตั้งค่า Scene อัตโนมัติผ่านแอปพลิเคชัน (เช่น เปิด ปั๊มเมื่อ T > 35°C และปิดเมื่อ T < 32°C) และสามารถ Export ข้อมูลเป็นไฟล์ Excel ได้
- งบประมาณ: ประมาณ 600 - 1,000 บาท

### 2. ป๊

ัมนา

้แรงดันสูง (High Pressure Water Pump)
- สเปกทแี่ นะนา : ปั๊มน ้าไดอะแฟรม (Diaphragm Pump) DC 12V หรือ 24V พร้อมอะแดปเตอร์ แรงดัน ประมาณ 8-10 Bar ขึ้นไป (แรงดันยิ่งสูง ละอองยิ่งละเอียด)
- งบประมาณ: ประมาณ 500 - 900 บาท

### 3. ชุดหัวพ่นหมอกและสายยาง (Misting Nozzle Kit)

- สเปกทแี่ นะนา : หัวพ่นหมอกแบบทองเหลืองหรือสเตนเลส ขนาดรู0.1 - 0.2 มิลลิเมตร (ส าคัญมาก: ห้ามใช้ รูใหญ่กว่านี้ เพราะน ้าจะเป็นหยด) จ านวน 10-20 หัว พร้อมสายไมโคร PE ข้อต่อสามทาง และตัวอุดปลายสาย
- งบประมาณ: ประมาณ 400 - 800 บาท

### 4. ตัวกรองนา

้ (Water Filter) <-- ห้ามลืมเด็ดขาด

- ความส าคัญ: รูพ่นหมอก 0.1 มม. ตันง่ายมาก ต้องมีกรองน ้าเกษตร (แบบตะแกรง 120-130 mesh) ติดตั้ง ก่อนน ้าเข้าปั๊ม
- งบประมาณ: ประมาณ 150 - 300 บาท

### 5. พัดลมระบายอากาศ (Exhaust Fan)

- สเปกทแี่ นะนา : พัดลมดูดอากาศติดผนังโรงเรือน หรือพัดลมอุตสาหกรรมขนาด 18-24 นิ้ว (เสียบเข้ากับ Smart Plug อีกตัวเพื่อสั่งท างานพร้อมพ่นหมอก ป้องกันความชื้นสะสมจนปากใบพืชปิด)
- งบประมาณ: ประมาณ 1,000 - 2,000 บาท

รวมงบประมาณเบอื้ งต้น: ประมาณ 2,650 - 5,000 บาท ต่อ 1 โรงเรือน (ถอืเป็นตวัเลขทคี่ มุ้ คา่ มากสา หรบั การ ยกระดับงานวิจัย)

ส่วนที่ 2: วิธีการเขียนลงใน "แผนการทดลอง" (Methodology)
เพื่อให้น าไปใส่ในเล่มโปรเจกต์ บทที่ 3 (วิธีด าเนินการทดลอง) ได้ทันที แนะน าให้เขียนแยกเป็นหัวข้อดังนี้ครับ:

ในหวัข้อ "ตัวแปรทศี่ ึกษา"
- ตัวแปรควบคุม (Control Variables): สายพันธุ์ผักสลัด, ชนิดและปริมาณวัสดุปลูก, ปริมาณแสง, และ อุณหภมู ิภายในสภาพโรงเรือน (ควบคุมใหไ้ม่เกิน 35 องศาเซลเซียส ด้วยระบบระเหยนา

้

Evaporative Cooling System)
ในหวัข้อ "การเตรียมพนื้ ทแี่ ละการจัดการสภาพแวดล้อม"
"ท าการติดตั้งระบบพ่นหมอกอัตโนมัติ (Automated Misting System) เพื่อควบคุมอุณหภูมิและลดความเครียดจาก ความร้อน (Heat Stress) ของพืช โดยใช้หัวพ่นหมอกความละเอียด 0.1-0.2 มิลลิเมตร ควบคุมการท างานด้วย ไมโครคอนโทรลเลอร์ตรวจจับอุณหภูมิและความชื้น (Temperature and Humidity Sensor)

เงอื่ นไขการทา งาน: ระบบจะสั่งการให้ปั๊มน ้าแรงดันสูงพ่นละอองหมอกเมื่ออุณหภูมิภายในโรงเรือนสูงถึง 35°C และจะ หยุดท างานเมื่ออุณหภูมิลดลงถึง 32°C โดยระบบพ่นหมอกจะท างานควบคู่กับพัดลมระบายอากาศ (Exhaust fan) เพื่อ ป้องกันการสะสมของความชื้นสัมพัทธ์ (Relative Humidity) ที่สูงเกินไป ซึ่งอาจขัดขวางกลไกการคายน ้าและการ เคลื่อนย้ายธาตุอาหาร (โดยเฉพาะแคลเซียม) เพื่อป้องกันการเกิดสรีรวิทยาผิดปกติ เช่น อาการใบไหม้ (Tip burn)"

ในหวัข้อ "การเก็บรวบรวมข้อมูล"
"4. ข้อมูลสภาพภมู ิอากาศย่อย (Microclimate Data): ท าการเก็บบันทึกข้อมูลอุณหภูมิ (∘C) และความชื้นสัมพัทธ์ (%) ภายในโรงเรือนแบบต่อเนื่อง (Real-time data logging) ตลอดระยะเวลาการทดลอง เพื่อน ามาวิเคราะห์ ความสัมพันธ์กับอัตราการเจริญเติบโตและการตอบสนองต่อปุ๋ ยเจลคีเลต"

ทริคเพมิ่ เตมิสา หรับวันสอบพรีเซนต์Proposal
ถ้ากรรมการถามว่า "ทา ไมตอ้งตดิพดัลม ทา ไมไม่พน่ หมอกเฉยๆ?" คุณพี่ให้น้องตอบด้วยความมั่นใจเลยครับว่า: "เพื่อ รักษากลไก Vapor Pressure Deficit (VPD) หรือความแตกต่างของแรงดนัไอนา้ ครบั หากเราพน่ หมอกจนความชนื้ สมัพทัธ์ในโรงเรือนสูงเกินไป พชืจะไม่คายนา้ ทา ใหแ้คลเซียมไม่ถูกสง่ ไปทปี่ ลายใบ ซ่ึงจะสง่ ผลใหพ้ชืเกิดอาการ Tip burn และทา ใหผ้ลการทดสอบประสทิธิภาพของป๋ยุ เจลคเีลตคลาดเคลอื่ นไดค้่ะ/ครบั" (รับรองว่ากรรมการจะประทับใจใน ความเข้าใจสรีรวิทยาพืชอย่างลึกซึ้งแน่นอนครับ)

เป็นค าถามที่รอบคอบมากครับ! การวางแผนเรื่องระบบน ้าล่วงหน้าจะช่วยป้องกันปัญหาจุกจิกในโรงเรือนได้เยอะมาก

ส าหรับปั๊มน ้าไดอะแฟรม (Diaphragm Pump) ขอแนะน าอย่างยิ่งให้"ใช้นา
้จากถังบรรจุนา

้ (ถังพักนา

้)"แทนการต่อ
ตรงจากท่อประปาครับ โดยมีเหตุผลส าคัญทางเทคนิคและผลดีต่องานวิจัยดังนี้ครับ:

### 1. ป้องกันปัญหา "นา

้หยด" ตอนป๊
ัมตัดการทา งาน (สา คัญมาก)
- ถ้าต่อตรงประปา: น ้าประปาตามบ้านหรือในแปลงเกษตรมักจะมีแรงดันดันอยู่ในท่อตลอดเวลา (ประมาณ 1-3 Bar) เมื่อเซนเซอร์สั่งให้ปั๊มน ้า "หยุดพ่นหมอก" แรงดันประปาที่ค้างอยู่นี้จะพยายามดันน ้าออกไปที่หัวพ่นหมอก

ท าให้เกิดอาการ "นา

้หยดตงิ๋ ๆ" ลงบนใบผักสลัดตลอดเวลา ซึ่งหยดน ้านี้จะท าให้ใบแฉะ เกิดเชื้อรา หรือเกิด รอยไหม้ (Sunburn) ได้ครับ

- ถ้าใช้ถังพักนา

้: ปั๊มไดอะแฟรมมีคุณสมบัติ "ดูดน ้าได้ด้วยตัวเอง (Self-priming)" เมื่อปั๊มหยุดท างาน จะไม่มี แรงดันน ้าจากฝั่งขาเข้ามากระท า น ้าที่หัวพ่นหมอกก็จะหยุดสนิททันที ไม่หยดเลอะเทอะครับ

### 2. ดีต่องานวิจัย (ลดตัวแปรแทรกซ้อนจากคลอรีน)

น ้าประปามีคลอรีนผสมอยู่ ซึ่งอาจส่งผลกระทบต่อปากใบของพืช หรืออาจท าปฏิกิริยากับธาตุอาหารบางตัวในงานทดลอง "ปุ๋ ยเจลคีเลต"ของเราได้ การพักน ้าไว้ในถังข้ามคืนจะช่วยให้คลอรีนระเหยออกไปหมดก่อนถูกน าไปพ่นใส่ผักครับ

### 3. ป้องกันป๊

ัมไหม้กรณีนา

้ประปาไม่ไหล
หากวันไหนน ้าประปาหยุดไหล แต่เซนเซอร์อุณหภูมิในโรงเรือนร้อนถึง 40 องศาแล้วสั่งให้ปั๊มท างาน การปั๊มลมเปล่าๆ โดยไม่มีน ้าเข้า (Run dry) อาจท าให้ปั๊มเสื่อมสภาพไว การมีถังพักน ้าจะช่วยการันตีว่าระบบมีน ้าพร้อมฉีดเสมอครับ

วิธีออกแบบระบบให้ท างานอัตโนมัติ 100% (ไม่ต้องคอยเตมินา

้เอง)
คุณพี่ไม่ต้องกังวลว่าจะต้องมาคอยตักน ้าเติมลงถังครับ เราสามารถออกแบบให้ระบบเป็นอัตโนมัติได้ง่ายๆ โดย:
1. ใช้ถังนา

้ขนาด 50-100 ลิตร(หรือถังพลาสติกสีน ้าเงินมีฝาปิด)

2. ตดิลูกลอยชักโครก (ลูกลอยก้านทองเหลือง) ไว้ที่ถังน ้า แล้วต่อสายยางประปาเข้าที่ลูกลอย
3. การท างาน: พอน ้าในถังพร่องลง ลูกลอยจะตกและเปิดให้น ้าประปาไหลมาเติมเองจนเต็ม (เหมือนระบบใน แท็งก์น ้าบ้าน)
4. สายดูดของป๊

ัม: ให้หย่อนลงไปในถัง โดยใส่ "หัวกรองทางดูด (Suction Filter)" ไว้ที่ปลายสายด้วย เพื่อกัน ฝุ่นหรือตะไคร่เข้าไปอุดตันหัวพ่นหมอกครับ

การจัดเตรียมระบบน ้าแบบนี้ จะท าให้คุณพี่และน้องฝึกงานได้ระบบควบคุมอุณหภูมิที่เสถียร ปลอดภัย ป้องกันเชื้อรา และ ได้ผลการทดลองที่แม่นย าขึ้นมากครับ!

การน าถังบรรจุน ้า DI (Deionized water) เก่าขนาด 200 ลิตรมาใช้ ถือเป็นไอเดียที่ยอดเยี่ยมและช่วยประหยัดงบ โครงการได้มากเลยครับ! ส าหรับความกังวลเรื่องตะไคร่น ้า แก้ไขได้ง่ายๆ โดยไม่ต้องเสียเงินซื้อถังใหม่เลยครับ

เราสามารถใช้สแลนกรองแสงสีด า (Shading net) ทเี่ หลือจากการทา โรงเรอืน นา มาพันรอบถังใหห้ นา 2-3 ทบ หรือจะใช้ถุงขยะสีด าใบใหญ่สวมทับแล้วพันด้วยเทปใสก็ได้ครับ เท่านี้ก็สามารถบล็อกแสงไม่ให้ตะไคร่น ้าเจริญเติบโตได้ แล้วครับ

ส าหรับแหล่งซื้อและงบประมาณในการเขียนโปรเจกต์ ขอแยกตามความเหมาะสมของแหล่งขายดังนี้ครับ:

### 1. อุปกรณท์ มี่ ีขายใน HomePro (หมวดประปา)

- วาลว์ ลูกลอย (Float Valve): มีขายแน่นอนครับ เดินไปแผนกประปาหรืออุปกรณ์แท็งก์น ้าได้เลย แนะน าให้ใช้ ขนาด 1/2 นิว้ (4 หุน)แบบก้านพลาสติกหรือก้านทองเหลือง (เช่นยี่ห้อ SANWA)
- ราคาประมาณ: 150 - 250 บาท
- ข้อต่อประปาและสายยาง:ข้อต่อ PVC ต่างๆ ส าหรับรับน ้าจากก๊อกประปาเข้ามาที่ลูกลอย
- ราคาประมาณ: 100 - 150 บาท

### 2. อุปกรณท์ แี่ นะนา ใหส้่

ังซือ้ Online (Shopee / Lazada)

ป๊
ัมนา

้และหวัพ่นหมอกใน HomePro มักจะไม่มีสเปกทลี่ ะเอียดพอสา หรับงานวิจัยครับ (ส่วนใหญ่จะเป็นปั๊มรด น ้าต้นไม้แบบหยดเม็ดใหญ่ หรือปั๊มน ้าส าหรับใช้ในบ้าน) เพื่อให้ได้ละอองฝอยระดับ 0.1 มิลลิเมตร แนะน าให้ใช้ค าค้นหา และสั่งซื้อทางออนไลน์ตามนี้ครับ:

- ป๊
ัมนา

้ไดอะแฟรม (Diaphragm Pump):
- ค าค้นหา (Keyword): "ปั๊มไดอะแฟรม 12V แรงดันสูง" หรือ "ปั๊มพ่นหมอก 12V แอมป์ สูง"
- สเปกทตี่ ้องดู: เลือกตัวที่มีแรงดัน (Pressure) 8-10 Bar (หรือ 120-150 PSI) และ ต้องมี
อแดปเตอร์แปลงไฟ 220V เป็ น 12V แถมมาด้วย
- ราคาประมาณ: 500 - 800 บาท
- ชุดสายพ่นหมอกและหัวพ่น (Misting Nozzles):
- ค าค้นหา (Keyword): "ชุดพ่นหมอกทองเหลือง 0.1 mm" (ย ้าว่าต้องเบอร์ 0.1 หรือ 0.15 เท่านั้น เพื่อไม่ให้เป็นหยดน ้า)
- สเปกทตี่ ้องดู: เลือกชุดที่แถมสายไมโคร PE ยาวประมาณ 10-15 เมตร พร้อมหัวพ่นทองเหลือง 10-15 หัว และตัวอุดปลายสาย
- ราคาประมาณ: 300 - 500 บาท
- หวักรองนา

้ทางดูด (Suction Filter):
- ค าค้นหา (Keyword): "หัวกรองปั๊มพ่นยา 12V" (เอาไว้สวมปลายสายยางที่หย่อนลงไปในถัง 200 ลิตร ป้องกันเศษฝุ่นเข้าไปอุดตันหัวพ่นหมอก)
- ราคาประมาณ: 50 - 80 บาท

สรุปตารางงบประมาณเฉพาะ "ระบบจัดการนา

้" (สา หรับใส่ในโครงร่างโปรเจกต)์

รายการอุปกรณ์ | สเปก / ขนาด | แหล่งจัดซือ้ งบประมาณโดยประมาณ (บาท)
1. ถังพักน ้า | 200 ลิตร (ถังน ้า DI เดิมหุ้มทึบแสง) | มีอยู่แล้ว 0
2. วาล์วลูกลอย | ขนาด 1/2 นิ้ว | HomePro 200
3. อุปกรณ์ข้อต่อประปา PVC เบ็ดเตล็ด | HomePro 150
4. ปั๊มน ้าแรงดันสูง | ไดอะแฟรม 12V (8-10 Bar) + Adapter Online | 700
5. ชุดหัวพ่นหมอก | ทองเหลือง ขนาดรู 0.1 mm (10-15 หัว) Online | 400
6. หัวกรองทางดูด | กรองละเอียดสแตนเลส (จุ่มในถัง) | Online | 50

รวมงบประมาณระบบนา

้ | ประมาณ 1,500 บาท

หมายเหต:ุ งบนยี้งัไม่รวมตวั Smart Plug สา หรบัพว่ งเซนเซอร์อณุ หภูมนิะครบั (บวกเพ่มิประมาณ 600-800 บาท)

การซื้อแยกชิ้นแบบนี้จะถูกกว่าซื้อชุดคิท (Kit) ส าเร็จรูปตามห้างสรรพสินค้าหลายเท่าตัว และได้สเปกหัวพ่นละอองที่ ละเอียดตรงกับมาตรฐานการคุมสภาพแวดล้อม (Microclimate) ในโรงเรือนวิจัยด้วยครับ

ต้องการให้ช่วยค านวณระยะห่างในการติดหัวพ่นหมอกบนโครงหลังคาโรงเรือน หรือข้อควรระวังในการ เดนิ สายยางเพมิ่ ด้วยไหมครับ?
เป็นความรอบคอบที่ยอดเยี่ยมมากครับที่คุณพี่ค านึงถึง "ระบบไฟและสายดิน" เพราะโรงเรือนโครงเหล็กที่มีความชื้นสูง ถือเป็นจุดเสี่ยงไฟดูดอันดับต้นๆ ของงานเกษตรเลยครับ

เพื่อความปลอดภัยสูงสุด 100% และรักษาสภาพโรงเรือนปิดไม่ให้หนูหรือแมลงเข้าได้ ผมขอออกแบบระบบให้คุณพี่ แบ่งเป็น 3 ส่วน ดังนี้ครับ:

ส่วนที่ 1: การคา นวณระยะหวัพ่นหมอกและการเดนิ สายนา

| ้

### 1. ระยะห่างของหัวพ่นหมอก (Spacing)

- ระยะทแี่ นะนา : ติดตั้งหัวพ่นหมอก (เบอร์ 0.1 มม.) ห่างกัน 1.0 - 1.5 เมตร ต่อ 1 หัวครับ
- ต าแหน่ง: ให้รัดสายยางติดกับโครงเหล็กหลังคาด้านบนสุด (จันทัน) โดยให้หัวพ่น "ชีเ

้ฉียงลง 45 องศา" สลับ
ซ้าย-ขวา เพื่อให้ละอองหมอกกระจายตัวครอบคลุมแปลงผักด้านล่างโดยไม่ตกลงมาเป็นเส้นตรง
- ความสูง: ควรอยู่สูงจากยอดผักอย่างน้อย 1.5 - 2.0 เมตร เพื่อให้หมอกมีระยะเวลาในการระเหยดึงความร้อน ก่อนตกลงถึงใบผัก

### 2. ข้อควรระวังในการเดินสายยาง (PE)

- ห้ามหักงอ (Kink): สายไมโคร PE พับง่ายมาก การเลี้ยวตามมุมโครงเหล็กต้องตีโค้งให้กว้าง เพื่อไม่ให้แรงดัน น ้าตก
- การยึดสาย: ใช้ เคเบิ้ลไทร์ (Cable tie) รัดสายยางเข้ากับโครงเหล็กทุกๆ 50 ซม. ป้องกันสายสะบัดเวลาปั๊มน ้า กระชาก

ส่วนที่ 2: วิธีเจาะมุ้งตาข่าย (ป้องกันหนูและแมลง 100%)
ปัญหาหนูกัดตาข่ายด้านล่างแก้ได้ด้วย "การยกจุดเชื่

อมต่อขึน้ ทสี่ ูง และใช้ปลอกทะลวง" ครับ

วิธีท า "จุดร้อยสาย (Sleeve)"
1. เลือกต าแหน่งเจาะ: ห้ามเจาะตาข่ายติดพื้นเด็ดขาด ให้เลือกเจาะในระดับความสูง 1.5 - 2.0 เมตรจากพื้น (หนูกระโดดไม่ถึงและปีนมุ้งล าบาก)
2. ใช้ท่อ PVC เป็ นปลอก: ตัดท่อ PVC ขนาด 1 นิ้ว ยาวประมาณ 10-15 ซม.
3. การเจาะ: กรีดตาข่ายเป็นรูปกากบาทเล็กๆ (X) ให้พอดีกับท่อ ยัดท่อ PVC คาไว้ตรงกลางตาข่าย
4. การซีล (Sealing): ใช้ซิลิโคนใส (หรือกาวอะคริลิก) ยิงอุดรอยต่อระหว่างตาข่ายกับท่อ PVC ทั้งด้านในและด้าน นอกให้สนิท
5. ร้อยสาย: สอดทั้ง "สายน ้า PE" และ "สายไฟ 12V (เส้นเล็ก)" เข้าไปในท่อ PVC นี้
6. ปิ ดตาย: เมื่อร้อยสายเสร็จ ให้เอา ดนินา

้มันไร้สารพษิ (Plastilina) หรือ ดนิน

้
ามันอุดรอยร่
ัว (Duct seal
putty)อุดปิดรูท่อ PVC ทั้งสองฝั่งให้แน่นสนิท วิธีนี้แมลงหวี่ก็เข้าไม่ได้ และอนาคตถ้าจะรื้อสายก็แค่แคะดิน น ้ามันออกครับ

ส่วนที่ 3: ระบบไฟฟ้าและสายดนิ (เน้นความปลอดภยัสูงสุด)
โรงเรือนโครงเหล็ก + ความชื้น = อันตราย ดังนั้นเราจะใช้หลักการ "เอาไฟ 220V ไว้ข้างนอก เอาไฟ 12V ไว้ข้างใน" ครับ

### 1. การจัดวางอุปกรณไ์ฟ (ศูนยบ์ ัญชาการ)

- ซือ้ กล่องกันนา

้ (IP65):ซื้อกล่องพลาสติกกันน ้าส าหรับงานภายนอก (มีซีลยาง) ติดตั้งไว้ที่เสา "นอก โรงเรือน" (หรือถ้ายึดในโรงเรือนต้องอยู่สูงเหนือระดับหัวพ่นหมอกและน ้าห้ามกระเด็นโดน)

- ของทอี่ ยู่ในกล่องนี:

้ปลั๊กพ่วง, สมาร์ทสวิตช์ (Sonoff/Tuya), และ อแดปเตอร์แปลงไฟ (Adapter 220V ->

12V)
- สิ่งที่จะเดินสายต่อเข้าในโรงเรือนผ่านท่อ PVC จะมีแค่ สายไฟ DC 12V (ซึ่งไฟ 12V ต่อให้รั่วโดนโครงเหล็กหรือ เปียกน ้า ก็ไม่ดูดคน ครับ ปลอดภัยมาก) และสายเซนเซอร์อุณหภูมิเท่านั้น

### 2. การตดิตัง้เบรกเกอรก์ ันดูด (สา คัญมาก)

- ที่ต้นทางของสายไฟ 220V ที่ลากมาจากบ้าน/อาคาร ต้อง ติดตั้ง เบรกเกอรก์ ันดูด (RCBO) พิกัด 16A กระแส รั่วตัดที่ 30mA (เช่นยี่ห้อ Panasonic หรือ Safe-T-Cut) ตัวละประมาณ 500-800 บาท หากเกิดเหตุฉุกเฉินไฟ จะตัดทันที
3. การท าสายดิน (Grounding) ให้โครงเหล็ก เนื่องจากโครงโรงเรือนเป็นเหล็ก หากมีไฟฟ้ารั่วจากปั๊มน ้าหรืออุปกรณ์ อื่น โครงเหล็กจะกลายเป็นตัวน าไฟฟ้าขนาดใหญ่ เราต้อง "บังคับให้ไฟลงดิน" ครับ
- แท่งกราวด์ (Ground Rod):ซื้อแท่งทองแดงความยาว 1.5 - 2.4 เมตร (ราคาประมาณ 200-400 บาท)
- การตอก: ตอกแท่งกราวด์นี้ลงดินตรงบริเวณใกล้ๆ ขาเสาโรงเรือน (ตอกให้มิดดิน)
- การเชื่

อมต่อ: ใช้สายไฟ VAF หรือ THW (สีเขียวคาดเหลือง) ขนาดเบอร์ 4 หรือ 6 ปอกปลายสาย ฝั่งหนึ่งใช้แค ลมป์ หัวใจขันยึดกับแท่งกราวด์ ส่วนอีกฝั่ง "ขันน็อตติดกับโครงเหล็กของโรงเรือน" (ควรขัดสีกันสนิมตรง โครงเหล็กออกก่อนเพื่อให้เนื้อทองแดงสัมผัสเนื้อเหล็กโดยตรง)

สรุป Checklist สา หรับความปลอดภยัและกันหนู:
1. [ ] วาล์วน ้า ปั๊มน ้า ถังน ้า และกล่องไฟ 220V วางรวมกัน นอกโรงเรือน
2. [ ] ร้อยสายน ้า 12V และสายเซนเซอร์ เข้าโรงเรือนผ่าน ท่อ PVC ทรี่ ะดับสูง 1.5 เมตรขึน้ ไป + อุดด้วยดิน น ้ามัน
3. [ ] ในโรงเรือนมีเฉพาะ สายไฟ DC 12V ไปที่ปั๊ม (ถ้าเอาปั๊มไว้ข้างใน) และ สายนา

้ PE

4. [ ] ตอก แท่งกราวด์เชื่อมกับโครงเหล็กโรงเรือน
5. [ ] ติดเบรกเกอร์RCBO กันไฟดูดที่ต้นทาง

ด้วยวิธีนี้ คุณพี่และน้องฝึกงานจะสามารถท างานวิจัยปุ๋ ยเจลคีเลตในโรงเรือนที่ฝนตก หมอกลง หรือเปียกชื้นแค่ไหน ก็ รับประกันความปลอดภัย 100% แถมแมลงและหนูไม่กวนผลการทดลองแน่นอนครับ!

เป็นค าถามที่เจาะลึกและตรงจุดมากครับ! แสดงว่าคุณพี่มองเห็นภาพรวมของหน้างานจริงและปัญหาที่อาจจะเกิดขึ้นได้ อย่างทะลุปรุโปร่งเลยครับ

ผมขอเคลียร์ข้อสงสัยเรื่อง WiFi, Data Logger, พัดลมดูดอากาศ และสรุปค่าใช้จ่ายทั้งหมดแบบ "ไม่พงึ่ พา WiFi" เพื่อให้เหมาะกับแปลงเกษตรจริงๆ ดังนี้ครับ:

### 1. เรื่

องระบบ WiFi และ Data Logger (ถ้าไม่มี WiFi ท าอย่างไร?)
หากในโรงเรือน ไม่มี WiFi เราจะไม่ใช้ Smart Plug (อย่าง Sonoff/Tuya) แล้วครับ แต่เราจะแยกหน้าที่กันท างานโดย ใช้อุปกรณ์ 2 ตัวนี้แทน ซึ่งเสถียรและเป็นที่นิยมในงานวิจัยมากครับ:

- ตัวควบคุมการเปิ ด-ปิ ด (Controller): ใช้"ตู้คอนโทรล หรอื เครื่

องควบคุมอุณหภมู ิและความชืน้ แบบ ดิจิตอล" (เช่น รุ่น STC-3028) ตัวนี้ไม่ต้องใช้ WiFi ครับ แค่ต่อสายไฟเข้า ตั้งค่าหน้าจอว่า "ถ้าอุณหภูมิถึง 35°C ให้จ่ายไฟไปที่ปั๊มและพัดลม" มันจะท างานอัตโนมัติ 100% เลยครับ

- ตัวเก็บข้อมูลวิจัย (Data Logger): "ต้องมีครับ" เพราะเราไม่มี WiFi ส่งข้อมูลเข้ามือถือ แนะน าให้ซื้อ "USB Data Logger" (เช่น ยี่ห้อ Elitech รุ่น RC-4HC หรือ UT330) ตัวนี้ขนาดเท่าแฟลชไดรฟ์ น าไปแขวนไว้ใน โรงเรือน มันจะบันทึกอุณหภูมิและความชื้นทุกๆ 10 นาที (หรือตามที่เราตั้ง) พอครบสัปดาห์ น้องฝึกงานก็แค่ดึง ไปเสียบกับคอมพิวเตอร์ ข้อมูลจะออกมาเป็นกราฟและตาราง Excel สวยงาม พร้อมน าไปวิเคราะห์ใน SPSS ได้ ทันทีครับ!

### 2. เรื่

องพัดลมดูดอากาศ และการกันแมลง
คุณพี่เข้าใจถูกต้อง 100% ครับ! ถ้าติดพัดลมดูดอากาศธรรมดา พอพัดลมดับ แมลงจะบินสวนเข้ามาในโรงเรือนทันที ซึ่ง ท าลายความเป็น "โรงเรือนระบบปิด" ครับ
- ทางแก้: ต้องซื้อพัดลมระบายอากาศชนิด "มีบานเกล็ดเปิ ด-ปิ ดอัตโนมัติ (Gravity Shutter หรือ

Louver)" ครับ

- หลักการท างาน: ตอนพัดลมหมุน แรงลมจะเป่ าให้บานเกล็ดเปิดออก แต่พอตัวควบคุมสั่งให้พัดลมหยุด บาน เกล็ดจะตกลงมาปิดสนิทตามแรงโน้มถ่วงทันที ช่วยป้องกันแมลงและหนูได้อย่างสมบูรณ์แบบครับ

สรุปงบประมาณทงั้หมด (Bill of Materials แบบครบวงจร) (ราคานเี้ป็นราคาประเมนิเบอื้งตน้จากการส่งัซือ้ออนไลนแ์ ละหา้งวสัดกุ ่อสรา้งครบั)

หมวดหมู่ | รายการอุปกรณ์ | รายละเอียดสเปก | ราคาประมาณ (บาท)
้และพ่น 1. ระบบนา หมอก | ปั๊มน ้าแรงดันสูง | ปั๊มไดอะแฟรม 12V (8-10 Bar) + Adapter 220V | 700
| ชุดหัวพ่นหมอก | ทองเหลือง 0.1 mm (10-15 หัว) + สาย PE 15m. | 400
| อุปกรณ์ถังพักน ้า | ลูกลอยก้านทองเหลือง 1/2 นิ้ว + หัว กรองทางดูด | 250

หมวดหมู่ | รายการอุปกรณ์ | รายละเอียดสเปก | ราคาประมาณ (บาท)
2. ระบบควบคุม (ไม่มี WiFi) | เครื่องควบคุม อุณหภูมิ | ควบคุมอุณหภูมิ+ความชื้นแบบ ดิจิตอล (STC-3028) | 350
| USB Data Logger | บันทึกอุณหภูมิ/ความชื้น เพื่อโหลดลง Excel (เช่น Elitech) | 800
3. ระบบระบายอากาศ | พัดลมบานเกล็ด | พัดลมดูดอากาศแบบมีบานเกล็ดเปิด-ปิดอัตโนมัติ (8-10 นิ้ว) | 850
4. ระบบไฟฟ้าและ ความปลอดภัย | ตู้กันน ้า + เบรก เกอร์ | กล่องพลาสติก IP65 + เบรกเกอร์กัน ดูด RCBO (16A) | 700
| สายไฟและสาย ดิน | สายไฟ VAF, สายกราวด์, แท่งกราวด์ ทองแดง, ดินน ้ามันอุดรู | 400
| รวมงบประมาณ สุทธิ | พร้อมท าวิจัยอย่างปลอดภัยและ ได้มาตรฐาน | ประมาณ 4,450 บาท

บทสรุปส าหรับโครงร่างโปรเจกต์ (Proposal)
ด้วยงบประมาณไม่เกิน 4,500 - 5,000 บาทนี้ คุณพี่จะได้ระบบที่:
1. อัตโนมัติ 100%: ไม่ต้องใช้อินเทอร์เน็ต ไม่ต้องเฝ้า ระบบจัดการตัวเองด้วยเซนเซอร์
2. ปลอดภัย 100%: มีเบรกเกอร์กันดูด มีสายดิน และใช้ไฟกระแสตรง (DC 12V) ในจุดที่โดนน ้า
3. งานวิจัยได้มาตรฐาน: มี USB Data Logger คอยเก็บตัวเลขสภาพแวดล้อม (Microclimate) ให้ทุกนาที ซึ่ง จะท าให้อาจารย์ที่ตรวจปัญหาพิเศษเชื่อมั่นในผลลัพธ์ของปุ๋ ยเจลคีเลตอย่างไม่มีข้อสงสัยครับ

คุณพี่สามารถก็อปปี้ตารางนี้ไปใส่ในงบประมาณของเล่มโครงร่างปัญหาพิเศษ (Special Project Proposal) ให้น้อง ฝึกงานส่งอาจารย์ได้เลยนะครับ!

คุณพี่ตัดสินใจถูกต้องเลยครับ! การเลือกใช้ระบบที่ท างานจบในตัวเอง (Standalone) แบบไม่ต้องพึ่งพา WiFi ถือเป็น ทางเลือกที่ "เสถยีรทสี่ ุด" ส าหรับงานวิจัยในระดับแปลงทดลองเกษตรครับ

ผมขอเสริมเหตุผลที่ท าให้การไม่ใช้ WiFi เป็นข้อได้เปรียบของโปรเจกต์นี้ เพื่อให้น้องฝึกงานเอาไว้ตอบค าถามอาจารย์ ครับ:

- โครงเหล็กคือศัตรูของ WiFi: โรงเรือนที่มีโครงสร้างเป็นเหล็กและคลุมด้วยพลาสติกหรือมุ้งตาข่าย มักจะท า หน้าที่คล้ายกรงฟาราเดย์ (Faraday cage) อ่อนๆ ซึ่งจะลดทอนสัญญาณ WiFi ให้ดร็อปลงอย่างมาก การติด กล่องขยายสัญญาณ (Repeater) จึงมักเจอปัญหาสัญญาณหลุดบ่อยครับ
- ความเสถยีรเมื่

อไฟตก: หากใช้ระบบ Smart Plug ที่ต่อ WiFi เวลาไฟฟ้าย่อยที่แปลงเกิดตกหรือดับชั่วคราว พอไฟมา อุปกรณ์มักจะต้องใช้เวลารอเชื่อมต่ออินเทอร์เน็ตใหม่ (บางทีเราเตอร์เอ๋อ ก็ไม่ยอมเชื่อมต่อ) แต่ถ้าใช้ตู้ คอนโทรล STC-3028 อย่างที่เราวางแผนไว้ พอไฟมาปุ๊ บ มันอ่านค่าเซนเซอร์แล้วสั่งปั๊มน ้าท างานต่อได้ทันทีใน 1 วินาทีเลยครับ

- ข้อมูลไม่สูญหายชัวรๆ์ : การใช้ USB Data Logger เก็บข้อมูลไว้ในตัวเครื่อง (Offline) ท าให้เราไม่ต้องกังวล เรื่องคลาวด์ล่ม อินเทอร์เน็ตตัด หรือเน็ตหลุดจนกราฟอุณหภูมิแหว่ง ซึ่งส าคัญมากส าหรับงานวิจัยที่ต้องการ ความแม่นย าครับ

สบายใจได้เลยครับ แผนและงบประมาณที่เราจัดเตรียมกันไว้นี้ทั้งประหยัด ทนทาน และตอบโจทย์เกณฑ์การท าวิจัยทาง วิทยาศาสตร์ได้อย่างสมบูรณ์แบบครับ

หากถึงขั้นตอนการเริ่มซื้อของ ประกอบตู้คอนโทรล หรือเดินสายไฟจริง แล้วน้องฝึกงานเกิดสับสนเรื่องการต่อสาย L (Line) กับ N (Neutral) คุณพี่สามารถถ่ายรูปอุปกรณ์มาให้ผมช่วยเขียนวงจรให้ดูได้ตลอดเลยนะครับ เป็นก าลังใจให้การ สอบหัวข้อโปรเจกต์ผ่านฉลุยครับ!

ป็นเรื่องที่คนท าระบบแปลงเกษตรจริงเจอกันบ่อยจนกลายเป็น "ฝันร้าย" เลยครับ! หลายโปรเจกต์ที่ลงทุนท า Smart Farm ควบคุมผ่านแอปพลิเคชันอย่างดี ต้องมาตกม้าตายเพราะเน็ตหลุดหรือเราเตอร์ค้างนี่แหละครับ พอเราไม่อยู่หน้า แปลงแล้วระบบพ่นหมอกไม่ยอมท างานเมื่อถึงอุณหภูมิวิกฤต ผักสลัดในโรงเรือนที่ก าลังโตสามารถเหี่ยวเฉาหรือเกิด อาการใบไหม้ (Tip burn) ได้ภายในไม่กี่ชั่วโมงเลยครับ

การตัดสินใจตัดระบบ WiFi ออก แล้วใช้ตู้คอนโทรลที่ต่อสายตรงเข้าอุปกรณ์ (Hardwired Standalone) ถือเป็นการ แก้ปัญหาแบบ "Industrial Grade" (มาตรฐานอุตสาหกรรม) ที่เน้นความถึก ทน และแน่นอนที่สุดครับ ไม่ว่าไฟฟ้า ย่อยจะตกหรือกระชากแค่ไหน ทันทีที่ไฟกลับมา ระบบจะเช็กค่าอุณหภูมิและความชื้น แล้วสั่งปั๊มและพัดลมระบายอากาศ ท างานต่อทันทีแบบไร้รอยต่อครับ

ตอนนี้ถือว่าแผนการเตรียมโรงเรือนและการคุมสภาพแวดล้อม (Microclimate) เพื่อไม่ให้เป็นตัวแปรแทรกซ้อนนั้น "ปิ ด จุดอ่อน" ได้ครบถ้วนทุกมิติแล้วครับ ทั้งกันหนู กันแมลง คุมอุณหภูมิ และระบบไฟฟ้าที่ปลอดภัย

เตรียมตัวลุยงานทดลองต่อยอดปุ๋ ยเจลคีเลตในเดือนหน้าได้อย่างมั่นใจเลยครับ! และถ้าถึงช่วงที่ต้องเริ่มต่อวงจรตั้งค่าตู้ คอนโทรล หรือเมื่อเก็บข้อมูลจาก Data Logger มาแล้วและต้องการให้ช่วยวิเคราะห์สถิติใน SPSS เพื่อดูประสิทธิภาพ ของปุ๋ ยเจลคีเลตเปรียบเทียบกับรอบที่ผ่านมา แวะมาสอบถามได้ตลอดเวลาเลยนะครับ

เป็นก าลังใจให้ส าหรับโปรเจกต์ใหม่นี้ครับ รับรองว่าข้อมูลที่ได้จะมีความแม่นย าและเป็นผลงานวิจัยที่สมบูรณ์แบบมากๆ แน่นอนครับ!

โอ้โห! ถ้าจัดทีมแบบนี้ ถือว่าเป็น "Dream Team" ส าหรับงานวิจัยด้านเทคโนโลยีการเกษตร (AgTech) เลยครับคุณพี่! การจับคู่ข้ามสายงานแบบนี้จะท าให้น้องทั้งสองคนได้เรียนรู้การท างานแบบบูรณาการ ซึ่งถอดแบบมาจากการท างานใน วงการวิจัยสมัยใหม่เลยครับ

การที่คุณพี่เป็นที่ปรึกษาและจัดสรรทีมแบบนี้ จะช่วยดึงศักยภาพของน้องๆ ออกมาได้ตรงจุดมาก ผมขอเสนอไอเดียการ แบ่งขอบเขตงานเพื่อให้การท างานร่วมกันของทั้งคู่ราบรื่นและได้ประโยชน์สูงสุดดังนี้ครับ:

### 1. ภารกิจของน้องวิศวะคอมฯ (IT Intern - ปี 2 มจธ.)

ส าหรับเด็กวิศวะคอมฯ อินเตอร์ มจธ. การต่อสายไฟตู้คอนโทรล STC-3028 หรือระบบปั๊มน ้า 12V พื้นฐานน่าจะท าได้ สบายๆ อยู่แล้วครับ แต่เพื่อให้น้องได้ "หาประสบการณ์" ที่ท้าทายและคุ้มค่ากับการมาฝึกงาน คุณพี่อาจจะขยายโจทย์ใน ส่วนของ Data ให้มีความเป็นวิศวกรรมคอมพิวเตอร์มากขึ้นครับ:

- DIY Data Logger (ถ้าอยากให้ลองของจริง):แทนที่จะซื้อ Data Logger ส าเร็จรูป คุณพี่อาจจะให้น้อง ลองใช้บอร์ด Microcontroller (เช่น ESP32 หรือ Arduino) ต่อกับเซนเซอร์วัดอุณหภูมิ/ความชื้น (DHT22) เขียนโค้ด (C/C++ หรือ MicroPython) เพื่อเก็บข้อมูลลง SD Card ด้วยตัวเอง
- Automated Data Preparation: ให้น้องรับผิดชอบการเขียนสคริปต์สั้นๆ (เช่น Python) เพื่อดึงข้อมูล สภาพแวดล้อมดิบๆ มาจัดการรูปแบบ (Data Cleansing) ให้ออกมาเป็นไฟล์ตารางที่สะอาด สวยงาม และ พร้อมที่สุดส าหรับให้น้องเกษตรเอาไปรันสถิติต่อ

### 2. ภารกิจของน้องเกษตร (Agri Intern - ปี 4)

เมื่อมีผู้ช่วยมาดูแลเรื่องระบบฮาร์ดแวร์และการเก็บ Log Data น้องปี 4 จะได้สลัดความกังวลเรื่องอุปกรณ์ แล้วมาสวม หมวก "นักวิจัย" เพื่อท าปัญหาพิเศษได้อย่างเต็มที่ 100% ครับ:

- ดูแลตัวแปรทางชีววิทยา: โฟกัสการผสมปุ๋ ยเจลคีเลต การวัดการเจริญเติบโต (น ้าหนัก, ความสูง, จ านวนใบ) และการประเมินคะแนนใบไหม้ (Tip burn score)
- การวิเคราะหผ์ ลและการเชื่

อมโยง: น าข้อมูลสภาพแวดล้อมที่น้อง IT เตรียมให้ มาชนกับข้อมูลการ เจริญเติบโต เพื่อวิเคราะห์ ANOVA และหาค่า Correlation เชิงลึกตามหลักสรีรวิทยาพืช

การท างานคู่กันแบบนี้ น้องเกษตรจะได้เรียนรู้ว่าเทคโนโลยีเข้ามาช่วยคุมตัวแปรแทรกซ้อนให้งานวิจัยแม่นย าขึ้นได้อย่างไร ส่วนน้องวิศวะคอมฯ ก็จะได้เห็นว่าโค้ดหรือระบบที่ตัวเองสร้างขึ้นมา ส่งผลต่อสิ่งมีชีวิตและการแก้ปัญหาทางสถิติได้จริง ถือเป็นการฝึกงานที่จะเป็นประโยชน์กับโปรไฟล์ของทั้งคู่มากๆ ครับ

คุณพอี่ ยากใหผ้ มช่วยร่าง "ขอบเขตงาน (Mini-Project Scope)" สั้
นๆ เฉพาะของฝ่

ังน้องวิศวะคอมฯ เพอื่ ให้
คุณพนี่ า ไปใช้บรีฟน้องในสัปดาหแ์รกทเี่ริ่
มงานเลยไหมครับ?
จัดท า "ขอบเขตงาน (Mini-Project Scope)" ให้เรียบร้อยครับ คุณพี่สามารถน าโครงร่างนี้ไปปรับใช้ หรือปรินต์ให้น้อง วิศวะคอมฯ (IT) อ่านในวันปฐมนิเทศเริ่มงานได้เลยครับ

โครงร่างนี้ออกแบบมาให้ตรงกับทักษะของนักศึกษาวิศวกรรมคอมพิวเตอร์ ปี 2 (ที่มักจะมีพื้นฐานเขียนโค้ด แต่ต้องการ ประสบการณ์ลงมือท าฮาร์ดแวร์จริง) และเน้นให้งานของน้อง IT ไปซัพพอร์ตงานสถิติของน้องเกษตรได้อย่างไร้รอยต่อครับ

ขอบเขตงาน (Mini-Project Scope)
ส าหรับนักศึกษาฝึ กงานแผนก IT (ระยะเวลาด าเนินการ: ตลอดช่วงฝึ กงาน) ชื่

อโครงการ: การพัฒนาระบบควบคุม สภาพแวดล้อมอัตโนมัติแบบออฟไลน์ และท่อส่งข้อมูล (Data Pipeline) ส าหรับโรงเรือนวิจัยทางการเกษตร

วัตถุประสงค์ (Objectives)
เพื่อออกแบบและติดตั้งระบบฮาร์ดแวร์ควบคุมอุณหภูมิและความชื้นในโรงเรือนแบบ Standalone (ไม่พึ่งพาอินเทอร์เน็ต) ที่มีความปลอดภัยสูง พร้อมทั้งพัฒนาระบบจัดการข้อมูล (Data Cleansing) เพื่อส่งต่อให้นักวิจัยน าไปประเมิน ประสิทธิภาพปุ๋ ยได้อย่างแม่นย า

ขอบเขตงานหลักแบ่งเป็ น 3 ระยะ (Phases of Work)

Phase 1: Hardware Engineering & Safety (การออกแบบและประกอบตู้คอนโทรล)
- ภารกิจ: ต่อวงจรและประกอบตู้คอนโทรล (Control Box) โดยใช้เครื่องควบคุมอุณหภูมิดิจิทัล (เช่น STC-3028) เพื่อสั่งการปั๊มน ้า 12V และพัดลมระบายอากาศ 220V ให้ท างานสัมพันธ์กันตามอุณหภูมิที่ก าหนด
- โจทย์ความท้าทาย (Engineering Challenge): * ออกแบบระบบให้รอดพ้นจากสภาวะไฟกระชากและไฟตก

(Auto-recovery)

- วางระบบความปลอดภัยขั้นสูงสุด (Electrical Safety) โดยแยกระบบไฟ AC/DC อย่างชัดเจน และ ต้องติดตั้งเบรกเกอร์กันดูด (RCBO) รวมถึงการท าระบบสายดิน (Grounding) ให้กับโครงสร้าง โรงเรือนเหล็ก

Phase 2: Offline Data Logging System (ระบบบันทกึข้อมูลแบบไร้สายสัญญาณ)
- ภารกิจ: ติดตั้งและดูแลระบบบันทึกข้อมูลสภาพแวดล้อมย่อย (Microclimate: อุณหภูมิและความชื้น)

- โจทย์ความท้าทาย (Engineering Challenge): สามารถเลือกใช้ USB Data Logger ส าเร็จรูป หรือ หาก
ต้องการท้าทายทักษะ สามารถพัฒนา DIY Data Logger โดยใช้บอร์ด Microcontroller (เช่น Arduino หรือ ESP32) + เซนเซอร์ DHT22 เพื่อเขียนโปรแกรม (C/C++ หรือ MicroPython) ให้บันทึกข้อมูลลง SD Card

แบบออฟไลน์ (Time-series data)

Phase 3: Data Pipeline & Data Cleansing (การจัดการและทา ความสะอาดข้อมูล)
- ภารกิจ:ข้อมูลที่ดึงมาจาก Data Logger มักจะเป็นข้อมูลดิบ (Raw Data) ที่มีจ านวนหลายหมื่นบรรทัด
- โจทย์ความท้าทาย (Engineering Challenge): ให้เขียนสคริปต์สั้นๆ (เช่น ใช้ภาษา Python หรือใช้ เครื่องมือ Power Query ใน Excel) เพื่อท าหน้าที่เป็น "Data Pipeline"
- กรองข้อมูลที่ผิดปกติ (Outliers) หรือ Error ออก
- จัดรูปแบบและสรุปข้อมูลให้เป็นตารางที่อ่านง่าย (เช่น หาค่าเฉลี่ยอุณหภูมิทุกๆ 1 ชั่วโมง หรือสรุปค่า T-max, T-min ของแต่ละวัน)
- เป้าหมายสูงสุด: ส่งมอบไฟล์ Excel ที่สมบูรณ์แบบให้กับทีมนักวิจัยเกษตร เพื่อน าไปเข้าโปรแกรม SPSS ในการหาค่า Correlation ระหว่างอุณหภูมิกับการเกิดโรคใบไหม้ (Tip burn) ได้ทันที

การท างานร่วมกันข้ามสายงาน (Cross-functional Collaboration)
- Agri-Tech Integration: ต้องสื่อสารกับทีมนักวิจัยเกษตร เพื่อท าความเข้าใจโดเมนความรู้เรื่อง "จุดวิกฤตของ ความชื้น (VPD) ที่ท าให้พืชปิดปากใบ" เพื่อน าตัวเลขเหล่านั้นมาตั้งค่าจุดตัดการท างาน (Threshold) ในตู้ คอนโทรลของตัวเองได้อย่างถูกต้อง

สิ่

งทตี่ ้องส่งมอบ (Deliverables)
1. ตู้คอนโทรลที่ใช้งานได้จริง ปลอดภัย 100%
2. สคริปต์หรือเครื่องมือท าความสะอาดข้อมูล (Data Cleansing Script)
3. ผังวงจร (Wiring Diagram) และคู่มือการใช้งานสั้นๆ 1 หน้ากระดาษ เพื่อให้ทีมเกษตรดูแลต่อได้ในอนาคต

คา แนะนา เพมิ่ เตมิสา หรับคุณพี่
:
การบรีฟงานด้วย SOW ตัวนี้ จะท าให้น้องปี 2 เห็นภาพว่า "วิศวะคอมฯ มาท าอะไรในแปลงเกษตร" น้องจะรู้ว่าตัวเอง ไม่ได้มาแค่ต่อสายไฟรดน ้าต้นไม้ แต่ก าลังท าระบบ IoT Hardware & Data Engineering ย่อส่วน ซึ่งเป็นทักษะที่น าไป ใส่ในเรซูเม่ (Resume) สาย Tech ได้อย่างภาคภูมิใจเลยครับ

และเมื่อข้อมูลฝั่งสภาพแวดล้อมถูกคลีนจนสะอาดด้วยฝีมือน้อง IT แล้ว ข้อมูลฝั่งสถิติที่น้องเกษตรท าก็จะยิ่งทรงพลังขึ้น อีกระดับครับ เตรียมตัวสนุกกับรอบนี้ได้เลยครับ! หากถึงขั้นตอนเขียนสคริปต์จัดการข้อมูลแล้วน้อง IT ติดขัด หรือต้องการ ค าแนะน าเรื่อง Python แวะมาถามผมได้ตลอดเลยนะครับ
