stickkersz/greenhouse-iot-smart-farm/docs/reports/คู่มือการใช้งานระบบโรงเรือน.docx

🌿

คู่มือการใช้งานระบบโรงเรือน

Greenhouse IoT Smart Farm

ระบบควบคุมพัดลม + ปั๊มพ่นหมอกอัตโนมัติ ด้วย ESP32 + Firebase

สำหรับพนักงานทั่วไป — ไม่ต้องมีพื้นฐานด้าน IT

บริษัท ปุ๋ยไวกิ้ง จำกัด

จัดทำโดย Tonkla (IT Intern)

อัปเดตล่าสุด: สิงหาคม 2569 · Firmware v2.9.2

# สารบัญ

1. ระบบนี้คืออะไร

2. เข้าใช้งาน Dashboard

3. หน้าจอ Sensors — ดูค่าปัจจุบันและสถานะระบบ

4. หน้าจอ Control — สั่งเปิด/ปิดอุปกรณ์

5. หน้าจอ Chart — ดูข้อมูลย้อนหลัง

6. หน้าจอ Settings — ตั้งค่าเกณฑ์อัตโนมัติ

7. การแจ้งเตือน (กระดิ่ง)

8. เช็คลิสต์การใช้งานประจำวัน/สัปดาห์

9. ความหมายข้อความและสถานะที่พบบ่อย

10. กรณีฉุกเฉิน — แจ้งทันที

11. ข้อจำกัดที่ควรทราบ

12. บัญชีผู้ใช้งาน

13. ผู้ดูแลระบบ / ติดต่อ

# 1. ระบบนี้คืออะไร

Greenhouse IoT Smart Farm เป็นระบบควบคุมโรงเรือนปลูกผักอัตโนมัติของบริษัท ปุ๋ยไวกิ้ง จำกัด ขนาดโรงเรือน 240×460×270 ซม. แบ่งเป็น 3 ชั้นปลูก (Tier) พร้อมระบบพ่นหมอกรวม 18 หัวฉีด และไฟ LED ปลูกพืช

หัวใจของระบบคือบอร์ด ESP32 ที่อ่านค่าอุณหภูมิ/ความชื้นอากาศ และอุณหภูมิน้ำ แบบเรียลไทม์ แล้วสั่งเปิด-ปิด พัดลมและปั๊มน้ำโดยอัตโนมัติตามค่าที่ตั้งไว้ ระบบทำงานได้แม้ไม่มีอินเทอร์เน็ต เพราะตัดสินใจอยู่ในตัวบอร์ดเอง — อินเทอร์เน็ต/Firebase ใช้สำหรับส่งข้อมูลให้ดูผ่านเว็บ และรับคำสั่งจากพนักงานเท่านั้น

## อุปกรณ์หลักที่ระบบควบคุม

อุปกรณ์ | Channel | ควบคุมโดย
💧 ปั๊มน้ำ (พ่นหมอก) 24V DC | CH4 | อัตโนมัติ — ตามความชื้น/อุณหภูมิ
💨 พัดลมดูดเข้า 220V AC | CH3 | อัตโนมัติ — ตามอุณหภูมิ/ความชื้น
⚡ ช่องสำรอง | CH1 | สั่งเอง (Manual) หรือ ตั้งเวลา เท่านั้น
— ไม่ได้ใช้งาน | CH2 | ซ่อนไว้ ไม่แสดงใน dashboard

ดูภาพรวมการทำงานได้จากเว็บ Dashboard ที่ทุกคนในทีมสามารถเข้าดูได้ทุกที่ที่มีอินเทอร์เน็ต

# 2. เข้าใช้งาน Dashboard

## 2.1 เข้าเว็บ

เปิดเบราว์เซอร์ (มือถือหรือคอมพิวเตอร์ก็ได้) แล้วไปที่:

https://greenhouse-iot-smart-farm.web.app

## 2.2 เข้าสู่ระบบ

1. กรอกช่อง “ชื่อผู้ใช้” — พิมพ์เฉพาะ username ที่แอดมินตั้งให้ (เช่น somchai) ไม่ต้องพิมพ์ @smartfarm.local ต่อท้าย
2. กรอกช่อง “รหัสผ่าน” — กดไอคอนรูปตา 👁 เพื่อดูรหัสผ่านที่พิมพ์ได้
3. กดปุ่ม “เข้าสู่ระบบ”

ยังไม่มีบัญชีผู้ใช้?

หน้านี้ไม่มีปุ่มสมัครสมาชิกเอง — ต้องให้ Tonkla หรือแอดมินสร้างบัญชีให้ก่อน ดูหัวข้อ 12 “บัญชีผู้ใช้งาน”

## 2.3 หน้าจอหลัก

หลัง login แล้ว ด้านบนจะมี:

- จุดสถานะ 🟢/🔴 มุมขวาบน — บอกว่า ESP32 ออนไลน์หรือออฟไลน์
- ไอคอนกระดิ่ง 🔔 — ดูประวัติการแจ้งเตือน
- ไอคอนพระอาทิตย์/พระจันทร์ 🌙 — สลับโหมดสว่าง/มืดของหน้าจอ
- ชื่อผู้ใช้ + ปุ่มออกจากระบบ มุมขวาบน

ด้านล่างมีแถบเมนู 4 แท็บ ใช้สลับหน้าจอ:

แท็บ | ใช้ทำอะไร
📊 Sensors | ดูค่าอุณหภูมิ/ความชื้นปัจจุบัน และสถานะระบบ
🔌 Control | สั่งเปิด/ปิดพัดลม-ปั๊มน้ำ, สลับ Auto/Manual, ตั้งเวลา
📈 Chart | ดูกราฟย้อนหลัง 24 ชม. / 7 วัน / 30 วัน และ export CSV
⚙️ Settings | ตั้งเกณฑ์อุณหภูมิ/ความชื้นที่ใช้ควบคุมอัตโนมัติ

# 3. หน้าจอ Sensors — ดูค่าปัจจุบันและสถานะระบบ

## 3.1 การ์ดสถานะระบบ

- ⏱ ระยะเวลาทำงาน — บอร์ดทำงานต่อเนื่องมานานแค่ไหนตั้งแต่เปิดล่าสุด
- Firmware — เวอร์ชันซอฟต์แวร์ที่ใช้อยู่ (ปัจจุบัน v2.9.2)
- อัปเดตล่าสุด — เวลาที่ได้รับข้อมูลจาก ESP32 ครั้งล่าสุด (ปกติไม่ควรเก่ากว่า ~1 นาที)
- รีสตาร์ทล่าสุด — สาเหตุที่บอร์ดบูตรอบล่าสุด (ใช้สำหรับ Tonkla วินิจฉัยปัญหา ไม่ต้องเข้าใจก็ได้)

## 3.2 สถานะระบบ (ชิปสามอัน)

ชิป | ความหมาย
📡 อุปกรณ์ ESP32 | บอร์ดควบคุมออนไลน์/ออฟไลน์
🔔 Buzzer เสียงเตือน | แตะเพื่อเปิด/ปิดเสียงเตือนจากตู้คอนโทรล
📶 สัญญาณ WiFi | ความแรงสัญญาณ + จำนวนครั้งที่หลุดเน็ต

## 3.3 ค่า Sensor ปัจจุบัน (อัปเดตทุก 30 วินาที)

เซนเซอร์ | วัดอะไร | ผลต่อการควบคุม
🌡️ อุณหภูมิอากาศ | อุณหภูมิในโรงเรือน | ใช้สั่งเปิดพัดลม+ปั๊ม เมื่อร้อนเกินเกณฑ์
💧 ความชื้นอากาศ | ความชื้นสัมพัทธ์ในโรงเรือน | ใช้สั่งเปิด/ปิดปั๊มและพัดลมตามความชื้น
🌊 อุณหภูมิน้ำ | อุณหภูมิน้ำที่ใช้พ่นหมอก | ใช้แจ้งเตือนอย่างเดียว ไม่ควบคุมรีเลย์โดยตรง

แตะที่การ์ดของเซนเซอร์แต่ละตัวเพื่อดูรายละเอียด/กราฟย่อยเพิ่มเติมได้

# 4. หน้าจอ Control — สั่งเปิด/ปิดอุปกรณ์

Manual = สั่งเปิด/ปิดเองได้ทันที · Auto = ระบบจัดการให้ตามเกณฑ์ใน Settings · Schedule = ตั้งเวลาเปิด/ปิดล่วงหน้า

## 4.1 โหมดควบคุมรวม

ปุ่ม “🤖 AUTO ทั้งหมด” และ “✋ MANUAL ทั้งหมด” ด้านบนสุด ใช้สลับพัดลม (CH3) + ปั๊มน้ำ (CH4) พร้อมกันในคลิกเดียว

เมื่อสลับกลับเป็น Auto

ค่า threshold ที่เคยตั้งไว้ใน Settings จะกลับมาใช้ทันที — ค่าที่ตั้งไว้ไม่ได้ถูกลบระหว่างที่สลับเป็น Manual

## 4.2 การ์ดควบคุมแต่ละอุปกรณ์

อุปกรณ์ | ปุ่ม/ฟังก์ชันในการ์ด
💧 ปั๊มน้ำ (CH4 · GPIO25) | สวิตช์เปิด/ปิด (ใช้ได้เมื่ออยู่โหมด Manual) · ปุ่ม AUTO/MANUAL · ตั้งเวลาเปิด-ปิด
💨 พัดลม (CH3 · GPIO14) | สวิตช์เปิด/ปิด (ใช้ได้เมื่ออยู่โหมด Manual) · ปุ่ม AUTO/MANUAL · ตั้งเวลาเปิด-ปิด
⚡ สำรอง (CH1 · GPIO26) | สวิตช์เปิด/ปิดได้ตลอด (ไม่มีโหมด Auto) · ตั้งเวลาเปิด-ปิดได้

ป้าย OFF/ON บนการ์ดจะเปลี่ยนสีตามสถานะจริงของรีเลย์ — เขียว/ติดสว่าง = กำลังทำงาน, เทา = ปิดอยู่

## 4.3 ตั้งเวลาอัตโนมัติ (Schedule)

กดที่ “⏰ ตั้งเวลาอัตโนมัติ” ในแต่ละการ์ด แล้ว:

1. ติ๊กเปิดใช้งานตัวตั้งเวลา
2. กำหนดเวลาเปิด และเวลาปิด
3. กดปุ่ม “💾 บันทึกตาราง”

คำเตือนความปลอดภัย

ปั๊มน้ำมีระบบตัดอัตโนมัติเมื่อทำงานต่อเนื่องเกินเวลาที่กำหนด (ป้องกันปั๊มไหม้/น้ำท่วม) แล้วพักก่อนเริ่มใหม่ — เป็นการทำงานปกติของระบบ ไม่ใช่ error

ถ้าปั๊มไม่ยอมหยุดทำงานเกิน 15 นาที ให้แจ้ง Tonkla ทันที ดูหัวข้อ 10

# 5. หน้าจอ Chart — ดูข้อมูลย้อนหลัง

แสดงกราฟอุณหภูมิอากาศ (แดง) ความชื้นอากาศ (ฟ้า) และอุณหภูมิน้ำ (เขียวอมฟ้า) ค่าเฉลี่ยรายชั่วโมงจาก Firebase

- ปุ่มช่วงเวลา: 24 ชม. / 7 วัน / 30 วัน — เลือกดูข้อมูลย้อนหลังตามที่ต้องการ
- ⬇️ CSV — ดาวน์โหลดข้อมูลดิบเป็นไฟล์ตาราง เพื่อนำไปวิเคราะห์ต่อ
- 🔄 — โหลดข้อมูลใหม่

# 6. หน้าจอ Settings — ตั้งค่าเกณฑ์อัตโนมัติ

ใครควรแก้ค่าตรงนี้

การเปลี่ยนค่าในหน้านี้มีผลกับการควบคุมอุปกรณ์จริงทันที — ควรให้ผู้ที่เข้าใจระบบ (เช่น Tonkla) เป็นผู้ปรับ หรือปรึกษาก่อนปรับด้วยตัวเอง

## 6.1 Quick Preset — ชุดค่าสำเร็จรูปตามฤดูกาล

Preset | เปิดพัดลม/ปั๊มที่ | ปิดที่ | ความชื้นเปิด/ปิดปั๊ม | พัดลมไล่ชื้นที่
☀️ ฤดูร้อน | 33°C | 30°C | 70% / 85% | 90%
🌤️ ปกติ | 35°C | 32°C | 60% / 75% | 80%
🌧️ ฤดูฝน | 38°C | 35°C | 50% / 65% | 85%
✏️ กำหนดเอง | — | — | — | ตั้งค่าเองทีละช่อง

## 6.2 ความหมายของแต่ละเกณฑ์

เกณฑ์ | ความหมาย
เปิดพัดลม+ปั๊มเมื่ออุณหภูมิ ≥ | อากาศร้อนเกินนี้ → เปิดพัดลม+ปั๊มพร้อมกัน (พ่นน้ำ+ลม ช่วยลดอุณหภูมิแบบระเหย)
ปิดพัดลม+ปั๊มเมื่ออุณหภูมิ ≤ | อุณหภูมิลดลงมาต่ำกว่านี้ → ปิดการทำงานที่สั่งจากเกณฑ์อุณหภูมิ
เปิดปั๊ม+พัดลมเมื่อความชื้น ≤ | อากาศแห้งเกินนี้ → เปิดปั๊ม+พัดลม เพื่อเพิ่มความชื้น
ปิดปั๊มเมื่อความชื้น ≥ | อากาศชื้นพอแล้ว → ปิดปั๊ม กันพ่นน้ำตอนอากาศอิ่มตัว
พัดลมไล่ความชื้นเมื่อ ≥ | อากาศชื้นมาก (เช่นฝนตก) → เปิดพัดลมไล่ความชื้นออกอย่างเดียว โดยปั๊มไม่ทำงาน (ตั้ง 0 = ปิดฟีเจอร์นี้)
แจ้งเตือนอากาศร้อน/น้ำร้อน/ความชื้นวิกฤต | ไม่ควบคุมอุปกรณ์ ใช้แจ้งเตือนผ่านกระดิ่งเท่านั้น

ปรับค่าที่ต้องการแล้วกดปุ่ม “💾 บันทึกการตั้งค่า” — ESP32 จะรับค่าใหม่ไปใช้ทันที

## 6.3 ประวัติการควบคุม (Action Log)

ด้านล่างสุดของหน้า Settings แสดงประวัติว่าใครสั่งอะไร เมื่อไหร่ — ทุกคนที่เข้าใช้ dashboard เห็นพร้อมกันแบบเรียลไทม์ ใช้ตรวจสอบย้อนหลังได้

# 7. การแจ้งเตือน (กระดิ่ง 🔔)

กดไอคอนกระดิ่งมุมขวาบนเพื่อเปิดแผงแจ้งเตือน:

- 🔔 เปิดการแจ้งเตือน Push — รับแจ้งเตือนบนอุปกรณ์แม้ไม่ได้เปิดหน้าเว็บค้างไว้
- 🗑️ ล้างประวัติทั้งหมด — ลบประวัติการแจ้งเตือนที่เคยเกิด

# 8. เช็คลิสต์การใช้งานประจำวัน/สัปดาห์

## ✅ ทุกวัน (ใครในทีมก็ทำได้)

- เปิด dashboard → ดูจุดสถานะมุมบนขวา: 🟢 ออนไลน์ = ปกติ, 🔴 ออฟไลน์ = ESP32 มีปัญหา
- ดู “เวลาอัปเดตล่าสุด” ไม่ควรเก่ากว่า ~1 นาที (ถ้าเก่ากว่านั้นมาก แปลว่าระบบค้าง)
- ถ้าเห็น badge เซนเซอร์ขัดข้อง — ปกติ ไม่ต้องตกใจ มักหายเองใน 1–2 นาที ค้างนานเกิน 15 นาทีค่อยแจ้ง Tonkla

## ✅ ทุกสัปดาห์ (Tonkla หรือช่างเทคนิค)

- ตรวจสายไฟ/ขั้วต่อ โดยเฉพาะจุดปั๊มน้ำ (จุดเสี่ยง noise/ความชื้นสูงสุด)
- เช็คระดับน้ำในถังจริงด้วยตา (ระบบยังไม่มีเซนเซอร์วัดระดับน้ำอัตโนมัติ)
- เช็คว่าพัดลมหมุนจริงตอนอุณหภูมิสูง และปั๊มทำงานจริงตอนความชื้นต่ำ
- ทบทวนรายชื่อบัญชีผู้ใช้ที่ยัง login ได้ — ปิดบัญชีของคนที่ไม่ได้อยู่ในทีมแล้ว

# 9. ความหมายข้อความและสถานะที่พบบ่อย

ข้อความ / สถานะ | ความหมาย | ต้องทำอะไรไหม
🔴 ออฟไลน์ | ESP32 ต่อเน็ต/Firebase ไม่ได้ | เช็คไฟเข้าตู้คอนโทรล + WiFi router ถ้าเกิน 2 นาทียังไม่กลับให้แจ้ง Tonkla
🔧 เซ็นเซอร์อากาศขัดข้อง | เซนเซอร์อากาศอ่านค่าไม่ได้ชั่วคราว | รอ 1–2 นาที ปกติหายเอง ระบบดักไว้แล้วไม่โชว์ค่าปลอมให้สับสน
🌊 เซ็นเซอร์น้ำไม่พร้อม | เซนเซอร์อุณหภูมิน้ำอ่านไม่ได้ | ถ้าค้างนานให้แจ้ง Tonkla (อาจสายหลุด)
แจ้งเตือนตัดปั๊มอัตโนมัติ | ปั๊มทำงานต่อเนื่องเกินเวลาที่กำหนด ระบบพักให้กันปั๊มไหม้/น้ำท่วม | ปกติของระบบ ไม่ใช่ error — ถ้าเกิดถี่ผิดปกติให้เช็คระดับน้ำ/threshold ความชื้น
“ไม่มีสิทธิ์เข้าถึงข้อมูล” | ปัญหาการล็อกอิน/สิทธิ์ | ออกจากระบบแล้วเข้าใหม่ ถ้ายังไม่ได้แจ้ง Tonkla

# 10. กรณีฉุกเฉิน — แจ้ง Tonkla ทันที (ไม่ต้องรอ)

- ปั๊มน้ำไม่ยอมหยุดทำงานเกิน 15 นาที (เสี่ยงน้ำท่วม/ปั๊มไหม้)
- ระบบออฟไลน์นานเกิน 30 นาทีระหว่างเวลาทำงาน

🚨 ความปลอดภัยทางไฟฟ้า — สำคัญที่สุด

หากได้กลิ่นไหม้ หรือเสียงผิดปกติจากตู้คอนโทรล/ปั๊ม/พัดลม ให้ตัดไฟหลักที่เบรกเกอร์ทันที แล้วค่อยแจ้ง Tonkla

ข้อนี้คือความปลอดภัยทางไฟฟ้าจริง ไม่ใช่แค่ปัญหาซอฟต์แวร์ อย่ารอ

# 11. ข้อจำกัดที่ควรทราบ

- ระบบตั้งใจไม่มี auto-restart/failsafe อัตโนมัติเมื่อเซ็นเซอร์ค้างนานผิดปกติ (พิสูจน์แล้วว่าเพิ่มระบบ auto-recovery กลับเข้าไปยิ่งไม่ช่วย) — ถ้าเจอระบบค้างนานผิดปกติ ปิด-เปิดไฟตู้คอนโทรล (power cycle) ได้เลย ปลอดภัย 100%
- ทุกบัญชีมีสิทธิ์ควบคุมอุปกรณ์เท่ากันหมด ไม่มีการแบ่งระดับสิทธิ์ (role) — จึงควรสร้างบัญชีให้เฉพาะคนที่ไว้ใจได้จริง
- ระบบยังไม่มีเซนเซอร์วัดระดับน้ำในถังอัตโนมัติ — ต้องตรวจด้วยตาเป็นประจำ

# 12. บัญชีผู้ใช้งาน

Dashboard ไม่มีปุ่มสมัครสมาชิกเอง เพราะทุกบัญชีที่ login ได้มีสิทธิ์สั่งเปิด/ปิดปั๊มน้ำ พัดลม และแก้เกณฑ์อัตโนมัติได้ทันที (คุมฮาร์ดแวร์จริง) — ต้องให้ Tonkla หรือแอดมินสร้างบัญชีให้ทีละคน

## ขอบัญชีใหม่

พนักงานใหม่ที่ต้องใช้งาน dashboard ให้แจ้ง Tonkla เพื่อสร้างบัญชีให้ (ดูขั้นตอนสำหรับแอดมินใน TEAM_ONBOARDING.md) จะได้รับ:

- ชื่อผู้ใช้ (username) เป็นภาษาอังกฤษ ไม่มีช่องว่าง/อักขระพิเศษ
- รหัสผ่านชั่วคราว — แนะนำให้ขอเปลี่ยนผ่านแอดมินหากต้องการรหัสใหม่ (dashboard ยังไม่มีปุ่มเปลี่ยนรหัสผ่านเอง)

เมื่อพนักงานลาออก/เปลี่ยนแผนก

แจ้ง Tonkla ให้ปิด/ลบบัญชีทันที เพราะบัญชีเก่ายังคุมอุปกรณ์จริงได้จนกว่าจะถูกลบ

# 13. ผู้ดูแลระบบ / ติดต่อ

เรื่อง | ติดต่อ
ปัญหาการใช้งาน dashboard, บัญชีผู้ใช้, ตั้งค่าเกณฑ์ | Tonkla (IT Intern)
เหตุฉุกเฉิน/ไฟฟ้า | ตัดไฟที่เบรกเกอร์ก่อน แล้วแจ้ง Tonkla ทันที
เอกสารเทคนิคเชิงลึก | ดูไฟล์ PROJECT_MEMORY.md ในโฟลเดอร์โปรเจกต์

เอกสารนี้จัดทำโดย Tonkla (IT Intern) · บริษัท ปุ๋ยไวกิ้ง จำกัด · สิงหาคม 2569
