stickkersz/greenhouse-iot-smart-farm/docs/archive/README.md

# Archive — pre-build planning docs

เอกสารในโฟลเดอร์นี้ทั้งหมดเขียนขึ้น **ก่อน** ระบบถูกสร้างจริง (กลางเดือนมิถุนายน 2569) เก็บไว้เป็นประวัติ
ไม่ใช่ reference ปัจจุบัน — มีเนื้อหาที่ไม่ตรงกับระบบจริงแล้ว (เช่น Soil Moisture sensor ที่ถอดออกไปแล้ว,
DHT22 ที่เปลี่ยนเป็น SHT35 แล้ว, GPIO mapping เดิมที่เปลี่ยนไปแล้ว)

**สำหรับสถานะปัจจุบันจริง ให้ดู `PROJECT_MEMORY.md` ใน `docs/` เท่านั้น**

| ไฟล์ | คืออะไร |
|---|---|
| `CHECKPOINT.md` | Snapshot สถานะวันที่ 2026-07-02 (ยุค firmware v1.5.0) — ผู้เขียนเองก็ทำเครื่องหมาย stale ไว้แล้วในไฟล์ ไม่ใช่ pre-build doc เหมือนรายการอื่นด้านล่าง แต่เก็บไว้ที่นี่เพราะเหตุผลเดียวกัน: เก่ากว่า PROJECT_MEMORY.md มาก |
| `STATUS.md` | Snapshot สถานะช่วงกลางเดือนมิถุนายน — เก่ากว่า PROJECT_MEMORY.md มาก |
| `ESP32_Firmware_Plan.md` | แผน firmware ตอนเริ่มโปรเจกต์ (ก่อนเขียนโค้ดจริง) |
| `Hardware_Checklist.md` | ลิสต์ซื้อของช่วงวางแผน |
| `Smart_Farm_Project_Plan.md` | แผนโปรเจกต์เริ่มต้น |
| `Greenhouse_Equipment_Layout.md`, `_v2.md` | เวอร์ชันร่างของผังอุปกรณ์ — เวอร์ชัน current คือ `Greenhouse_Equipment_Layout_v3.md` ใน `docs/` |
| `IoT_SmartFarm_Proposal.docx`, `_v2.docx` | เอกสารเสนอโครงการฉบับร่าง |
