stickkersz/greenhouse-iot-smart-farm/media/board-photos/S__63660038_0.jpg

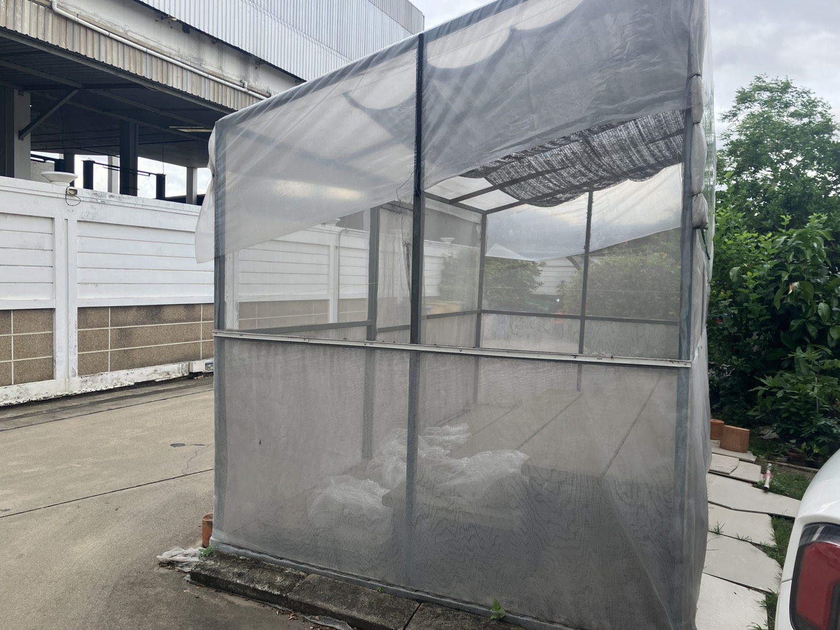
media/board-photos/S__63660038_0.jpg
