stickkersz/greenhouse-iot-smart-farm/media/Layout โรงเรือน/IMG_0816.jpg

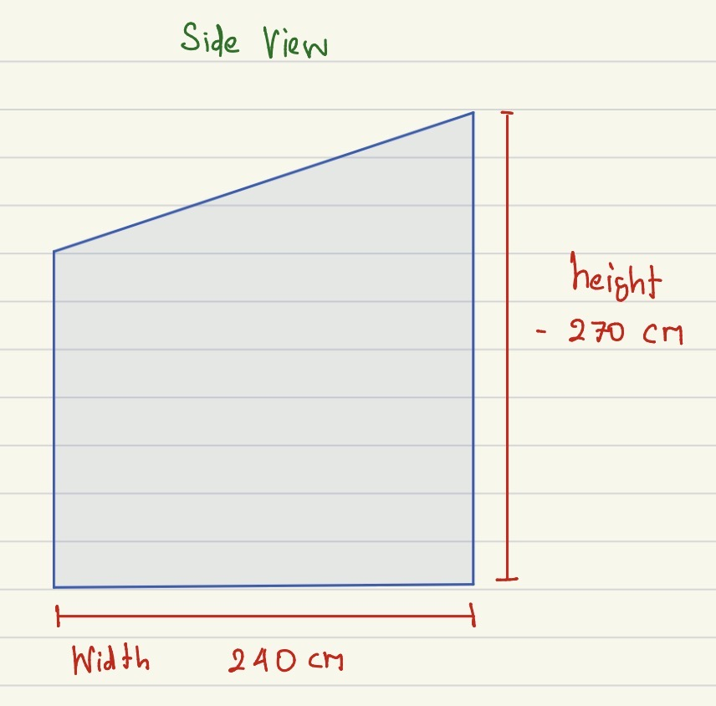
media/Layout โรงเรือน/IMG_0816.jpg
