stickkersz/greenhouse-iot-smart-farm/media/Layout โรงเรือน/IMG_0818.jpg

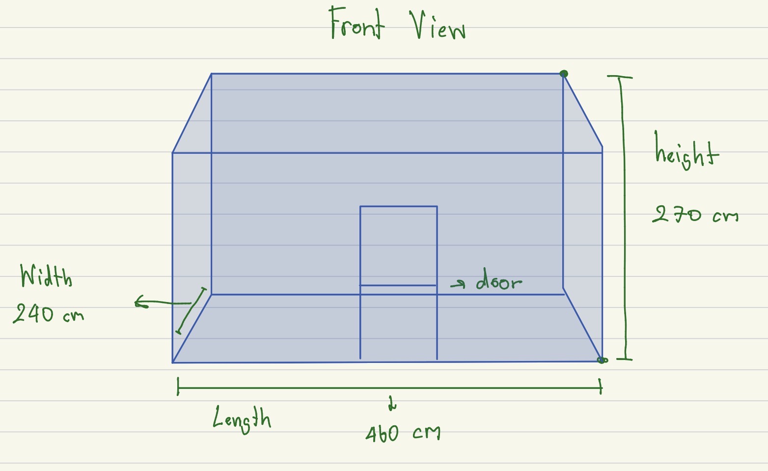
media/Layout โรงเรือน/IMG_0818.jpg
