stickkersz/greenhouse-iot-smart-farm/media/Layout โรงเรือน/IMG_0820.jpg

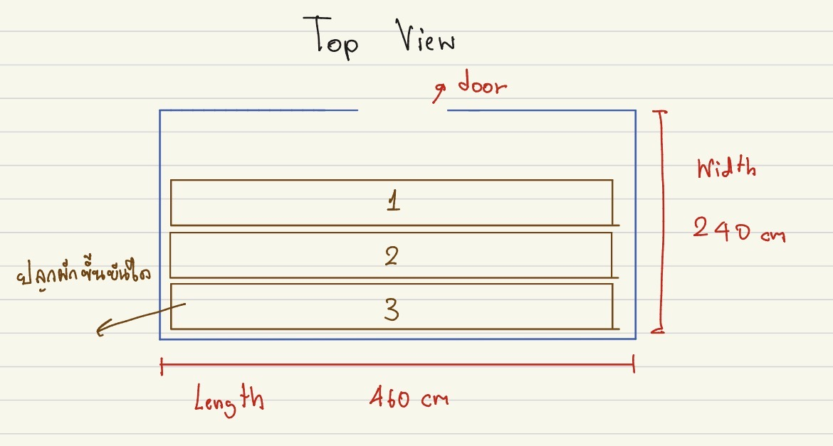
media/Layout โรงเรือน/IMG_0820.jpg
