stickkersz/greenhouse-iot-smart-farm/media/รูปโรงเรือนแบบชัดเจน ครบทุกมุม/IMG_2387.jpg

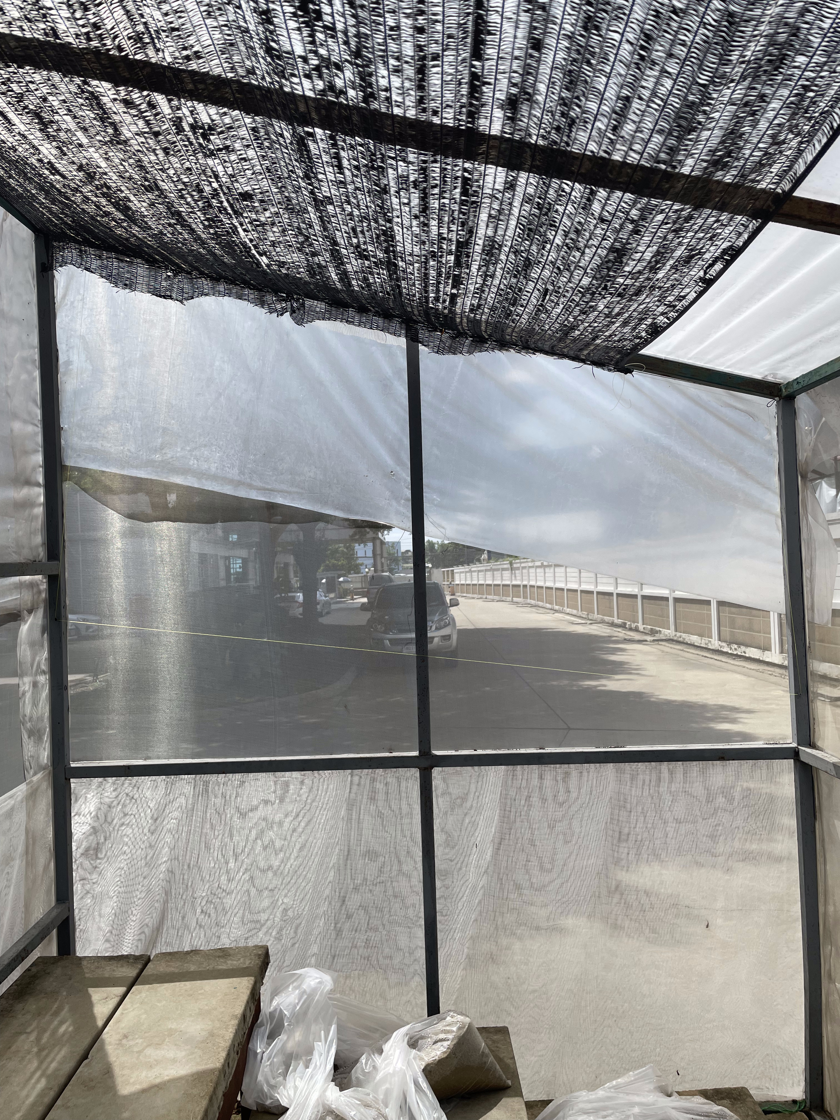
media/รูปโรงเรือนแบบชัดเจน ครบทุกมุม/IMG_2387.jpg
