stickkersz/greenhouse-iot-smart-farm/media/รูปโรงเรือนแบบชัดเจน ครบทุกมุม/IMG_2388.jpg

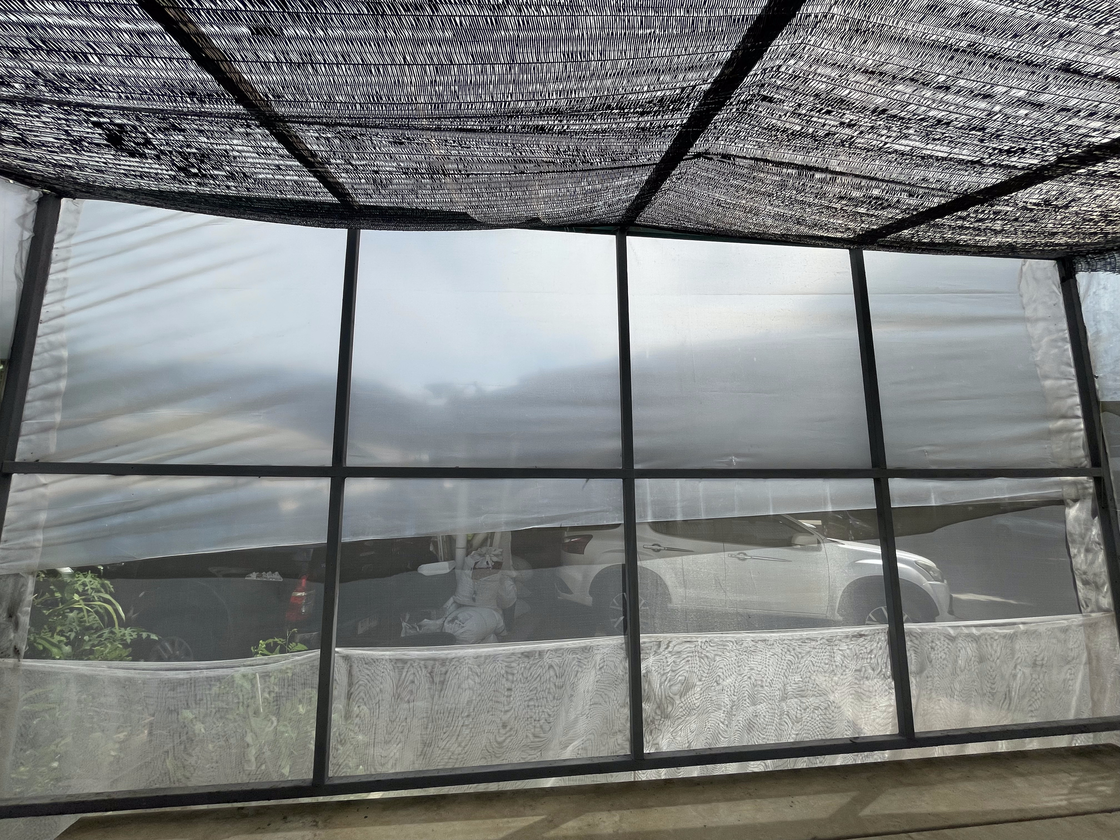
media/รูปโรงเรือนแบบชัดเจน ครบทุกมุม/IMG_2388.jpg
