stickkersz/greenhouse-iot-smart-farm/media/รูปโรงเรือนแบบชัดเจน ครบทุกมุม/IMG_2389.jpg

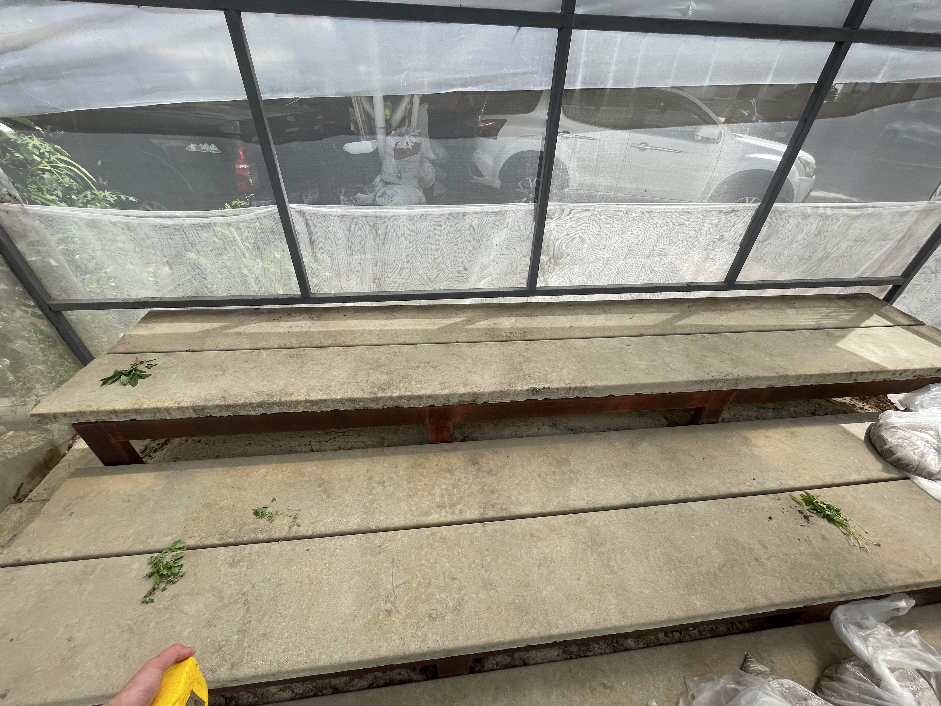
media/รูปโรงเรือนแบบชัดเจน ครบทุกมุม/IMG_2389.jpg
