stickkersz/greenhouse-iot-smart-farm/media/รูปโรงเรือนแบบชัดเจน ครบทุกมุม/IMG_2390.jpg

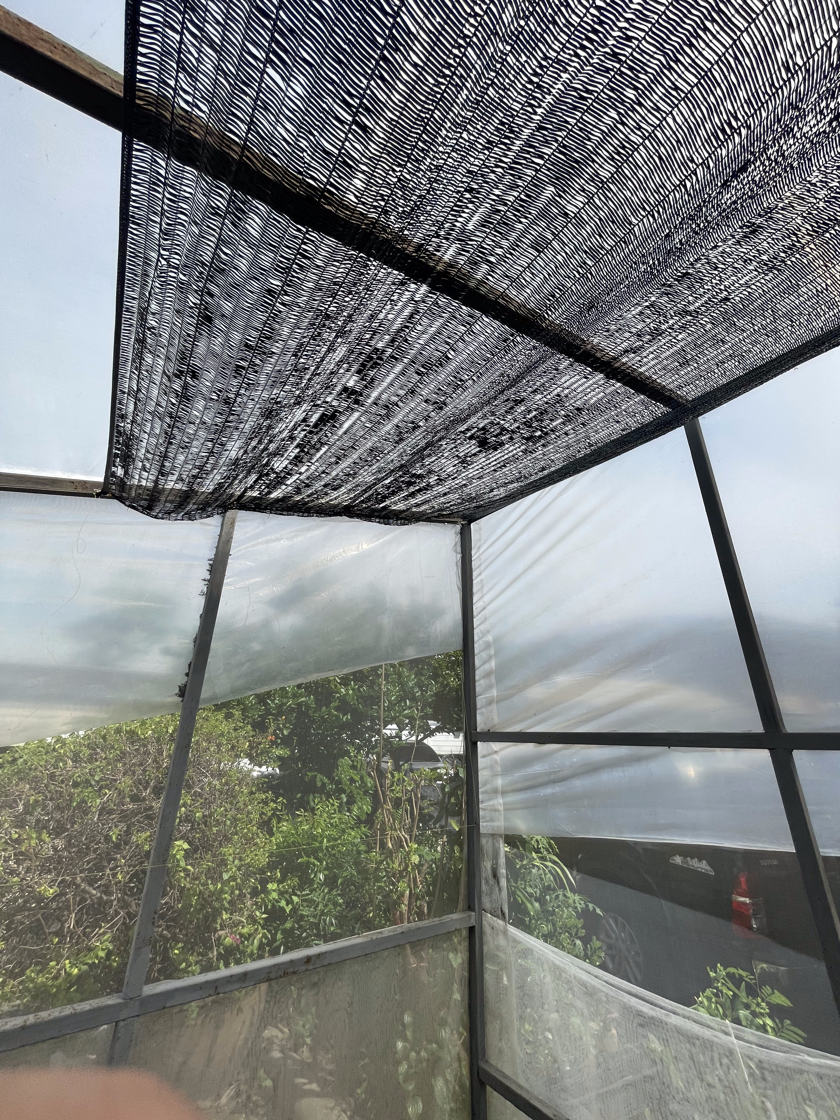
media/รูปโรงเรือนแบบชัดเจน ครบทุกมุม/IMG_2390.jpg
