stickkersz/greenhouse-iot-smart-farm/media/รูปโรงเรือนแบบชัดเจน ครบทุกมุม/IMG_2391.jpg

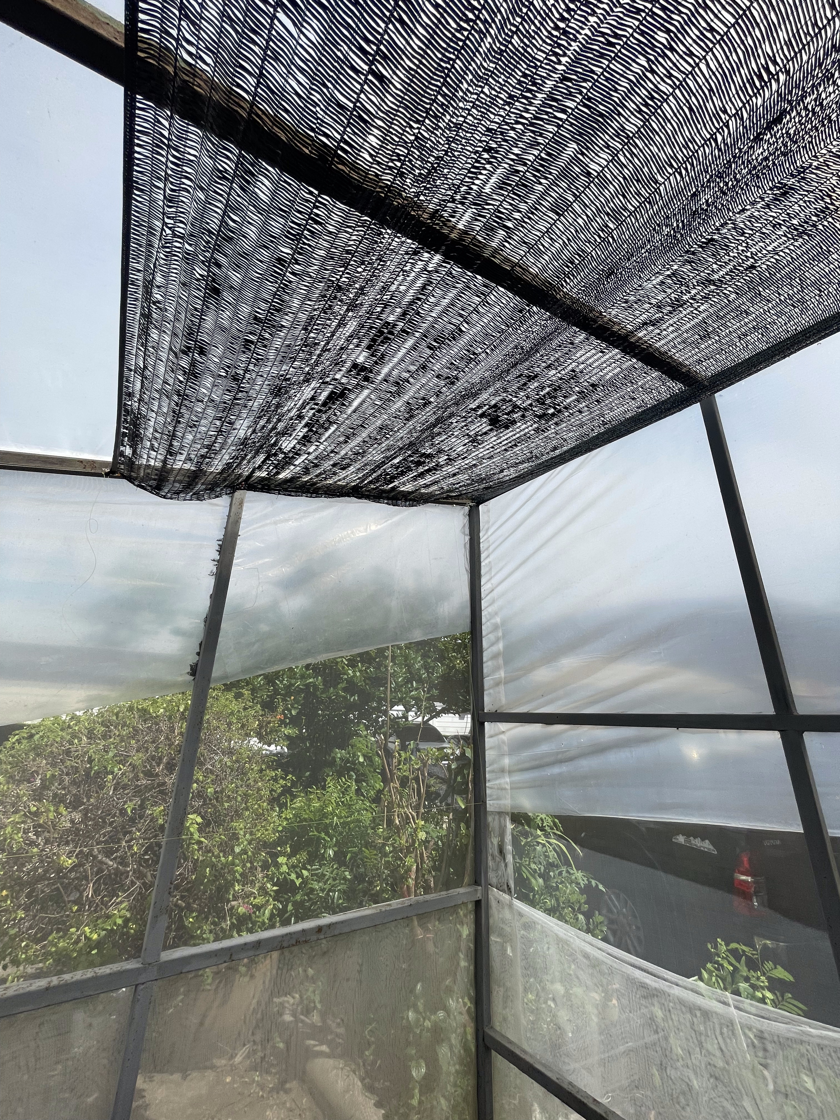
media/รูปโรงเรือนแบบชัดเจน ครบทุกมุม/IMG_2391.jpg
