stickkersz/greenhouse-iot-smart-farm/media/รูปโรงเรือนแบบชัดเจน ครบทุกมุม/IMG_2392.jpg

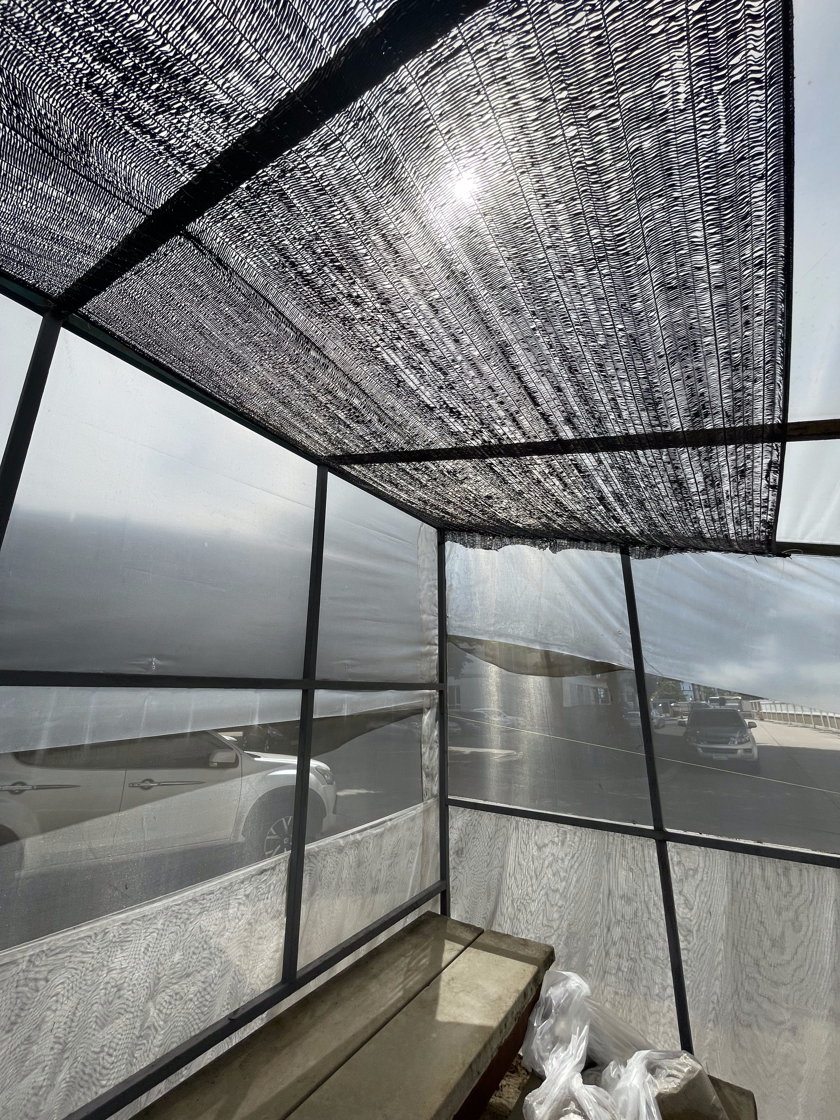
media/รูปโรงเรือนแบบชัดเจน ครบทุกมุม/IMG_2392.jpg
