stickkersz/greenhouse-iot-smart-farm/media/รูปโรงเรือนแบบชัดเจน ครบทุกมุม/IMG_2393.jpg

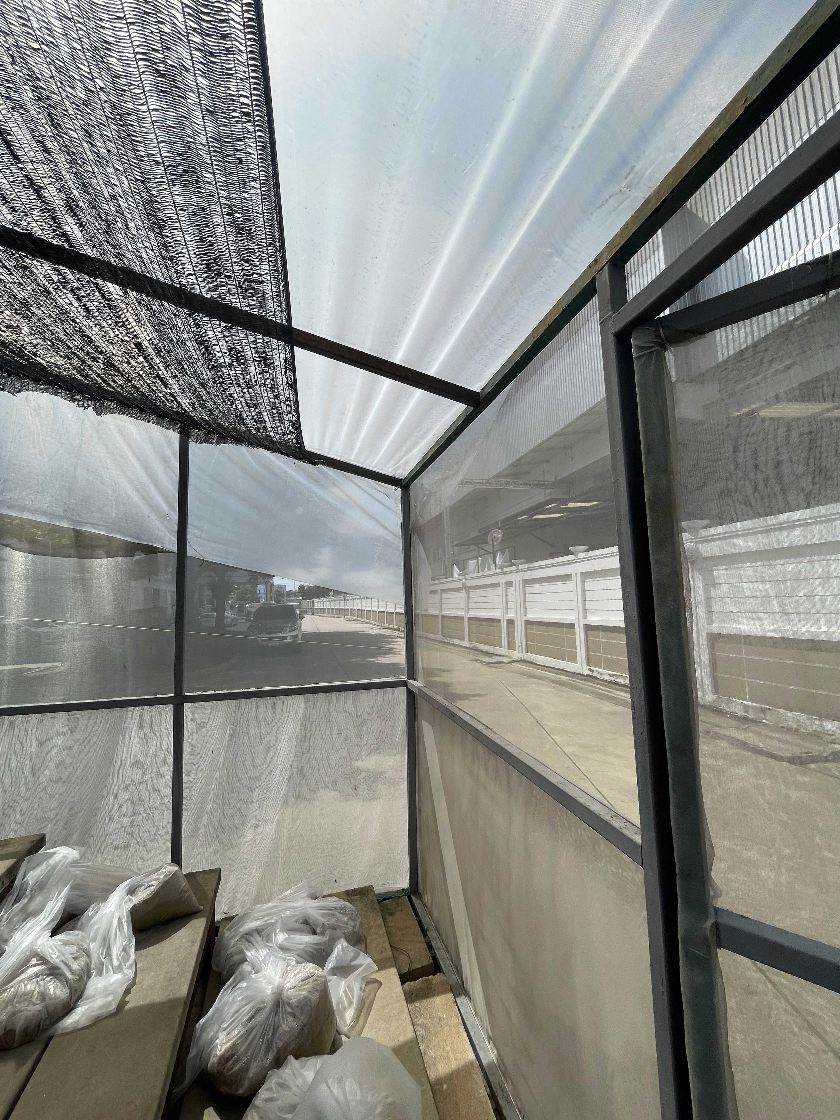
media/รูปโรงเรือนแบบชัดเจน ครบทุกมุม/IMG_2393.jpg
