stickkersz/greenhouse-iot-smart-farm/media/รูปโรงเรือนแบบชัดเจน ครบทุกมุม/IMG_2394.jpg

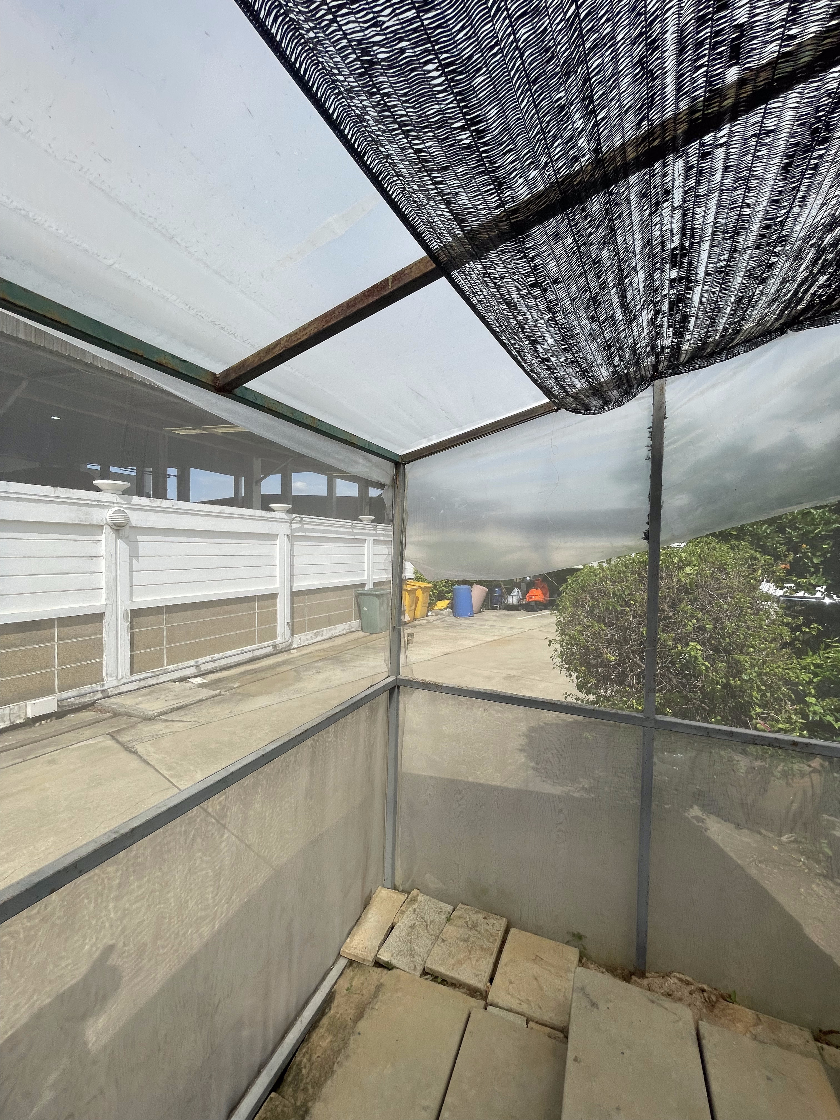
media/รูปโรงเรือนแบบชัดเจน ครบทุกมุม/IMG_2394.jpg
