stickkersz/greenhouse-iot-smart-farm/media/รูปโรงเรือนแบบชัดเจน ครบทุกมุม/IMG_2395.jpg

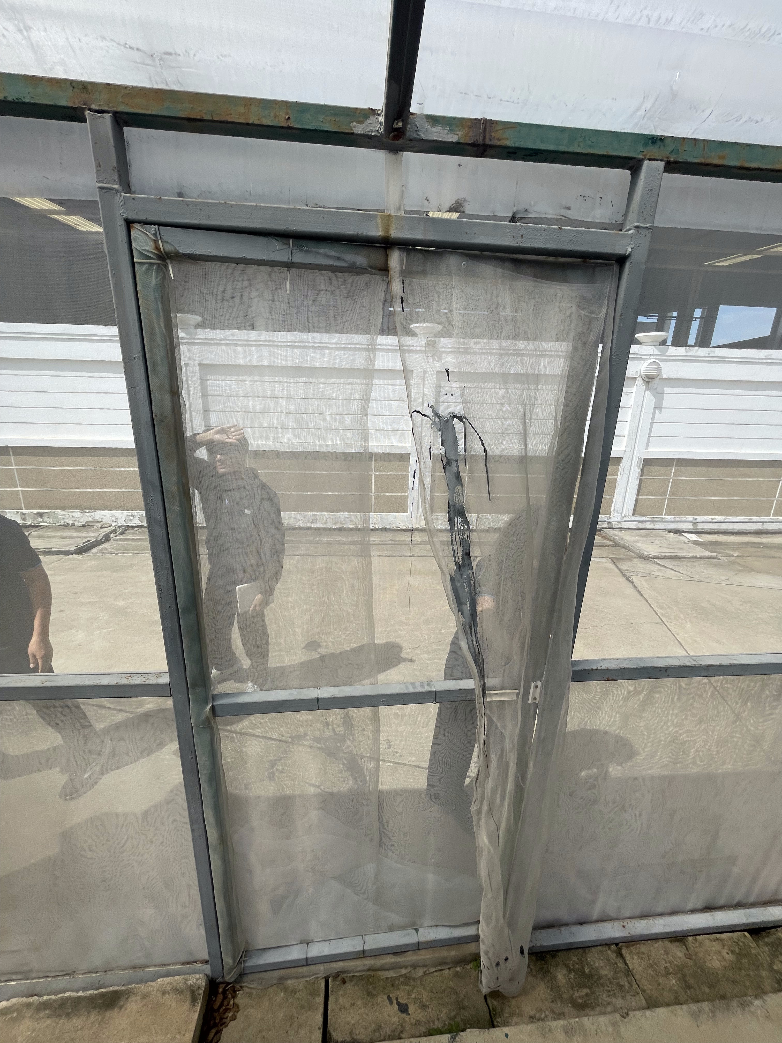
media/รูปโรงเรือนแบบชัดเจน ครบทุกมุม/IMG_2395.jpg
