stickkersz/greenhouse-iot-smart-farm/media/รูปโรงเรือนแบบชัดเจน ครบทุกมุม/IMG_2396.jpg

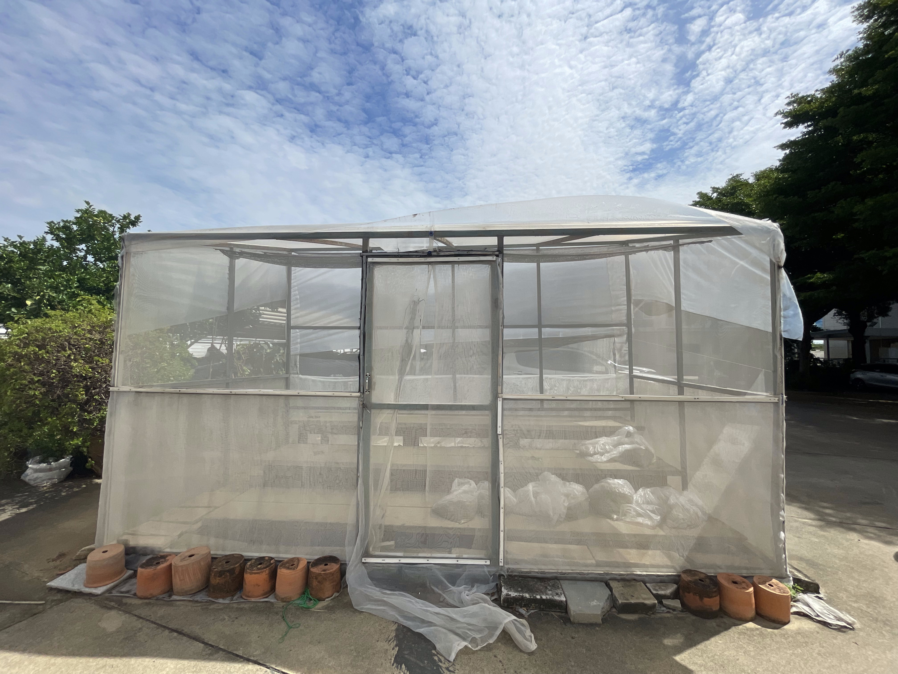
media/รูปโรงเรือนแบบชัดเจน ครบทุกมุม/IMG_2396.jpg
