stickkersz/greenhouse-iot-smart-farm/media/รูปโรงเรือนแบบชัดเจน ครบทุกมุม/IMG_2397.jpg

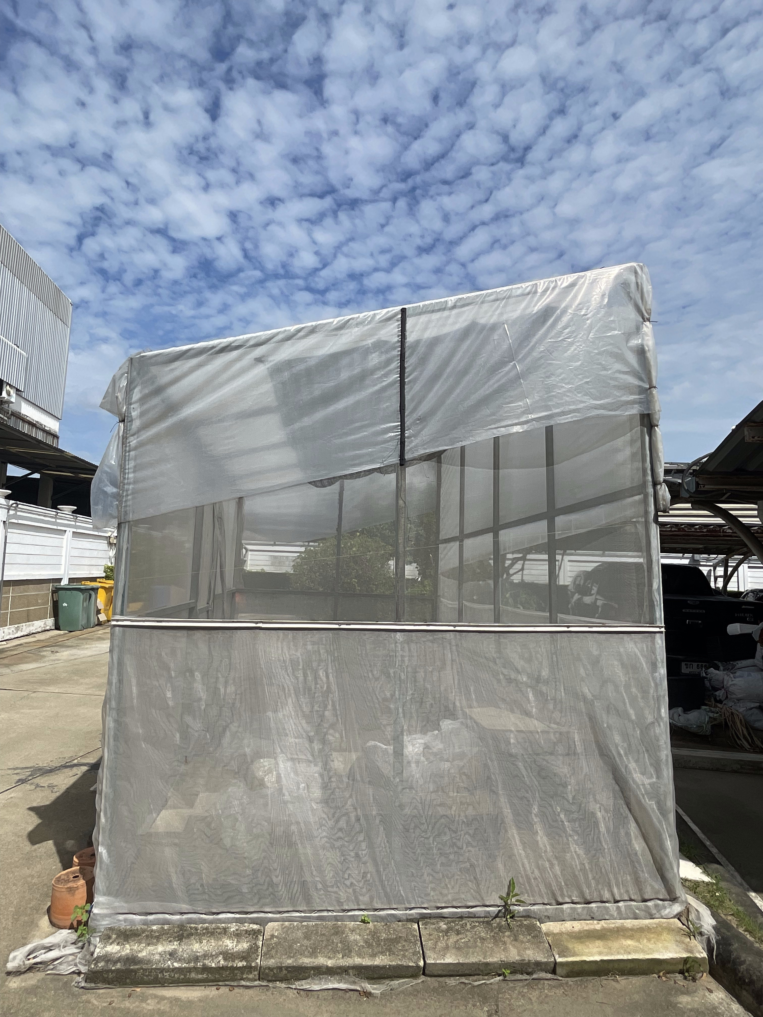
media/รูปโรงเรือนแบบชัดเจน ครบทุกมุม/IMG_2397.jpg
