stickkersz/greenhouse-iot-smart-farm/media/รูปโรงเรือนแบบชัดเจน ครบทุกมุม/IMG_2398.jpg

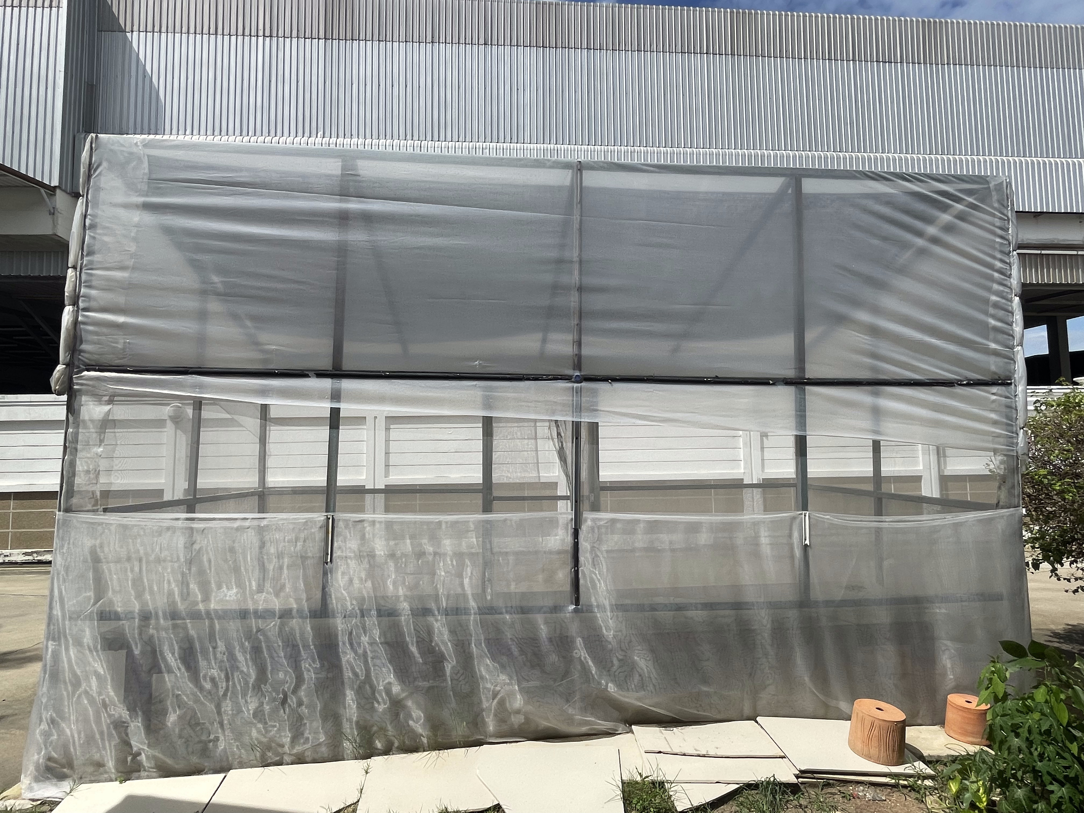
media/รูปโรงเรือนแบบชัดเจน ครบทุกมุม/IMG_2398.jpg
