stickkersz/greenhouse-iot-smart-farm/media/รูปโรงเรือนแบบชัดเจน ครบทุกมุม/IMG_2399.jpg

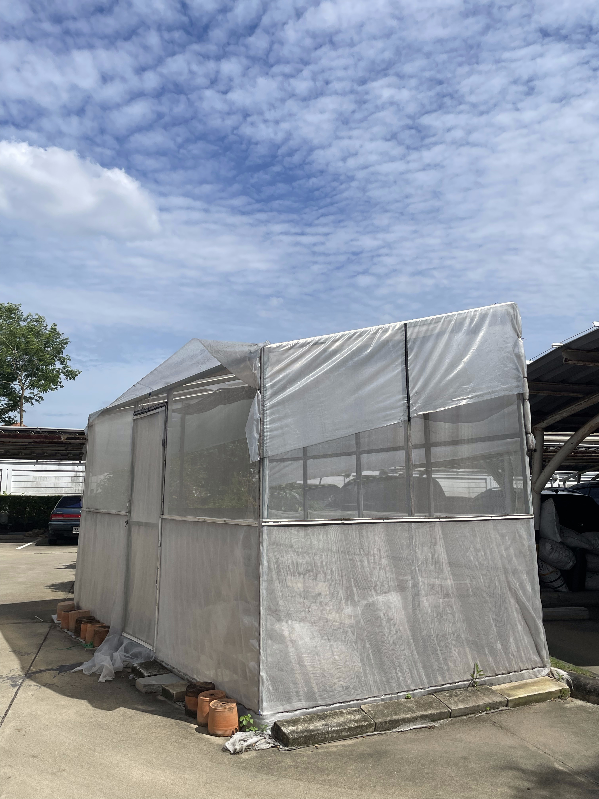
media/รูปโรงเรือนแบบชัดเจน ครบทุกมุม/IMG_2399.jpg
