stickkersz/greenhouse-iot-smart-farm/docs/DAILY_OPERATIONS_CHECKLIST.md

# เช็คลิสต์การใช้งานประจำวัน — Greenhouse IoT Smart Farm

สำหรับทีมงาน บริษัท ปุ๋ยไวกิ้ง จำกัด ทุกคนที่มี account เข้า dashboard — ไม่ต้องมีความรู้ IT ก็เช็คได้

---

## ✅ ทุกวัน (ใครก็ได้ในทีม)

- เปิด dashboard → ดูจุดสถานะมุมบนซ้าย: 🟢 ออนไลน์ = ปกติ, 🔴 ออฟไลน์ = ESP32 มีปัญหา
- ดู "เวลาอัปเดตล่าสุด" ไม่ควรเก่ากว่า ~1 นาที (ถ้าเก่ากว่านั้นมาก แปลว่าระบบค้าง)
- ถ้าเห็น badge "🔧 เซ็นเซอร์อากาศขัดข้อง" — **ปกติ ไม่ต้องตกใจ** มักหายเองใน 1–2 นาที (เกิดจาก
  มอเตอร์ปั๊มอาจรบกวนเซ็นเซอร์อากาศ SHT35 เป็นปัญหาฮาร์ดแวร์ที่รู้อยู่แล้ว ไม่ใช่บั๊กใหม่)
  ค้างนานเกิน 15 นาทีค่อยแจ้ง Nattakit Prasertsak

## ✅ ทุกสัปดาห์ (Nattakit Prasertsak หรือช่างเทคนิค)

- ตรวจสายไฟ/ขั้วต่อ โดยเฉพาะจุดปั๊มน้ำและ Relay CH4 (จุดเสี่ยง noise/ความชื้นสูงสุด)
- เช็คระดับน้ำในถังจริงด้วยตา (ระบบยังไม่มีเซนเซอร์วัดระดับน้ำอัตโนมัติ)
- เช็คว่าพัดลม 220V (CH3) หมุนจริงตอนอุณหภูมิสูง และปั๊ม (CH4) ทำงานจริงตอนความชื้นต่ำ
- ทบทวนรายชื่อ account ที่ยัง login ได้ — ปิด account ของคนที่ไม่ได้อยู่ในทีมแล้ว (ดู `TEAM_ONBOARDING.md`)

---

## 📖 ความหมายข้อความที่เจอบ่อย

| ข้อความ / สถานะ | ความหมาย | ต้องทำอะไรไหม |
|---|---|---|
| 🔴 ออฟไลน์ | ESP32 ต่อเน็ต/Firebase ไม่ได้ | เช็คไฟเข้าตู้คอนโทรล + WiFi router ถ้าเกิน 2 นาทียังไม่กลับให้แจ้ง Nattakit Prasertsak |
| 🔧 เซ็นเซอร์อากาศขัดข้อง | SHT35 อ่านค่าไม่ได้ชั่วคราว | รอ 1–2 นาที ปกติหายเอง ระบบดักไว้แล้วไม่โชว์ค่าปลอมให้สับสน |
| 🌊 เซ็นเซอร์น้ำไม่พร้อม | DS18B20 (วัดอุณหภูมิน้ำ) อ่านไม่ได้ | ถ้าค้างนานให้แจ้ง Nattakit Prasertsak (อาจสายหลุด) |
| ตัดปั๊มอัตโนมัติ (แจ้งเตือนในระบบ) | ปั๊มทำงานต่อเนื่องเกิน 10 นาที ระบบพักให้ 5 นาทีกันปั๊มไหม้/น้ำท่วม | ปกติของระบบ ไม่ใช่ error — ถ้าเกิดถี่ผิดปกติให้เช็คระดับน้ำ/threshold ความชื้น |
| "ไม่มีสิทธิ์เข้าถึงข้อมูล" | ปัญหาการล็อกอิน/สิทธิ์ | ออกจากระบบแล้วเข้าใหม่ ถ้ายังไม่ได้แจ้ง Nattakit Prasertsak |

---

## 🚨 แจ้ง Nattakit Prasertsak ทันที (ไม่ต้องรอ)

- ปั๊มน้ำไม่ยอมหยุดทำงานเกิน 15 นาที (เสี่ยงน้ำท่วม/ปั๊มไหม้ — ปกติระบบตัดเองที่ 10 นาที ถ้าเกินแสดงว่าระบบมีปัญหา)
- ระบบออฟไลน์นานเกิน 30 นาทีระหว่างเวลาทำงาน
- **กลิ่นไหม้ หรือเสียงผิดปกติจากตู้คอนโทรล/ปั๊ม/พัดลม → ตัดไฟหลักที่เบรกเกอร์ทันที** แล้วค่อยแจ้ง
  (ข้อนี้คือความปลอดภัยทางไฟฟ้าจริง ไม่ใช่แค่ปัญหาซอฟต์แวร์ อย่ารอ)

---

## ⚠️ ข้อจำกัดที่ทีมควรรู้ (ระหว่างรอแก้ hardware)

- ระบบ**ตั้งใจไม่มี** auto-restart/failsafe อัตโนมัติเมื่อเซ็นเซอร์ค้างนานผิดปกติ (ถอดออกไปแล้วหลัง
  พิสูจน์ด้วย A/B test ว่าความไม่เสถียรที่เจอเกิดจาก noise ไฟฟ้าจากมอเตอร์ปั๊ม ไม่ใช่ตัวโค้ด — เพิ่ม
  ระบบ auto-recovery กลับเข้าไปตอนนั้นแล้วยิ่งไม่ช่วย) ระหว่างที่ยังไม่ได้แก้ hardware (ใส่ตัวเก็บ
  ประจุ + RC snubber ที่ปั๊ม) **ถ้าเจอระบบค้างนานผิดปกติ ปิด-เปิดไฟตู้คอนโทรล (power cycle) ได้เลย
  ปลอดภัย 100%**
- ทุก account มีสิทธิ์คุมอุปกรณ์เท่ากันหมด (ไม่มีระดับสิทธิ์แยก) — ดู `TEAM_ONBOARDING.md`

---

*เอกสารนี้เขียนขึ้น 2026-07-07 (อัปเดต 2026-07-08 — LCD แก้แล้ว) ให้ทีมงานทั่วไปใช้ ไม่ต้องมีพื้นฐาน IT ก็เข้าใจได้
รายละเอียดทางเทคนิคลึกกว่านี้ดูที่ `PROJECT_MEMORY.md`*
