stickkersz/greenhouse-iot-smart-farm/(commit log)

2026-06-21 Initial commit — Greenhouse IoT Smart Farm v1.2.0
    - ESP32 firmware with WiFiMulti, auto/manual/schedule relay control
    - Firebase Realtime Database integration with anonymous auth
    - Web dashboard with login system, sensor gauges, relay control, history chart
    - Sensor detail bottom sheet with 24h chart and min/avg/max stats
    - Firebase Hosting deployment config and security rules
2026-06-22 feat: redesign settings + dynamic alert thresholds + presets
    [smartfarm_firmware.ino]
2026-06-22 docs: update checkpoint v1.3.0 — tested at company 2026-06-23
2026-06-26 feat: v1.3.0 — worst-case hardening + dashboard redesign
    Firmware (smartfarm_firmware.ino):
    - Watchdog timer (60s) — auto-reboot ถ้า loop ค้าง
    - Failsafe: DHT พัง → เปิดพัดลม + ปิดปั๊ม + แจ้งเตือน
    · recovery hysteresis (อ่านดีติดกัน 3 ครั้งถึงออก) กัน flapping
    · range-check (-20..70C, 0..100%) จับค่าขยะ ไม่ใช่แค่ NaN
    · re-alert buzzer ทุก 10 นาทีตราบที่ยังฉุกเฉิน
    - Pump safety: ตัดปั๊มที่ 5 นาที + cooldown 5 นาที (auto/schedule)
    - NTP resy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
    [smartfarm_firmware.ino]
2026-06-26 fix(firmware): แก้ compile error buzzerBeep + watchdog รองรับ ESP32 core 3.x
    - ย้าย default args (onMs=200, offMs=150) ไปไว้ที่ forward declaration
    แทนที่ตัวนิยาม → checkFailsafe/pumpSafetyCheck เรียก buzzerBeep(5)/(2)
    ก่อนถึงตัวนิยามได้ (เดิม: "too few arguments to function")
    - Watchdog: core 3.x init TWDT ไว้แล้ว (timeout ~5s) → ใช้
    esp_task_wdt_reconfigure() ปรับเป็น 60s กัน false-reboot ระหว่าง Firebase call
    [smartfarm_firmware.ino]
2026-06-26 feat: relay active-low config, WiFi update, relay latency fix + security redaction
    - เพิ่ม RELAY_ACTIVE_LOW flag ใน config.h.example และ firmware (LOW=เปิด, HIGH=ปิด)
    - อัพเดท WiFi: ลบ home network, เพิ่ม Lab_F2-2.4G (บริษัท Lab ชั้น 2)
    - ลด control poll interval: 5000ms → 1500ms (CONTROL_POLL_MS) สำหรับ relay response เร็วขึ้น
    - เพิ่ม pushStatus() เรียกทันทีเมื่อ relay เปลี่ยนสถานะ (ไม่ต้องรอ 30s full push)
    - Dashboard: markRelayPending() + lastRelayState + 12s timeout revert สำหรับ ins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
    [smartfarm_firmware.ino]
2026-06-30 feat: v1.4.0 — Telegram alerts, channel remap, DS18B20 hardening, remove soil
    - Telegram Alert: ESP32 ยิง Bot API ตรง (Spark free) + cooldown 5 นาที/ชนิด + toggle จาก dashboard
    แจ้ง 5 เหตุ: high_temp, low_humidity, high_water, sensor_fault, pump_cutoff
    - Relay remap ตามการเดินสายจริง: CH4=ปั๊มน้ำ, CH3=พัดลม 220V, CH1=สำรอง (CH2 ซ่อน)
    - DS18B20 hardening: กรองค่า -127/85°C + retry + แยก counter hourly log (รองรับสายยาว 4m)
    - I2C scanner ใน setup() debug LCD address (0x27/0x3F)
    - Bug fix: ไม่ push water_temp ต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
    [smartfarm_firmware.ino]
2026-07-01 fix(dashboard): กราฟย้อนหลัง — แก้ค่าเฉลี่ยน้ำเพี้ยน + fix timezone UTC+7
    - Bug: กราฟ 7d/30d ค่าเฉลี่ยน้ำถูกเจือจางเป็น 0 ตอนบางชั่วโมงไม่มี water_temp
    (DS18B20 downtime) → หารด้วย air-count แทน water-count → แก้เป็นนับ water แยก (wCnt)
    - Timezone: fix เวลาไทย UTC+7 ตายตัว (thParts/thHour/thDay/thMonth) — ไม่ขึ้นกับ
    TZ ของเบราว์เซอร์ ให้ตรงกับ path log ของ firmware (NTP UTC+7)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
2026-07-01 fix(firmware): buzzer module active-LOW — แก้ดังค้างตลอดเวลา
    - เพิ่ม BUZZER_ACTIVE_LOW flag (default true) — โมดูล buzzer 3 ขา (S/VCC/GND)
    เป็น active-LOW เหมือน relay แต่โค้ดเดิม hardcode active-HIGH ทำให้ปลายทาง
    ของทุก path (setup + buzzerBeep) จบที่ LOW = สั่งดังค้างตลอดเวลาแทนที่จะเงียบ
    - buzzerBeep() ใช้ ON/OFF ตาม flag แทน hardcode HIGH/LOW
    - boot: ตั้งเงียบก่อน แล้วทดสอบดังสั้น 100ms 1 คร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
    [smartfarm_firmware.ino]
2026-07-02 feat: auto control v2 — water-temp fan assist + pump hysteresis + finer precision
    - พัดลม (CH3): คุมด้วยอุณหภูมิอากาศ "หรือ" อุณหภูมิน้ำร่วมกัน (evaporative cooling)
    เปิดถ้าสัญญาณไหนบอกร้อน (worst-case wins), ปิดต้องเย็นพร้อมกันทั้งคู่
    fallback เป็นอากาศอย่างเดียวอัตโนมัติถ้าเซ็นเซอร์น้ำเสีย (ไม่บล็อกการทำงาน)
    - ปั๊ม (CH4): เพิ่ม hysteresis จริง (h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
2026-07-02 fix(firmware): recovery layer — กันระบบค้างถาวรเมื่อ DHT22/เน็ตพังยาว
    แก้ห่วงโซ่บั๊กที่ทำให้ระบบค้างสนิทหลังปั๊มสวิตช์แล้ว DHT22 พัง (noise จากมอเตอร์
    ปั๊ม/PWM controller รบกวนไฟเลี้ยงร่วมกับ ESP32 บน expansion board):
    - Failsafe timeout → ESP.restart() ถ้าอยู่ failsafe เกิน 5 นาทีแล้ว DHT ไม่ฟื้น
    (เดิมไม่มีทางออกถ้า DHT ตายถาวร — พัดล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
    [smartfarm_firmware.ino]
2026-07-02 feat(dashboard): global mode switch — สลับ Auto/Manual ทั้งพัดลม+ปั๊มในคลิกเดียว
    - การ์ด "โหมดควบคุมรวม" บนแท็บ Control — ปุ่ม AUTO/MANUAL ทั้งหมด สลับ CH3
    (พัดลม) + CH4 (ปั๊มน้ำ) พร้อมกัน แทนที่จะกดทีละช่อง
    - MANUAL ทั้งหมด → auto logic หยุดทำงานทันที คุมเองได้จากปุ่มแต่ละช่อง
    - AUTO ทั้งหมด → threshold เดิมใน Settings ใช้งานต่อทันท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
2026-07-02 fix(firmware): manual override ระหว่าง failsafe + heartbeat LED + ย้าย DHT/ลด I2C noise
    - Failsafe ไม่บล็อก manual/schedule อีกต่อไป — applyManualControl()/checkSchedule()
    เดิมถูก !failsafeActive กันไว้ทั้งบล็อก ทำให้สั่งปิดพัดลม/ปั๊มเองไม่ได้เลยตอนฉุกเฉิน
    แก้ให้ checkFailsafe() บังคับ safe-state เฉพาะช่องที่ยังเป็น auto จริง (ไม่ทับ manual)
    - Heartbeat LED (GPIO2) กระพริบทุก 0.5 วิ — debug เ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
    [smartfarm_firmware.ino]
2026-07-07 fix: pump-safety message consistency (10min), dashboard alert dedupe, remove Telegram/soil-moisture refs from docs
    - firmware: fix stale '5 นาที' log/alert text to match PUMP_MAX_RUNTIME_MS=10min (finalized 2026-07-07)
    - dashboard: saveAlertHistory() now dedupes via shared Firebase alert_history data instead of
    per-tab sessionStorage, fixing duplicate alert entries when multiple sessions are open
    - docs: sync PROJECT_INSTRUCTION.md + PROJECT_MEMORY.md + pinout_v2.md with actual code
    (DHT22 GPIO18 not GPIO32, company name, LCD page description, Firebase paths, pump timing)
    and fully remove/finalize Telegram Bot + Capacitive Soil Moisture (both cancelled permanently)
    - add pinout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
    [smartfarm_firmware.ino]
2026-07-07 feat: stability hardening for daily multi-user use
    Scope agreed with user: keep firmware simple (no runtime failsafe/recovery
    relay-override or auto-restart loop until pump-motor noise hardware fix is
    done), no dashboard role/permission tiers (small trusted team), but do
    harden boot-time reliability + non-technical-user UX.
    - firmware: bounded Firebase Auth retry at boot (4 attempts, then
    ESP.restart()) so the board can't get stuck silently unauthenticated
    forever after a transient network/Firebase blip — boot-time only,
    does not reintroduce the removed runtime recovery layer
    - dashboard: translate Firebase listener error codes (permission-denied,
    network-error, etc.) into plain T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
    [smartfarm_firmware.ino]
2026-07-08 docs: log LCD fix (bad unit) and DHT22-vs-DS18B20 noise proximity finding
    - LCD I2C now works after swapping the physical display unit (same wiring)
    — confirms the earlier 'no I2C device found' issue was a dead LCD, not
    wiring/code as suspected
    - Live A/B observation: DS18B20 on breadboard (far from relay cluster)
    reads fine through pump/fan switching; DHT22 direct on Expansion Board
    (close to relay cluster) still glitches during switching even though
    board power stays fine — confirms proximity to the relay/pump wiring
    matters more than connector quality (breadboard vs direct/soldered)
    - Noted an in-progress experiment: routing relay VCC through a breadboard
    rail instead of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
2026-07-08 docs: propagate LCD fix + DHT22/DS18B20 proximity finding to all remaining docs
    Brings PROJECT_INSTRUCTION.md, CHECKPOINT.md, pinout_v2.md, and
    DAILY_OPERATIONS_CHECKLIST.md in sync with PROJECT_MEMORY.md (already
    updated in the previous commit):
    - LCD I2C marked resolved everywhere it was previously flagged as broken
    (was a dead display unit, not wiring — confirmed by swapping the unit)
    - DHT22-vs-DS18B20 live A/B finding (proximity to relay cluster matters
    more than connector quality) referenced in the TODO/pinout notes so the
    next physical fix (relocate DHT22 wiring away from relay group) is
    discoverable from every doc, not just PROJECT_MEMORY.md
    - removed the now-stale 'dashbo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
2026-07-11 feat: Firebase rules hardening + test suite, tech-debt cleanup
    Rules + tests (already deployed to production, verified working):
    - Server-side validation for control node: hysteresis ordering, type
    checks, HH:MM schedule format, $other rejection — closes the gap
    where client-side-only validation could be bypassed via devtools
    - 44 rules unit tests via @firebase/rules-unit-testing + local emulator,
    covering every node (control/thresholds/status/alerts/alert_history/
    action_log/logs) and every auth boundary (email/anonymous/none)
    - Firebase emulator config in firebase.json for local test runs
    Docs cleanup (tech-debt audit):
    - Archive 8 pre-build planning docs (STATUS.md, ESP32_Firmw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
2026-07-12 feat(firmware): swap DHT22 → SHT35 (I2C), fix dashboard threshold/schedule validation
    ⚠️ NOT YET FLASH-TESTED — DHT22 proved unfixable via firmware alone (A/B test
    2026-07-03), so switching air sensor to SHT35 hoping I2C's built-in CRC
    tolerates pump/relay noise better. Evidence from 2026-07-08 (DS18B20 vs DHT22
    proximity test) suggests distance from the relay cluster matters more than
    protocol — SHT35 should be wired away from the relay cluster like DS18B20,
    not dropped into DHT22's old spot, for this to be a fair test.
    Firmware:
    - #include <DHT.h> → <Adafruit_SHT31.h>, dht22 object → sht35
    - I2C address auto-detect (0x44/0x45) folded into the existing LCD scan —
    one bus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
    [smartfarm_firmware.ino]
2026-07-14 feat: rewrite auto-control for worker clarity (fan=air-only, water=alert-only)
    Rewrote the auto-control system to be understandable for ~10 rotating
    workers. Old model coupled the fan to both air AND water temperature
    (OR-to-open, AND-to-close) which was hard to predict, and exposed 9
    threshold knobs.
    New model — one device, one sensor:
    - Fan (CH3): air temp only. air>=temp_on ON, air<=temp_off OFF.
    - Pump (CH4): humidity. <humidity_min ON, >=humidity_max OFF, dead
    sensor (humidity==0) forced OFF.
    - Water temp: display/log/alert only, no longer drives any relay.
    Worker-facing knobs cut 9 -> 6. Also:
    - water_temp_alert now Firebase-configurable (was hardcoded 35C).
    - autoControl() guard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
    [auto_control_logic.h, smartfarm_firmware.ino]
2026-07-14 fix(dashboard): correct stale text drifted from firmware reality
    Recheck after the auto-control rewrite surfaced 3 dashboard strings
    that no longer match firmware behavior:
    - air-temp badge said "ระบบเปิดปั๊ม+พัดลม" on heat; temp now drives the
    fan only (pump is humidity-controlled) -> "ระบบเปิดพัดลม".
    - removed the dead failsafe health-banner branch: firmware has pushed
    status/failsafe=false permanently since the 2026-07-03 rollback, so
    it never fired, and it still named DHT22 (now SHT35).
    - pump cooldown banner said "หลังเดินครบ 5 นาที"; max runtime is 10 min
    since 2026-07-07 (cooldown is the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
2026-07-14 feat(dashboard): wire sensor badges to live thresholds instead of hardcoded
    Air-temp, humidity, and water-temp badges used fixed cutoffs
    (38/35/30, 40/60/85, 35/28) that ignored what workers configured, so a
    custom temp_alert=42 still flipped "วิกฤต" at 38. Badges now read the
    live alertThresholds object, which the /smartfarm/control listener keeps
    in sync with saved values.
    - expanded alertThresholds to carry all 7 thresholds (was temp_alert +
    humidity_alert only); populated from Firebase on every control update.
    - badge tiers now map to the real control model + alerts:
    temp -> temp_alert / temp_on / temp_off (fan bands)
    humidity -> humidity_alert / humidity_min / humidity_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
2026-07-14 fix(dashboard): stop saveThresholds wiping 5 badge threshold fields
    The save success handler reset alertThresholds to only
    {temp_alert, humidity_alert}. Since the badge-wiring change made sensor
    badges depend on temp_on/temp_off/humidity_min/humidity_max/
    water_temp_alert too, this left those undefined after a save — air
    badge fell to "เย็น", humidity to "ปกติ", and the water badge never
    showed "ร้อน" until reload (a race with the /smartfarm/control listener
    that otherwise restores the full object).
    Removed the reset: the control 'value' listener already rebuilds all 7
    fields on every write, and checkAlerts() only needs the 2 it also
    provides.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
2026-07-14 feat: evaporative cooling — pump assists fan to lower temperature (v1.7.0)
    Fan alone only moves hot air; with the pump spraying water, the fan
    drives evaporative cooling that actually drops the temperature. Per
    request, the pump now runs when it's hot, not just when it's dry.
    Pump gains a second job (one relay, two reasons to run):
    - humidify: humidity < humidity_min ON, >= humidity_max OFF (existing)
    - cooling-assist: air >= temp_on ON, <= temp_off OFF (NEW), reusing the
    fan thresholds so there's no extra knob for workers.
    - cooling-assist is skipped when humidity >= humidity_max: spraying into
    saturated air doesn't cool, it just floods.
    - pump = humidify OR cooling; dead humidity se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
    [auto_control_logic.h, smartfarm_firmware.ino]
2026-07-15 feat: fan and pump run together on both temp and humidity (v1.8.0)
    Previously each threshold group drove one channel: temperature controlled
    only the fan (CH3), humidity only the pump (CH4). Now both groups drive
    both channels.
    This works because CH3 is an intake fan (config.h:24) — running it on dry
    air pulls humid outside air in and disperses the pump's mist, rather than
    exhausting the humidity the pump just added.
    Latches are restructured from "pump jobs" (humidify/cool-assist) to
    "weather states" (hot/dry) shared by both channels:
    fanOn = hot OR dry
    pumpOn = (hot AND not saturated) OR dry
    The fan therefore drops its stateless fanOpen/fanClose pair for a latched
    fanOn desired-s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
2026-07-15 fix: latch the humid gate so the pump stops chattering at humidity_max
    v1.8.0 applied the humid gate statelessly at the pump output
    (pumpOn = hot && !saturated). That expression has no memory, so every
    humidity crossing of pumpOffHum re-toggled the pump. Measured on the
    committed logic: temp held at 33 (inside the 32..35 dead-zone, hot latch
    armed) with humidity noise 74.5/75.2/74.8/75.1/74.6/75.3 produced 5 relay
    switches in 6 cycles, indefinitely. v1.7.0 scored 1 on the same input.
    v1.7.0 avoided this by clearing its cool latch on saturation, which forced
    a re-arm through airTemp >= fanOnTemp — a humidity dip alone could not
    restart the pump. Restoring that, as a third latch (pumpHeatOn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
    [auto_control_logic.h, smartfarm_firmware.ino]
2026-07-15 build: pin fqbn, partition scheme and library versions in sketch.yaml
    The firmware no longer fits the ESP32 default partition — it needs
    PartitionScheme=huge_app:
    default : 1388892 / 1310720 = 105% (build fails, "Sketch too big")
    huge_app : 1388892 / 3145728 = 44%
    That setting lived only in whoever's Arduino IDE last flashed the board, so
    a fresh checkout or a CLI build would fail with a size error that looks like
    a code problem. The profile also pins the core and every library to the
    versions the board is actually running, so builds are reproducible.
    `arduino-cli compile smartfarm_firmware` now picks all of this up with no
    flags; the Arduino IDE still needs Partition Scheme set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
2026-07-15 feat!: stop driving relays from stale sensor data (v2.0.0)
    BREAKING: when the air sensor fails to read SENSOR_STALE_AFTER (12) times
    in a row (~6 minutes), auto control now switches both the fan and the pump
    off, clears every latch, and raises an alert. Previously it kept running.
    The v1.7.0 "dead sensor" safety never worked. readSensors sets airHumidity
    to 0 on a bad read, but that assignment sits in the airBad branch — only
    good readings reach the control buffer. So avgCtrlAH() could only return 0
    if the SHT35 reported a genuine, CRC-valid 0.0 %RH, which does not happen.
    The real behavior: the buffer kept the last good values forever and
    autoControl went on commanding relays from data t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
    [auto_control_logic.h, smartfarm_firmware.ino]
2026-07-15 fix: close the silent-failure gaps the v2.0.0 review found
    Six fixes, two of them real holes in the safety v2.0.0 just added.
    Sensor missing at boot was not covered. If the SHT35 cable is loose before
    power-on, the I2C scan finds nothing, shtAddr stays 0, and readSensors took a
    branch that printed and returned without touching airSensorFailCount. The
    counter stayed at 0 forever, so sensorOk was true, status/sensor_ok published
    true and status/sensor_stale published false. autoControl bailed on an empty
    buffer so the relays were at least frozen, but the dashboard showed a healthy
    sensor and nothing raised an alert — the exact silent failure v2.0.0 exists to
    prevent, in the more likely of t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
    [smartfarm_firmware.ino]
2026-07-15 feat: keep alerting and recover WiFi when the network drops (v2.1.0)
    Two holes that only open when WiFi goes away.
    The buzzer needed the internet to sound. checkAlerts() was called from inside
    `if (Firebase.ready())`, so losing the network silenced every local alarm —
    critical heat with nobody in range to hear it, even though the buzzer is a
    local device wired to the board and needs no network at all. checkAlerts()
    now runs unconditionally, and reportAlert() splits the two concerns: serial
    and buzzer always fire, Firebase writes only when there is somewhere to send
    them. That also collapses four copies of the same three-line write block.
    WiFi could drop permanently with no way back. The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
    [smartfarm_firmware.ino]
2026-07-15 fix: cover pushStatus with the SSL guard, latch the last 3 spam logs (v2.1.1)
    The 2-second SSL guard in loop() only knew about pushToFirebase(). Its
    comment says "wait 2s after push to avoid SSL collision", but lastPushTime was
    assigned in exactly one place — after pushToFirebase() in the 30s block. The
    manual-change path calls pushStatus() directly, which fires 13 setBool writes
    and never touched the timestamp, so the control poll 1.5s later sailed past
    the guard and issued a getJSON straight into the connection those writes had
    just finished with. That is precisely the collision the guard exists to
    prevent. lastPushTime now lives in pushStatus(), the one function both paths
    go through. P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
    [smartfarm_firmware.ino]
2026-07-16 feat: keep the greenhouse running continuously across reboots and network loss (v2.2.1)
    Root problem reported: ESP32 restarts on its own, and each restart wiped the
    hourly accumulators and dropped into an endless WiFi-reconnect loop. This does
    not fix the unknown restart cause — it stops one restart from cascading, and
    adds the diagnostics needed to find the cause on hardware.
    v2.2.0 — reboot is a last resort, not an error handler:
    - setup() no longer ESP.restart() on WiFi/Firebase-auth failure; it falls into
    loop(), which already tolerates 30 min offline while auto control keeps running
    - WiFi-offline restart is now one-shot (RTC-latched) instead of firing every
    30 min forever when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
    [smartfarm_firmware.ino]
2026-07-16 docs: sync reference docs to firmware v2.2.1 and the real data contract
    Several docs described an older or wrong system. Fixed the factual/data errors;
    left dated historical snapshots and the DHT22->SHT35 migration narrative intact.
    - Firebase_Database_Structure.md: full rewrite against database.rules.json and
    the firmware's actual writes. Was documenting SHT40 (it's SHT35), soil-moisture
    sensors that don't exist, ch4_led with a "timer" mode (CH4 is the pump,
    auto/manual), firmware_version/last_seen keys never written, unbuilt Line
    Notify, and test-mode rules. Now: correct channel semantics, full status field
    list incl. v2.2.0 boot diagnostics, real alert types, logs/ at root.
    - P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
2026-07-17 fix: flip dashboard to Offline when board is dead on cold page load
    The offline detector and updateHealth() both gated on `lastSensorTs`, which
    stays 0 until the first sensor event arrives. A board that was already dead
    (or powered off) before the tab opened never fires that event, so lastSensorTs
    never leaves 0 — the `if (!lastSensorTs) return` timer bailed every tick and
    the `lastSensorTs && ageMs > ...` health branches were skipped. Meanwhile
    Firebase replays the last-persisted status/online=true on load, so the tab
    showed a green "Online" for a board that had been dead for hours.
    Measure staleness from pageLoadTs when no data has ever been seen this session:
    a never-seen board now fli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
2026-07-23 feat: decouple fan from pump safety lock (v2.6.0)
    Fan no longer blacks out during the pump's 15-min safety cooldown. CSV
    2026-07-20 showed 7h ≥34°C in dry air (ideal evaporative window) with the
    system idle ~33% of the time because v2.3.0 rested the fan together with
    the pump. The fan has no dry-run risk, so it now runs on dec.fanOn alone
    and rests only when the hot/dry latch clears.
    - pumpSafetyCheck(): cut pump only; remove fan cutoff + fanLockUntil
    - autoControl(): drop the millis() >= fanLockUntil gate on fan-ON
    - delete fanLockUntil; status/fan_locked pinned false (dashboard compat)
    - invariant pumpOn -> fanOn preserved (auto_control_logic.h untouched)
    Also fixes from code review: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
    [smartfarm_firmware.ino]
2026-07-23 feat: fan vents to exhaust humidity at settable RH threshold (v2.7.0)
    Some days it rains and RH spikes past 80% while it isn't hot. Before, the
    fan sat idle (fan = hot OR dry only) and moisture stayed trapped. Adds a
    "wet" latch: RH >= humidity_vent turns the fan on to vent, staff-settable
    from the dashboard. Pump is untouched (vent controls the fan only).
    auto_control_logic.h:
    - new wet latch with hysteresis (on >= ventOn, off <= ventOff = ventOn-5%)
    - fan = hot OR dry OR wet; pump unchanged
    - ventOnHum <= 0 disables the feature (appended struct fields zero-init, so
    old 10-value initializers and tests keep the exact prior behavior)
    - sensor-bad path clears the wet latch too
    firmware:
    -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
2026-07-24 fix: require vent >= humidity_max + VENT_HYST to end pump-vs-vent conflict (v2.7.1)
    v2.7.0 only required humidity_vent > humidity_max, which is insufficient.
    The wet latch holds across [ventOff, ventOn) but the pump is only blocked
    once RH >= humidity_max. When ventOff < humidity_max there is a humidity
    band where the fan vents moisture out while the pump sprays it back in.
    humidity_max=79, humidity_vent=80 -> ventOff=75; at RH 76 in hot air,
    wetOn=1 and pumpOn=1 simultaneously.
    Correct constraint is humidity_vent >= humidity_max + VENT_HYST (so
    ventOff >= humidity_max). It must be >=, not >, since all three seasonal
    presets sit exactly on that boundary (75+5=80, 85+5=90).
    Changes:
    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
    [auto_control_logic.h, smartfarm_firmware.ino]
2026-07-24 feat: fan rests with pump — 15 min max runtime + 5 min shared cooldown (v2.8.0)
    Per on-site request: give the fan the same 15-minute max continuous
    runtime as the pump, then rest both together for 5 minutes.
    This REVERTS the v2.6.0 decouple. v2.6.0 separated the fan because CSV
    2026-07-20 showed the shared rest left the fan dark ~33% of a 7-hour hot
    spell, causing temperature overshoot. v2.8.0 re-couples them at the user's
    explicit direction, accepting that overshoot trade-off (the fan can now go
    dark during heat while the pump is in cooldown).
    - pumpSafetyCheck() is now a single combined check: it tracks continuous
    runtime per channel (pumpOnSince / fanOnSince). When either hits 15 mi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
    [smartfarm_firmware.ino]
2026-07-24 fix: v2.8.0 review — no false water alarm on fan-only cutoff, show fan_locked
    Code review of the v2.8.0 fan-rest diff found three real regressions:
    1. False water alarm (main bug). The combined cutoff unconditionally pushed
    a 'pump_cutoff' / "check water level" alert + buzzer even when the FAN was
    the trigger and the pump never ran — e.g. hot+humid or rainy days where the
    fan runs 15 min alone. That fired a water alarm + double beep every ~20 min
    all afternoon. Now the water alert + buzzer fire only when the pump maxed;
    a fan-only cutoff pushes a low-key 'fan_cutoff' info message, no buzzer.
    2. status/fan_locked was published again in v2.8.0 but the dashboard never
    re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
    [smartfarm_firmware.ino]
2026-07-30 fix: Wi-Fi reconnects reliably again (v2.9.0) + pump/fan cooldown desync
    Two fixes.
    1. v2.8.0 review follow-up — cooldown lock desync
    pumpSafetyCheck() only set a channel's cooldown lock when that channel was
    in auto/schedule mode. If the pump was manual at cutoff, pumpLockUntil was
    never set; flipping the pump back to auto inside the 5-minute window let it
    run while the fan was still locked off — the exact "pump sprays with no fan"
    case v2.8.0 exists to prevent.
    Both locks are now set on every cutoff regardless of mode. Relay force-off
    stays gated on auto, so manual channels are still left to the operator. The
    locks are only read on the auto and schedule paths (manual deliberately
    ig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
    [smartfarm_firmware.ino]
2026-07-30 fix: cooldown locks survive the millis() rollover at ~49.7 days
    Found while auditing after the Wi-Fi work; never observed in the field yet.
    Six sites compared millis() directly against pumpLockUntil / fanLockUntil.
    Direct comparison breaks silently when millis() wraps at 2^32 ms:
    - Worst case: the counter wraps while a lock is pending. millis() is then
    smaller than lockUntil for another ~49 days, so the fan and pump stay
    locked off that entire time with nothing in the log to say why — auto
    simply never engages a channel. Silent loss of climate control.
    - Milder case: now + COOLDOWN overflows when the lock is set, yielding a
    small deadline that reads as already expired, so the res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
    [auto_control_logic.h, smartfarm_firmware.ino]
2026-07-30 feat: surface Wi-Fi/boot diagnostics on the dashboard, test the safety timers
    Two follow-ups from the audit.
    Dashboard visibility
    status/wifi_rssi was being read into sysStatus and then never displayed
    anywhere, and the new wifi_drop_count / wifi_drop_reason had the same
    problem — you had to open the Firebase console to see any of it, which is
    useless while diagnosing "it keeps dropping". Adds a Wi-Fi chip showing
    RSSI plus drop count, with the disconnect reason in the tooltip.
    Same treatment for last_reset_reason and boot_count, which firmware has
    been pushing since v2.2.0 with nowhere to show them. Those are what the
    still-open self-restart investigation needs.
    Also adds a chip-warn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
    [auto_control_logic.h, smartfarm_firmware.ino]
2026-07-30 docs: drop all Telegram references, keep the token revocation open
    The feature itself was removed from firmware, config, and dashboard back on
    2026-07-03; only documentation mentions were left, all of them "this was
    removed" bookkeeping. Those are gone now — zero occurrences remain in
    tracked files. Sections that described the integration are reworded to state
    what the system actually does: alerting is buzzer (local, works offline)
    plus the dashboard, with nothing leaving the network.
    Deliberately NOT deleted: the reminder to revoke the old bot token. That
    token was committed in PROJECT_MEMORY.md and is still in git history, so
    removing the text does nothing to it — only /revoke in @Bot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
2026-07-30 test: guard VENT_HYST against drifting apart across its three layers
    VENT_HYST has to exist in three places — auto_control_logic.h, the
    dashboard's VENT_HYST_PCT, and three literals inside database.rules.json —
    and nothing kept them in agreement. Tuning the C++ constant left the other
    two stale, and the failure is silent and confusing: rules start rejecting
    values that firmware happily accepts, which surfaces only as "the dashboard
    won't save my thresholds" with no reason given.
    Adds tests/vent_hyst_sync.check.js, wired up as npm run test:sync and
    included in npm test. It reads the C++ constant as the source of truth and
    asserts the dashboard constant matches, that each of the three rul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
    [auto_control_logic.h]
2026-07-30 fix: water temp reaches the dashboard again (cross-listener race)
    Reported from the field: the board reads the DS18B20 fine and the LCD shows
    the correct value, but the dashboard stays stuck on "เซ็นเซอร์น้ำไม่พร้อม".
    Not the sensor, and not the firmware. The water card was rendered only
    inside the /smartfarm/sensors listener, but the condition it branches on
    (sysStatus.water_ok) is owned by the /smartfarm/status listener. Two
    listeners, two independent firings.
    pushToFirebase() writes sensors/water_temp roughly 20 writes before
    pushStatus() gets to status/water_ok, so on the cycle where the sensor
    recovers:
    1. sensors/water_temp = 27.3 arrives; t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
2026-07-30 docs: close out the bot token item as accepted risk, not a pending task
    Repo visibility turned out to be the deciding fact I had not checked when I
    first flagged this. stickkersz/greenhouse-iot-smart-farm is private, so the
    old credential was never publicly exposed, and it grants access only to an
    unused Telegram bot — nothing in the greenhouse, Firebase, or the relays.
    My earlier framing of this as urgent was wrong.
    Given that, the user decided not to act on it. Removing the two "action
    required" entries (PROJECT_INSTRUCTION.md TODO list, PROJECT_MEMORY.md §15)
    since no action is planned and leaving red markers on a decision already
    made just misleads whoever reads next.
    Section 6 keep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
2026-07-30 test: spell out the vent-disabled config instead of relying on zero-init
    Four AutoControlInputs initializers passed only 10 of 12 fields and let
    ventThreshold and wetOn zero-init, which -Wall -Wextra flagged as
    missing-field-initializers on every build of test:logic.
    Behavior was correct — 0 means the vent feature is off, which is the
    pre-v2.7.0 path those cases are meant to cover — but leaving it implicit cost
    two things. The four warnings were constant noise that would camouflage a
    genuine missing-initializer warning later. And reading a case gave no
    indication of whether vent was on or off without counting struct fields by
    hand: a past session misread two sweeps as testing the same c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
2026-07-31 fix: dashboard stops going stale while the board is healthy (v2.9.1)
    Two fixes, both flashed and confirmed on hardware 2026-07-31.
    Reported from the field: the dashboard froze on "ข้อมูลค้าง 119 วินาที" while
    the LCD kept updating and the greenhouse kept controlling itself. Neither the
    DS18B20, the cross-listener race fixed in a5a57f4, the Wi-Fi reconnect path
    fixed in 922cdae, nor a brownout — status/wifi_drop_count read 0 across the
    whole outage and the clock stayed synced.
    1. 24 SSL round trips per push cycle
    pushStatus() and pushToFirebase() sent one Firebase.setX() per field: 21 + 3 =
    24 separate TLS round trips every 30 s. At RSSI -76 a single cycle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
    [smartfarm_firmware.ino]
2026-08-03 chore: archive superseded pinout doc
    pinout_v2.md at root is current reference; pinout.docx/pinout.pdf
    predate it, moved to docs/archive alongside the other pre-build docs.
2026-08-03 fix: reboot loop from blocking NTP wait past the watchdog (v2.9.2)
    syncNTP()'s wait loop called getLocalTime(&t) without the second
    argument, defaulting to a blocking 5000ms per try — worst case
    20 x (5000+500) = 110s in one loop() pass against WDT_TIMEOUT_S 60.
    TASK_WDT rebooted the board, which came back with an unset clock and
    repeated it (boot_count 11 -> 19 in ~1 day). Now uses the existing
    non-blocking readLocalTime(), bounding the wait at 10s; watchdog
    stays armed as the last-resort catch for this class of bug.
    Also: wifi_drop_count now increments once per offline episode instead
    of once per failed retry event, self-triggered disconnects no longer
    overwrite wifi_drop_reason with a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
    [smartfarm_firmware.ino]
2026-08-03 chore: organize root clutter into docs/ and media/
    Root had 9 project markdown docs, 2 report docx, 2 pdfs, and 32 photos
    (7 flat jpg + two Thai-named photo folders) sitting loose next to the
    actual repo config/code. None of it is referenced by code or build
    config (checked), so this is pure filesystem tidying:
    - docs/ 9 root-level *.md docs (Firebase structure, pinout,
    project memory, onboarding, checklists, etc.)
    - docs/reports/ user manual + final report docx, plus the two pdfs
    (shopping list, assignment brief)
    - media/ board-photos/ (7 jpg) + the two existing photo folders
    Updated README.md and docs/archive/README.md menti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
2026-08-03 docs: update pinout to v2.9.2, drop old pinout.docx/pdf for good
    pinout_v2.md renamed to pinout.md — the old docx/pdf it superseded
    are deleted outright now, not just archived, so there's one canonical
    file and no more "_v2" hanging off the name.
    Content brought current: firmware v2.2.1 -> v2.9.2, pump/fan max
    runtime 10min -> 15min (code has been at 15 since 2026-07-20), and
    the DS18B20 pull-up note now says what the .ino comments actually
    warn about — 4.7k to 3V3 only, never VCC/5V (exceeds GPIO abs max via
    the pin's ESD clamp).
    Updated every doc that pointed at the old filenames (README,
    PROJECT_INSTRUCTION, HANDOFF_GUIDE, archive/README).
2026-08-03 docs: fix stale technical content in PROJECT_INSTRUCTION and Firebase_Database_Structure
    Both were stamped v2.2.1 (July) and had drifted from what's actually
    running:
    PROJECT_INSTRUCTION.md — hardware table still listed DHT22 on GPIO18
    (replaced by SHT35 I2C on 2026-07-11, a month stale) and DS18B20
    pull-up as 5.1k to VCC (actually 4.7k to 3V3 only — 5V clips the GPIO
    via its ESD diode). Auto-control section only documented 2 latches
    (hot/dry); rewrote to all 4 (hot/dry/pumpHeat/wet-vent) matching
    auto_control_logic.h. Pump runtime 10min -> 15min. File tree still
    showed the pre-reorg root layout.
    Firebase_Database_Structure.md — status/ block was missing fan_locked,
    wifi_drop_count,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
2026-08-03 docs: fix budget section in final report
    Corrected water pump price (980 -> 1,500 บาท, actual cost not the
    quoted estimate) and added 12 missing hardware items that were
    purchased but never itemized: ESP32 DevKit V1, SHT35, LCD I2C, Expansion
    Board HW-777, Buzzer, PSU S-120-12, misting nozzles/tubing, 3x IP65
    enclosures, the 220V exhaust fan, a second boost converter (150W),
    XL4005, and jumper wires. Total goes from 1,705.00 to 10,500.50 บาท.
    Reworded the summary line and the stale caveat paragraph that used to
    list these exact items as "not yet included" — they are now. Still
    excluded: wiring labor (no recorded price).
2026-08-03 docs: fan (CH3) budget line is 2 units, not 1
    Combined 4,500 บาท was for 2 fans, not 1 — qty 1->2, unit price
    4,500.00->2,250.00. Row total and grand total (10,500.50) unchanged.
2026-08-03 fix: move pump relay from GPIO25 to GPIO27 (CH4/CH2 swap)
    Pump had a problem on GPIO25 (senior's call). Swapped which physical
    GPIO drives CH4 (pump) vs CH2 (unused/hidden) — CH4 now GPIO27, CH2
    now GPIO25. Firmware always addresses relays through the
    PIN_RELAY_CH* symbols, never a hardcoded pin number, so this is a
    config-only change: no Firebase key, dashboard, or auto-control logic
    touched. Neither pin is a strapping pin, so this swap carries none of
    the GPIO12 boot-fail risk.
    Updated the real local config.h (gitignored, not part of this commit)
    plus config.h.example and every doc that documents the mapping
    (README, pinout.md, PROJECT_INSTRUCTION, Firebase_Database_Structure).
    Still n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
2026-08-04 fix: dashboard and .ino comments still showed pre-swap CH2/CH4 GPIOs
    /code-review caught 4 stale references left behind by 7d4d434 (the
    GPIO25->27 pump swap): the pump relay card and channel-assignment
    panel in dashboard/index.html still labeled CH4 as GPIO25 and CH2 as
    GPIO27, and two header comment blocks in smartfarm_firmware.ino
    (hardware summary + Role->Channel mapping) still documented the old
    wiring. Display/comment-only — firmware logic was never affected,
    since relays are always driven through the PIN_RELAY_CH* symbols, not
    hardcoded pin numbers.
    Also tightened the GPIO12 warning in pinout.md and HANDOFF_GUIDE.md
    to note the pump moved through GPIO25 and is now on GPIO27, so it
    d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
    [smartfarm_firmware.ino]
2026-08-04 fix: pump chatter when air stays hot, plus 4 more review findings (v2.9.3)
    Main bug (auto_control_logic.h): pumpHeat's re-arm condition checked a
    level, not an edge. Its own comment promised "cleared by the humid gate
    means you must cross fanOnTemp again to re-arm", but the code read
    `else if (airTemp >= fanOnTemp) pumpHeat = true`, which is trivially
    true on every cycle once the air is genuinely hot and stays hot. So
    whenever humidity drifted back and forth across humidity_max on a hot
    afternoon, the pump switched on and off every 30s sensor cycle — the
    exact chatter this latch design exists to prevent, and a failure mode
    this project has already traced hardware damage to.
    Verified by co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
    [auto_control_logic.h, smartfarm_firmware.ino]
2026-08-04 fix: surface firmware alerts on the dashboard, 3 more review findings
    The dashboard never read /smartfarm/alerts/last_alert — grep found no
    reference to it anywhere in index.html or sw.js. checkAlerts() only
    re-derived high-temp and low-humidity client-side from live sensor
    values, so everything only the board can detect went nowhere: the
    15-minute pump/fan safety cutoff, sensor_fail (auto control halted),
    and high water temp (the dashboard never even passes water temp into
    checkAlerts). Firmware wrote those to Firebase and nothing displayed
    them — no banner, no notification, no history row.
    Added a listener that maps them onto the existing banner/notify/history
    pipeline. Two details wo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
2026-08-04 docs: bump to v2.9.3 across all six version locations
    Firmware behavior changed (pumpHeat gating), so the version moves with
    it. All six places per the checklist at the top of the sketch: sketch
    header, serial banner, LCD splash, pushStatus(), dashboard footer, and
    README (badge plus the post-flash verification steps that tell whoever
    flashed the board which number to look for).
    Added the v2.9.3 changelog to both the sketch header and README, and
    corrected the README's pumpHeat latch row — it said the latch turns on
    at "temp >= temp_on", which is what the buggy code did; it now says
    "crosses up through", which is what the fix actually implements.
    [smartfarm_firmware.ino]
2026-08-04 fix: revert pump GPIO to 25, plus the alert path review sweep (v2.9.4)
    Two things, both from a final review pass before handoff.
    ## Pump GPIO reverted to 25 (CH2 back to 27)
    Commit 7d4d434 moved the pump from GPIO25 to GPIO27, swapping with the
    then-idle CH2, to route around relay board channel 4 — which is dead.
    That build was never flashed. config.h's mtime is 22:23 on 2026-08-03,
    about eleven hours after v2.9.2 went onto the board that morning, and
    the board still reports firmware 2.9.2 today. The senior fixed it on the
    hardware side instead, and the pump works with the board still driving
    GPIO25. User confirmed on 2026-08-05 that no reflash happened after that
    date.
    So flashing HEAD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
    [smartfarm_firmware.ino]
